TickingClocks/Zoetrope-Carousel-V4/Electrical/01b_V4 Electrical Plots/photos/deadbug wiring.jpg

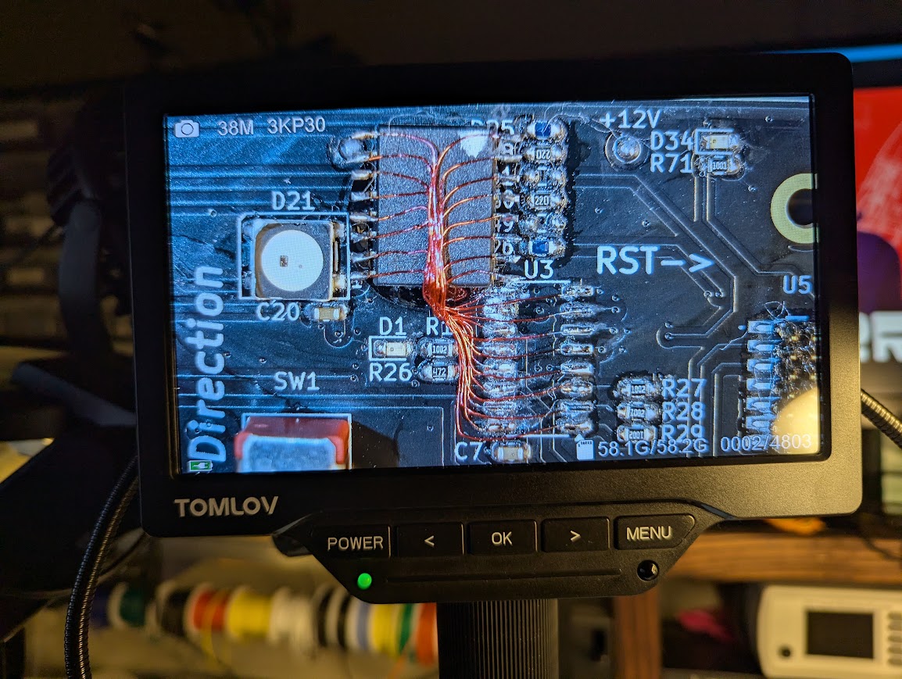
Electrical/01b_V4 Electrical Plots/photos/deadbug wiring.jpg
