TickingClocks/Zoetrope-Carousel-V4/README.md

# Zoetrope-Carousel-V4
repository for the Zoetrope Carousel V4
