TickingClocks/Zoetrope-Carousel-V4/Mechanical/Platters/Phenakistoscopes/Rats/Rats_Hueforge_describe.txt

Print at 100% infill with a layer height of 0.08mm with a base layer of 0.16mm

 The Model is 200x194.16mm in size
 You may print at higher layer heights below the Min Depth of 0.48mm
 The Max Depth is 3mm and the Actual Depth is 3.1mm

Filaments Used:
	PETG JAYO Black Transmission Distance: 0.3
	PETG JAYO Gray Transmission Distance: 2.5
	PLA BambuLab Matte Ivory White Transmission Distance: 3.5
This print uses 3 unique filaments

!!!!  It appears you have mixed filament types.  Be certain this is what you want.  !!!!!

Swap Instructions:
	Start with Black
	At layer #13 (1.12mm) swap to Gray
	At layer #22 (1.84mm) swap to Ivory White for the rest.
