TickingClocks/Zoetrope-Carousel-V4/Electrical/01a_V4 - Saber - Spot Light/slip ring gooseneck assembly/DXF for PCB/slip ring gooseneck assembly PCB outline_V1.DXF

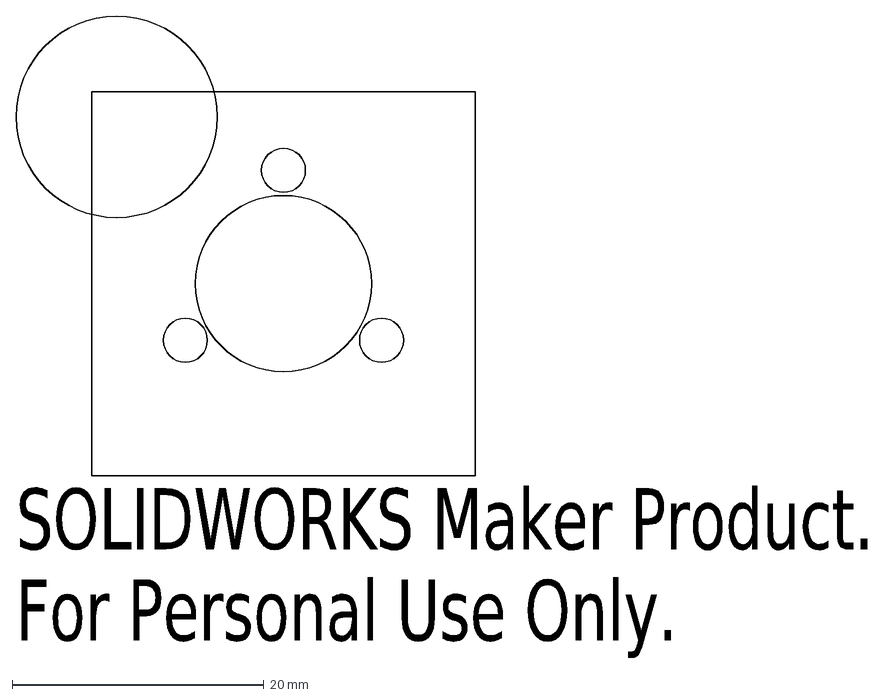
[picture p51: CAD file, 2026-05-01]
Electrical/01a_V4 - Saber - Spot Light/slip ring gooseneck assembly/DXF for PCB/slip ring gooseneck assembly PCB outline_V1.DXF
SOLIDWORKS Maker Product.
For Personal Use Only.
