TickingClocks/Zoetrope-Carousel-V4/Electrical/01a_V4 - Saber - Spot Light/slip ring gooseneck assembly/slip ring gooseneck assembly.SLDPRT

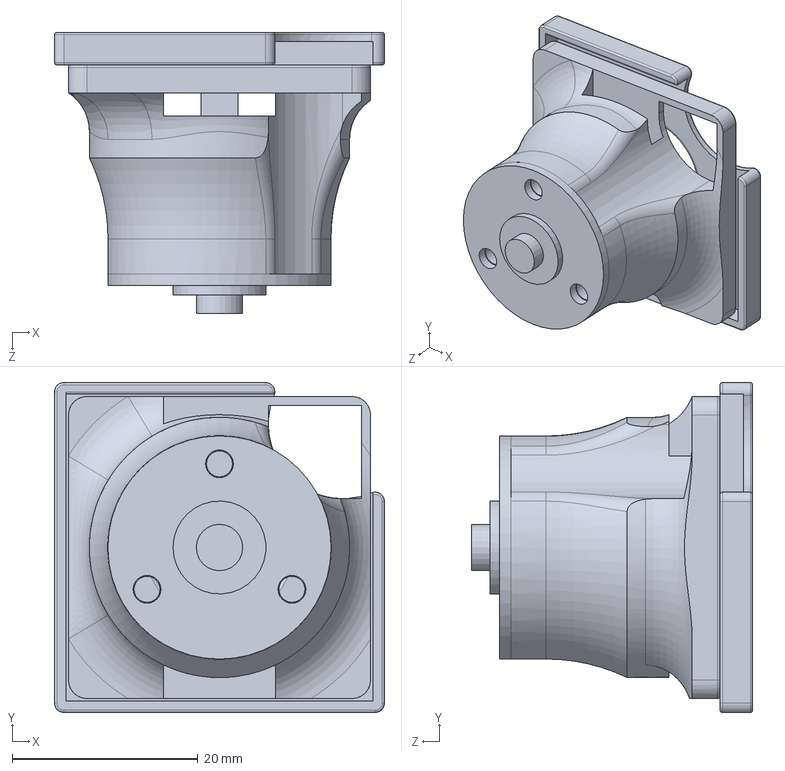
[picture p52: CAD file, 2026-05-01]
Electrical/01a_V4 - Saber - Spot Light/slip ring gooseneck assembly/slip ring gooseneck assembly.SLDPRT
35.5 x 35.5 x 30.2 mm
