TickingClocks/Zoetrope-Carousel-V4/Electrical/01a_V4 - Saber - Spot Light/slip ring gooseneck assembly/step files/slip ring gooseneck assembly_3D Print_V2.STEP

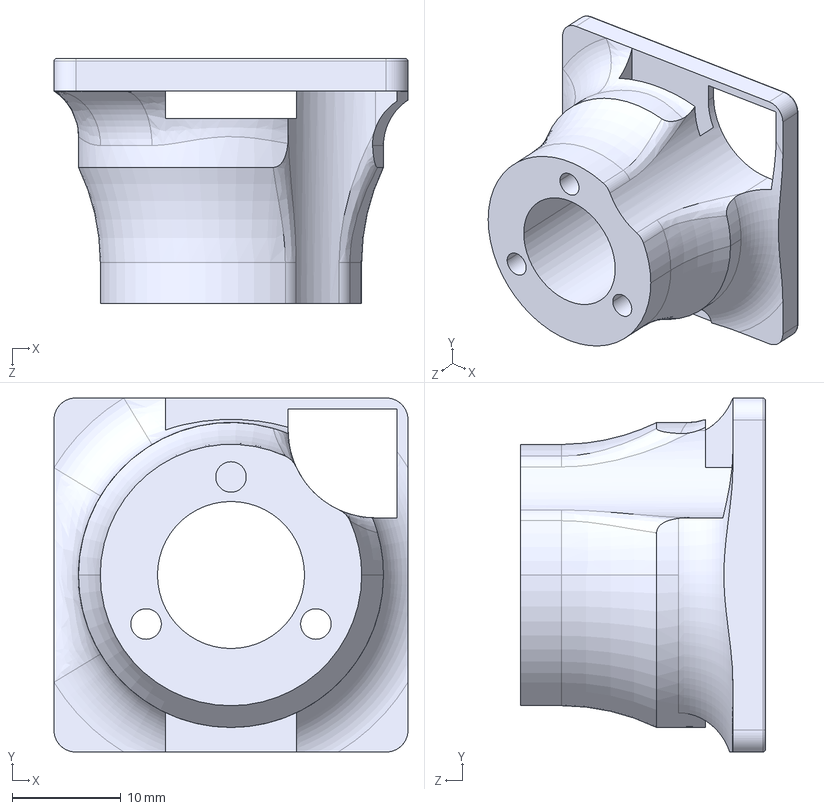
[picture p53: CAD file, 2026-05-01]
Electrical/01a_V4 - Saber - Spot Light/slip ring gooseneck assembly/step files/slip ring gooseneck assembly_3D Print_V2.STEP
32.5 x 32.5 x 22.5 mm
