TickingClocks/Zoetrope-Carousel-V4/Electrical/01b_V4 Electrical Plots/3D prints/paste and assembly jig/Animation Platter V4 - Paste and assembly jig_V1.SLDPRT

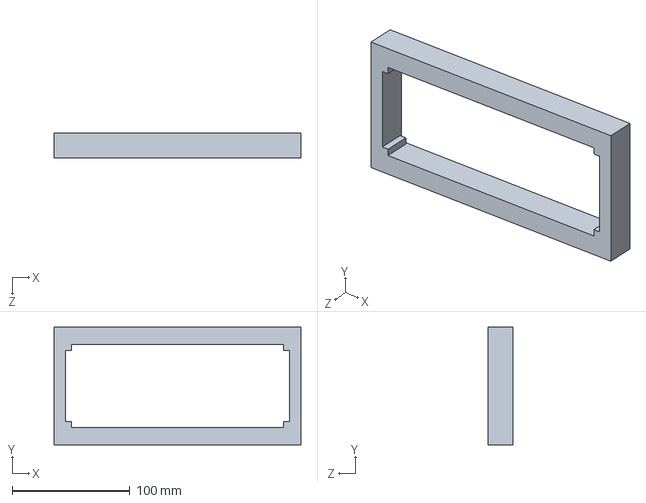
[picture p54: CAD file, 2026-05-01]
Electrical/01b_V4 Electrical Plots/3D prints/paste and assembly jig/Animation Platter V4 - Paste and assembly jig_V1.SLDPRT
210.0 x 100.0 x 21.5 mm
