TickingClocks/Zoetrope-Carousel-V4/Mechanical/Machine Design/V4/3D Prints/V4 Build/Platter Coupler/V6/Animation Platter Coupler_V6_Main Piece.SLDPRT

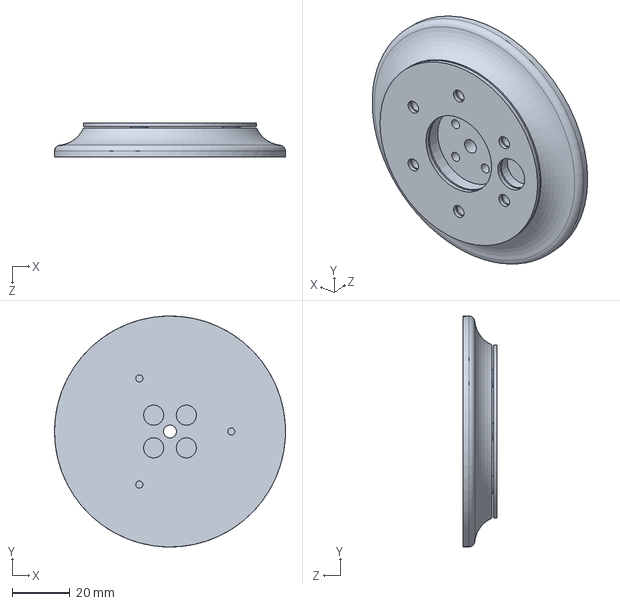
[picture p55: CAD file, 2026-05-01]
Mechanical/Machine Design/V4/3D Prints/V4 Build/Platter Coupler/V6/Animation Platter Coupler_V6_Main Piece.SLDPRT
80.0 x 80.0 x 11.7 mm
