TickingClocks/Zoetrope-Carousel-V4/Electrical/01a_V4 - Saber - Spot Light/slip ring gooseneck assembly/step files/slip ring gooseneck assembly_cap_V1.STEP

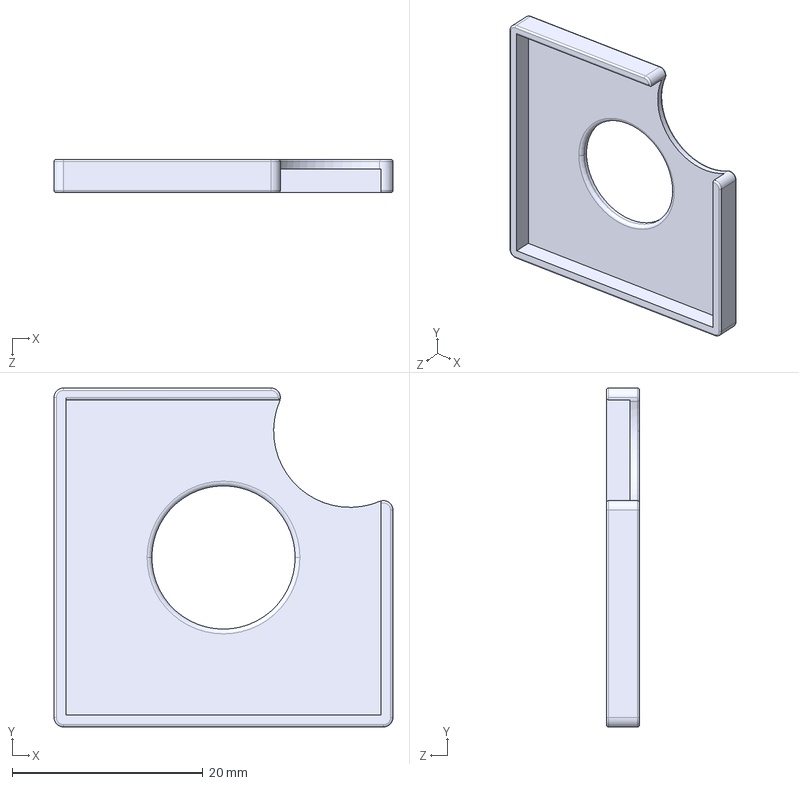
[picture p56: CAD file, 2026-05-01]
Electrical/01a_V4 - Saber - Spot Light/slip ring gooseneck assembly/step files/slip ring gooseneck assembly_cap_V1.STEP
35.5 x 35.5 x 3.50 mm
