TickingClocks/Zoetrope-Carousel-V4/Mechanical/Machine Design/V4/Components/main platform_V3.SLDPRT

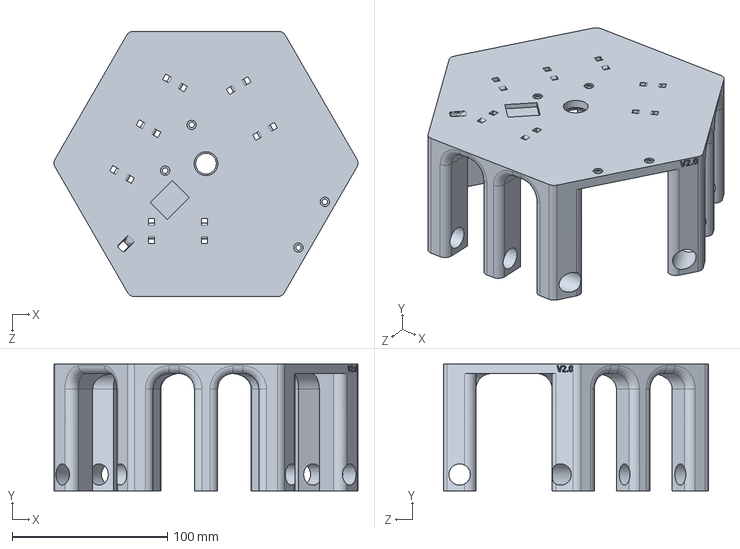
[picture p57: CAD file, 2026-05-01]
Mechanical/Machine Design/V4/Components/main platform_V3.SLDPRT
195.6 x 81.5 x 170.7 mm
