TickingClocks/Zoetrope-Carousel-V4/Electrical/3D Models/TM1637.stp

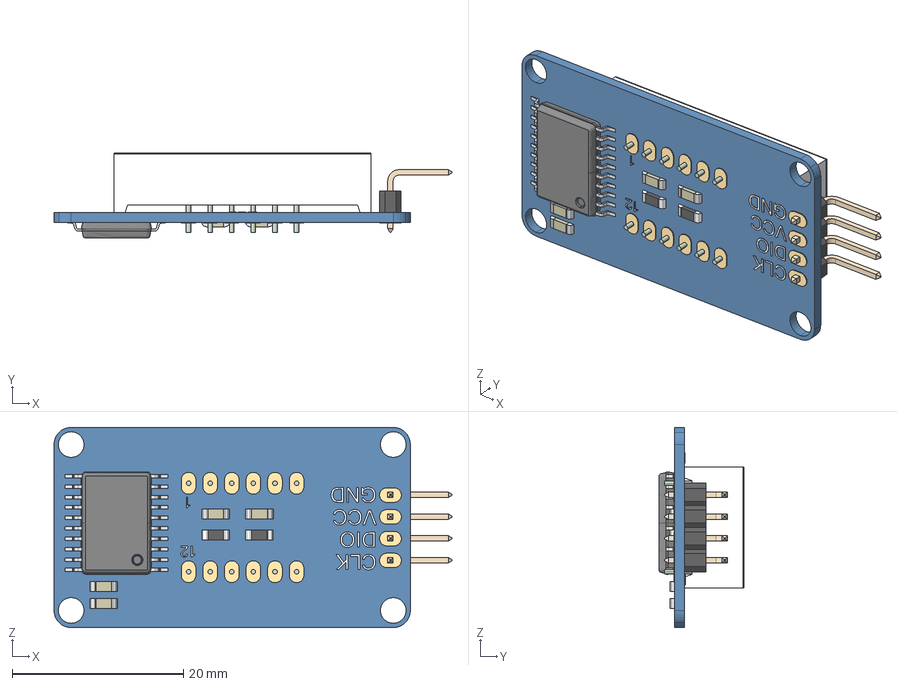
[picture p58: CAD file, 2026-05-01]
Electrical/3D Models/TM1637.stp
46.4 x 9.94 x 23.4 mm
7-Seg Geometry
cap
Pin
4PinsOut Geometry
pin2
C x 4
R Geometry x 2
pin3 x 2
pcb Geometry
CU
text
TSSOP-20 Geometry
