TickingClocks/Zoetrope-Carousel-V4/Mechanical/Machine Design/V4/3D Prints/Platter coupler components/Stepper mount_V2.1.SLDPRT

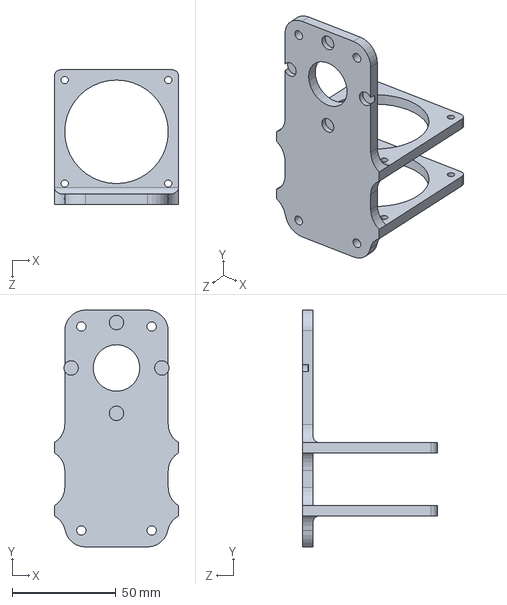
[picture p59: CAD file, 2026-05-01]
Mechanical/Machine Design/V4/3D Prints/Platter coupler components/Stepper mount_V2.1.SLDPRT
60.0 x 114.5 x 65.0 mm
