TickingClocks/Zoetrope-Carousel-V4/Mechanical/Machine Design/V4/3D Prints/V4 Build/corner joint_V5_SwitchMount_V2.STEP

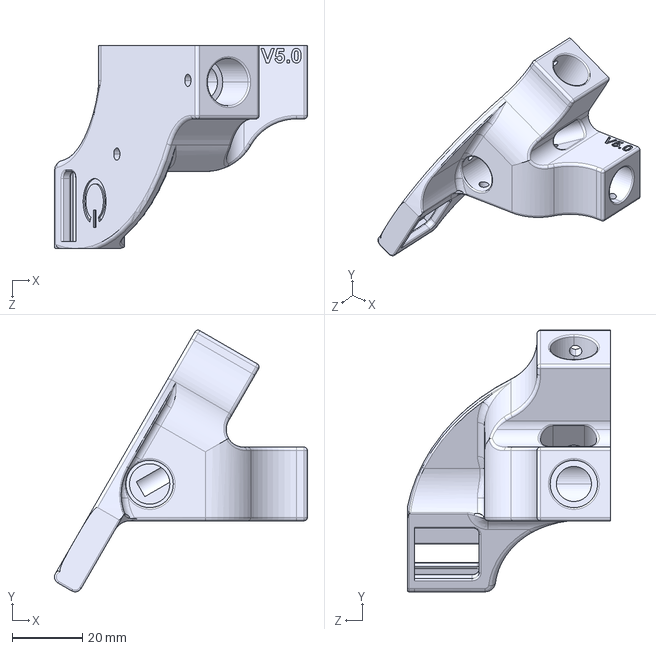
[picture p60: CAD file, 2026-05-01]
Mechanical/Machine Design/V4/3D Prints/V4 Build/corner joint_V5_SwitchMount_V2.STEP
72.1 x 74.6 x 58.0 mm
