TickingClocks/Zoetrope-Carousel-V4/Mechanical/Machine Design/V4/Components/Control Panel Mount_V4.SLDPRT

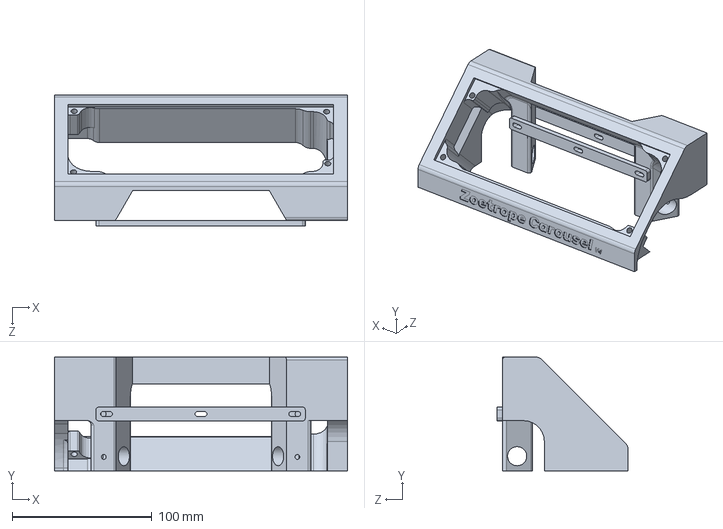
[picture p61: CAD file, 2026-05-01]
Mechanical/Machine Design/V4/Components/Control Panel Mount_V4.SLDPRT
210.0 x 81.5 x 94.0 mm
