TickingClocks/Zoetrope-Carousel-V4/Mechanical/Machine Design/V4/Components/not 3d printed/flange shaft coupling_V1.SLDPRT

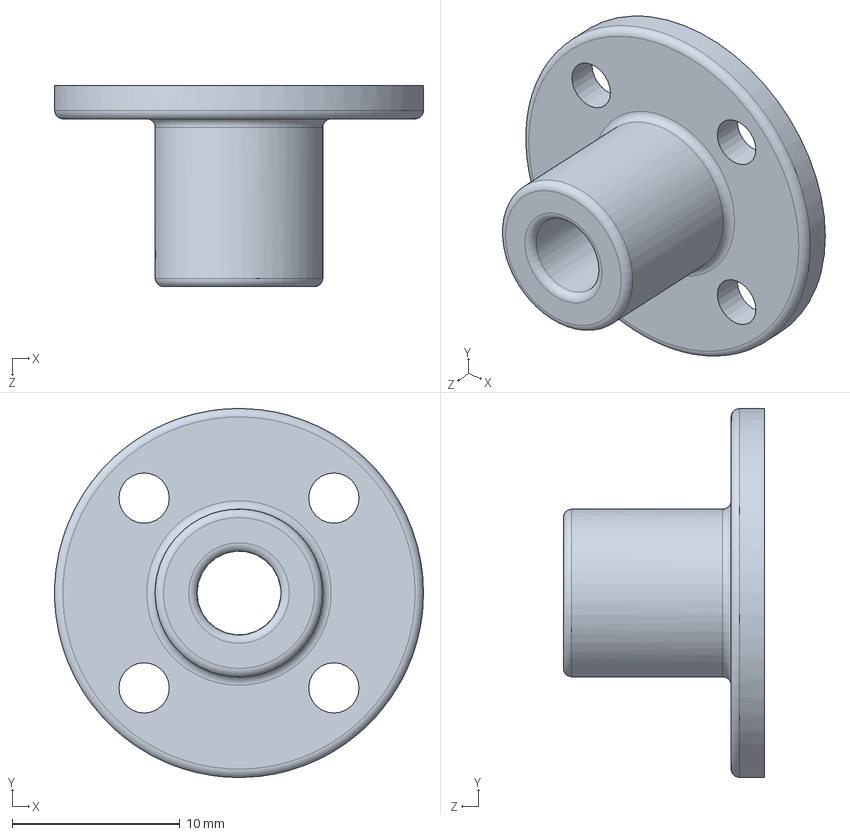
[picture p62: CAD file, 2026-05-01]
Mechanical/Machine Design/V4/Components/not 3d printed/flange shaft coupling_V1.SLDPRT
22.0 x 22.0 x 12.0 mm
