TickingClocks/Zoetrope-Carousel-V4/Mechanical/Machine Design/V4/Components/saber/gooseneck_effector end/effector connector_v2.SLDPRT

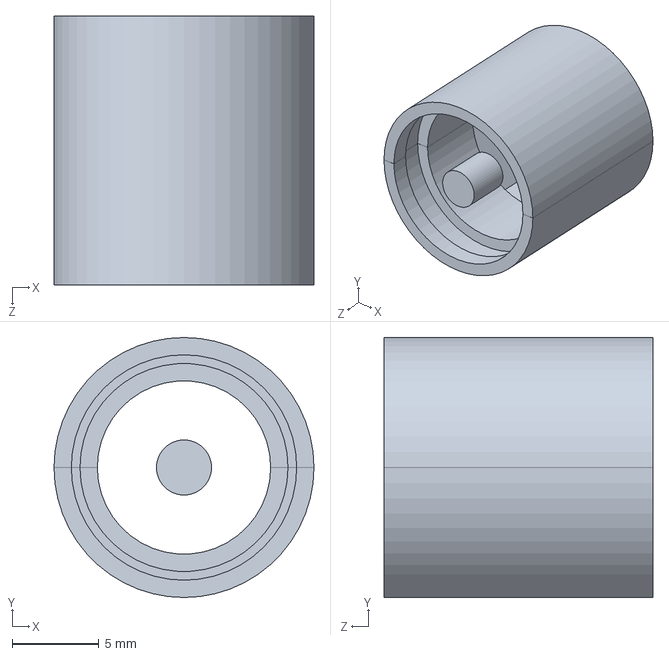
[picture p63: CAD file, 2026-05-01]
Mechanical/Machine Design/V4/Components/saber/gooseneck_effector end/effector connector_v2.SLDPRT
15.0 x 15.0 x 15.5 mm
