TickingClocks/Zoetrope-Carousel-V4/Mechanical/Machine Design/V4/Components/saber/gooseneck_xlr connector end/gooseneck_xlr connector end_v1.SLDPRT

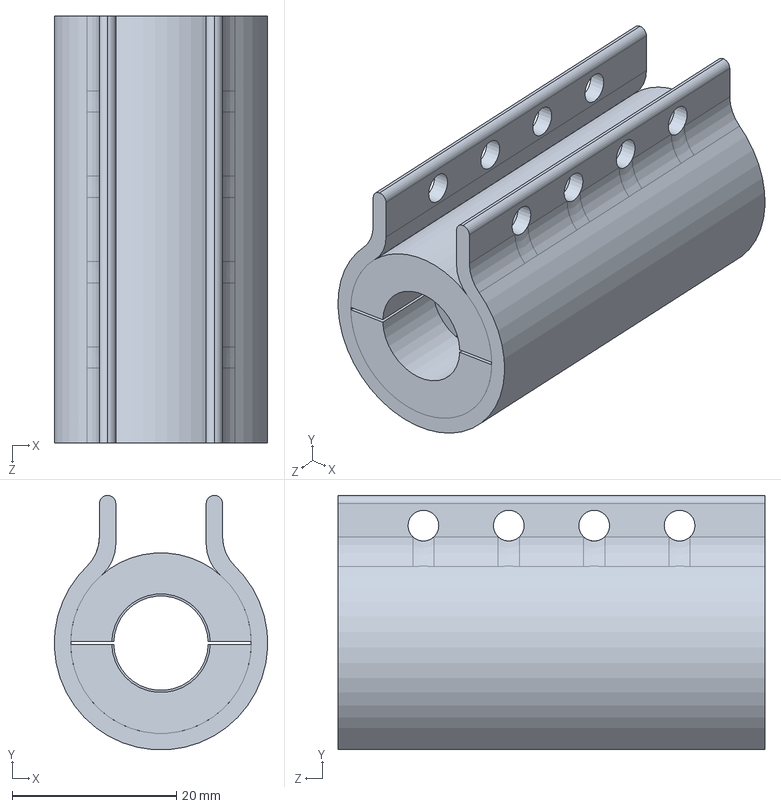
[picture p64: CAD file, 2026-05-01]
Mechanical/Machine Design/V4/Components/saber/gooseneck_xlr connector end/gooseneck_xlr connector end_v1.SLDPRT
26.0 x 31.0 x 52.0 mm
