TickingClocks/Zoetrope-Carousel-V4/Mechanical/Machine Design/V4/Components/saber/gooseneck_xlr connector end/steps for printing/sleeve_v2.STEP

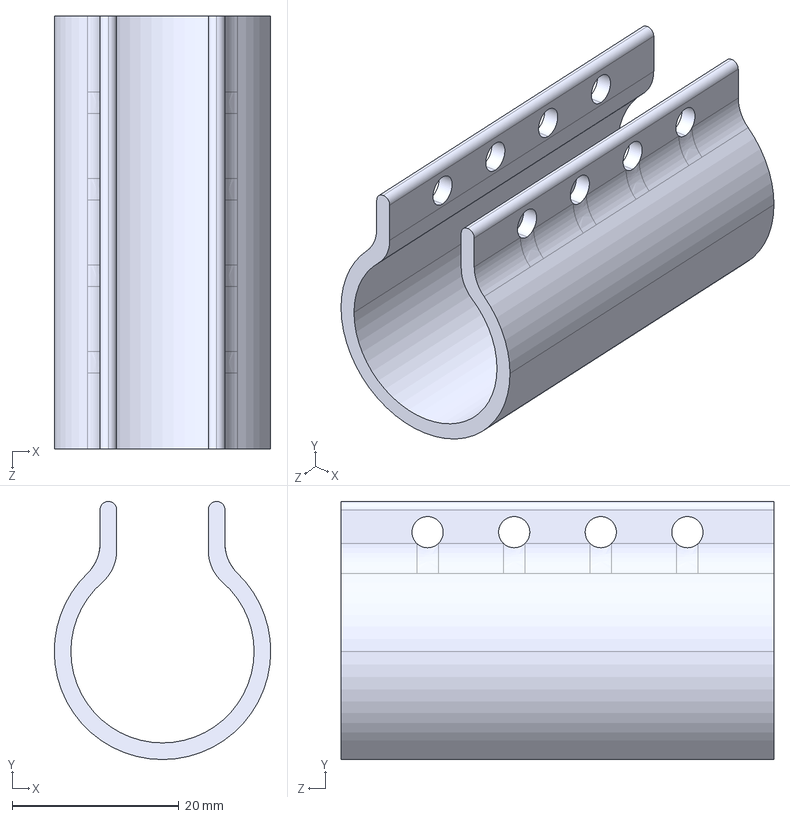
[picture p65: CAD file, 2026-05-01]
Mechanical/Machine Design/V4/Components/saber/gooseneck_xlr connector end/steps for printing/sleeve_v2.STEP
26.0 x 31.0 x 52.0 mm
