TickingClocks/Zoetrope-Carousel-V4/Mechanical/Platters/00_templates/2D/20 slice 200mm pattern.DXF

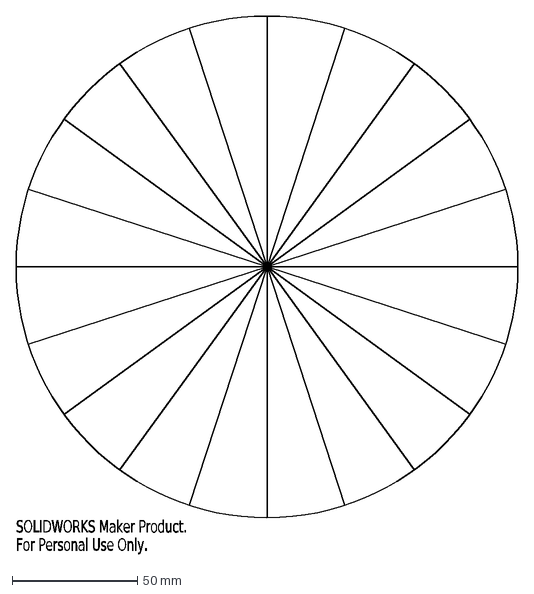
[picture p66: CAD file, 2026-05-01]
Mechanical/Platters/00_templates/2D/20 slice 200mm pattern.DXF
SOLIDWORKS Maker Product.
For Personal Use Only.
