TickingClocks/Zoetrope-Carousel-V4/Mechanical/Platters/00_templates/NFC Platter/Blank NFC Enabled Platter_230mm.SLDPRT

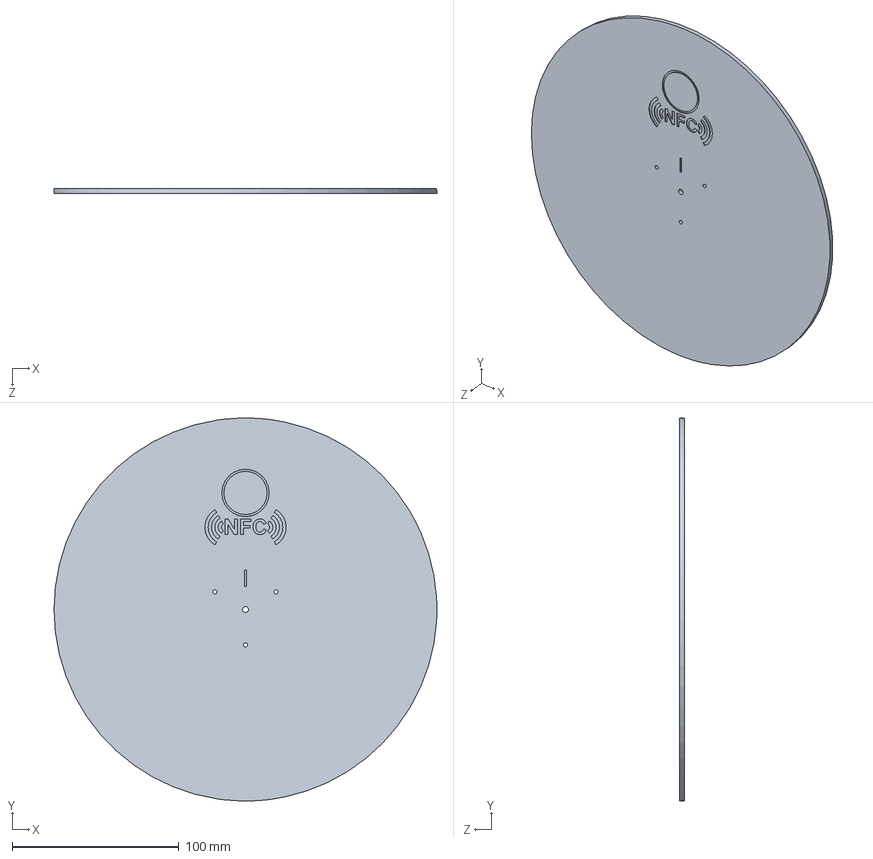
[picture p67: CAD file, 2026-05-01]
Mechanical/Platters/00_templates/NFC Platter/Blank NFC Enabled Platter_230mm.SLDPRT
230.0 x 230.0 x 2.80 mm
