TickingClocks/Zoetrope-Carousel-V4/Mechanical/Platters/Clock Platter 1/Clock Platter 2.SLDPRT

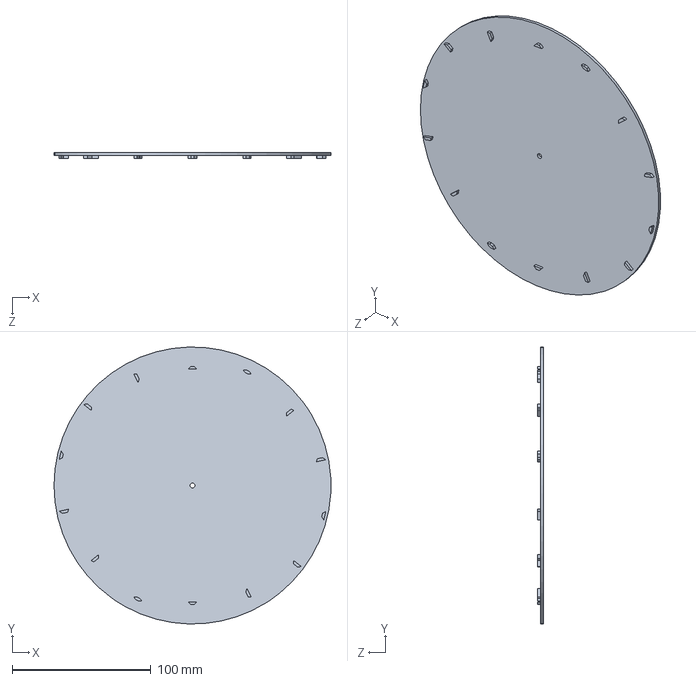
[picture p68: CAD file, 2026-05-01]
Mechanical/Platters/Clock Platter 1/Clock Platter 2.SLDPRT
200.0 x 199.9 x 4.00 mm
