TickingClocks/Zoetrope-Carousel-V4/Mechanical/Platters/Clock Platter 2/Clock Platter 2.SLDPRT

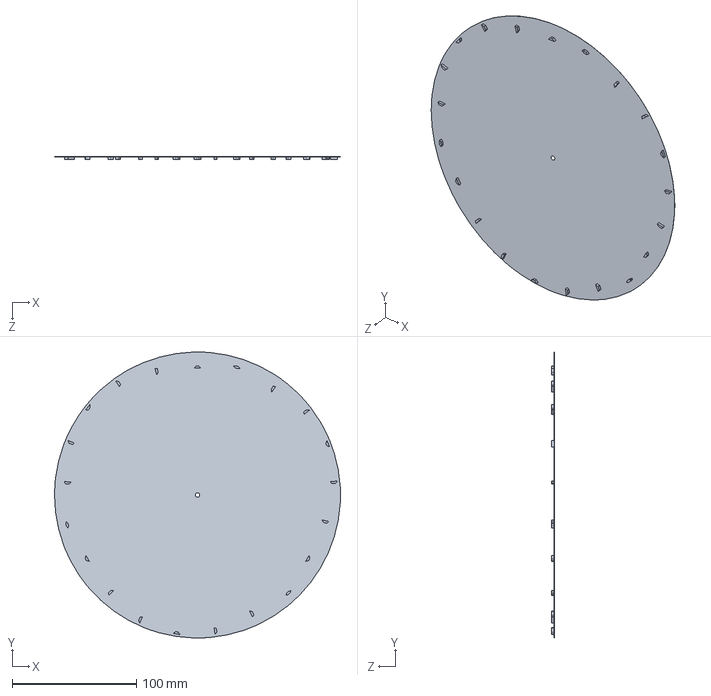
[picture p69: CAD file, 2026-05-01]
Mechanical/Platters/Clock Platter 2/Clock Platter 2.SLDPRT
230.0 x 230.0 x 2.10 mm
