TickingClocks/Zoetrope-Carousel-V4/Mechanical/Platters/Clock Platter 3/Clock Platter 3.STEP

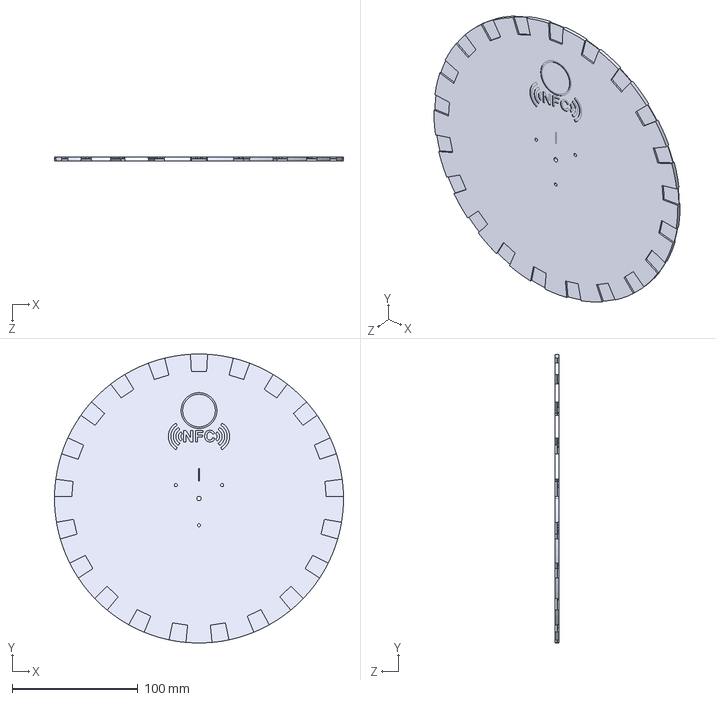
[picture p70: CAD file, 2026-05-01]
Mechanical/Platters/Clock Platter 3/Clock Platter 3.STEP
230.0 x 229.9 x 2.90 mm
