TickingClocks/Zoetrope-Carousel-V4/Mechanical/Platters/Cube/V5/Cube Pattern_V5.SLDPRT

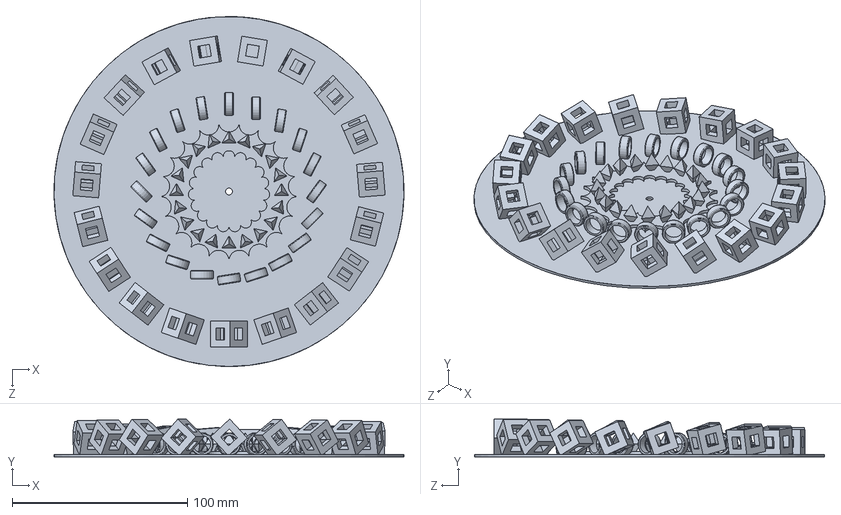
[picture p71: CAD file, 2026-05-01]
Mechanical/Platters/Cube/V5/Cube Pattern_V5.SLDPRT
200.0 x 21.7 x 200.0 mm
