TickingClocks/Zoetrope-Carousel-V4/Mechanical/Platters/Pacman/Pacman Platter_V1.SLDPRT

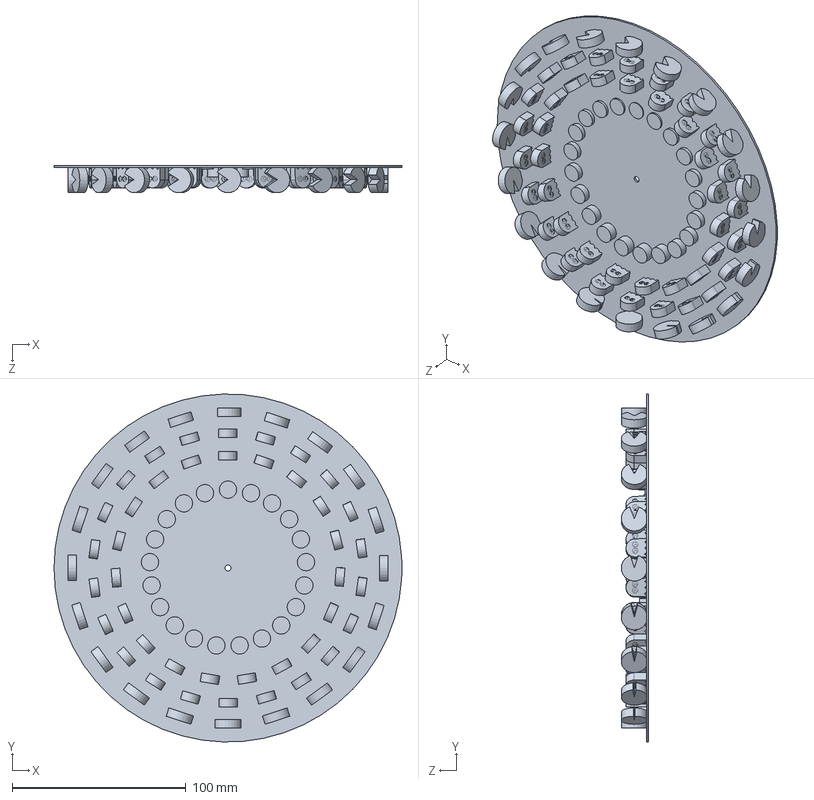
[picture p72: CAD file, 2026-05-01]
Mechanical/Platters/Pacman/Pacman Platter_V1.SLDPRT
200.0 x 199.9 x 15.8 mm
