TickingClocks/Zoetrope-Carousel-V4/Mechanical/Machine Design/V4/3D Prints/V4 Build/corner joint_V5_SwitchMount_V1.STEP

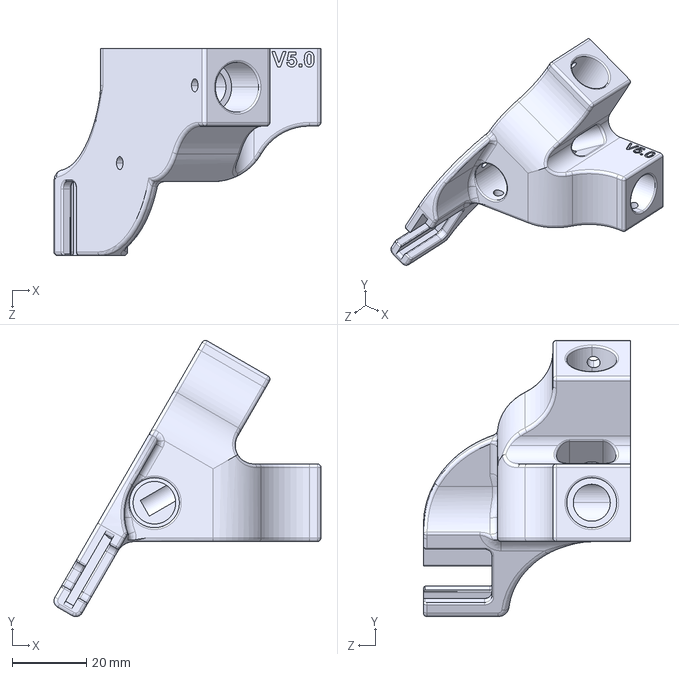
[picture p73: CAD file, 2026-05-01]
Mechanical/Machine Design/V4/3D Prints/V4 Build/corner joint_V5_SwitchMount_V1.STEP
72.1 x 74.6 x 56.0 mm
