TickingClocks/Zoetrope-Carousel-V4/Mechanical/Machine Design/V4/Components/corner joint_V3.SLDPRT

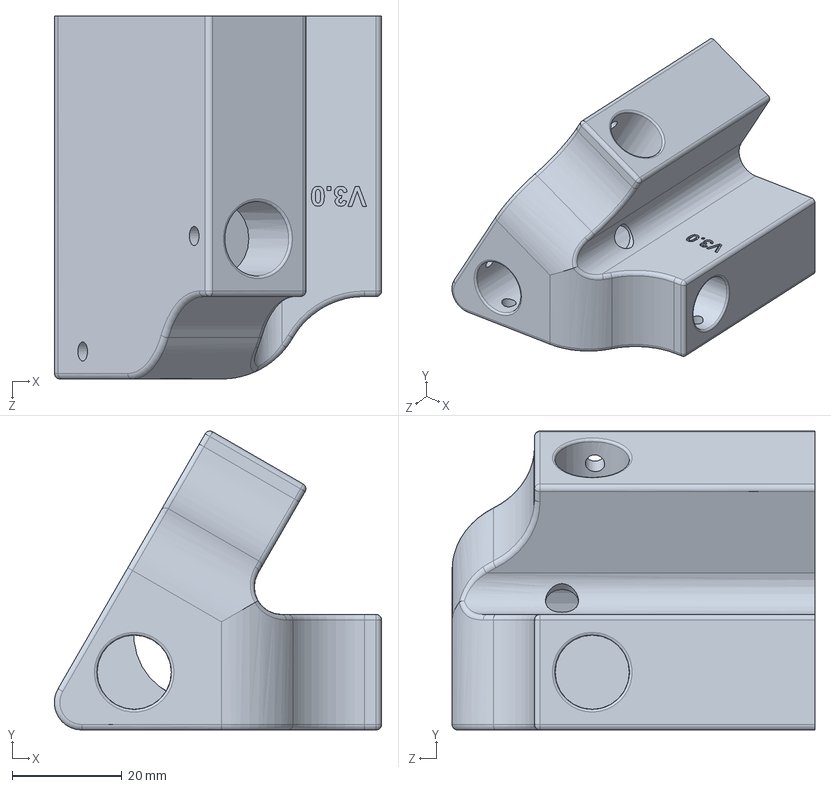
[picture p74: CAD file, 2026-05-01]
Mechanical/Machine Design/V4/Components/corner joint_V3.SLDPRT
59.5 x 54.4 x 66.0 mm
