TickingClocks/Zoetrope-Carousel-V4/Mechanical/Machine Design/V4/Components/not 3d printed/Noctua Fan_V1.SLDPRT

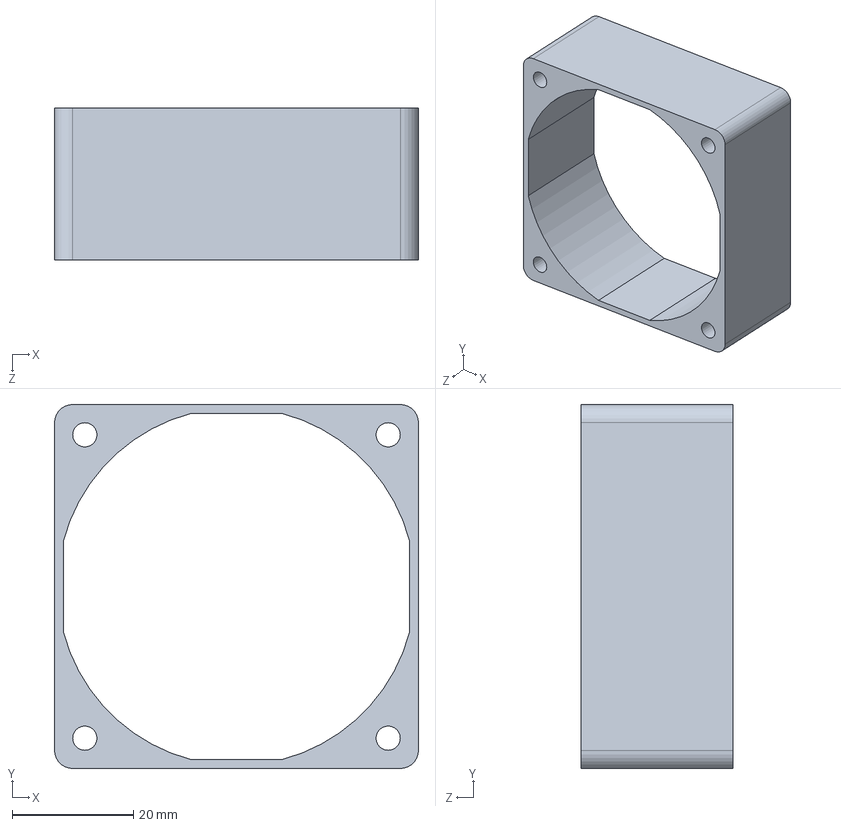
[picture p75: CAD file, 2026-05-01]
Mechanical/Machine Design/V4/Components/not 3d printed/Noctua Fan_V1.SLDPRT
60.0 x 60.0 x 25.0 mm
