TickingClocks/Zoetrope-Carousel-V4/Mechanical/Machine Design/V4/Components/saber/3D Print step/effector connector_sleeve_V1.STEP

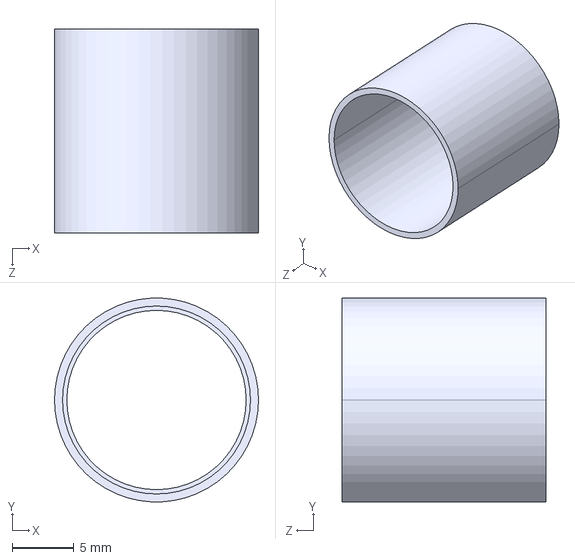
[picture p76: CAD file, 2026-05-01]
Mechanical/Machine Design/V4/Components/saber/3D Print step/effector connector_sleeve_V1.STEP
16.5 x 16.5 x 16.5 mm
