TickingClocks/Zoetrope-Carousel-V4/Mechanical/Platters/00_templates/NFC Platter/Blank NFC Enabled Platter.SLDPRT

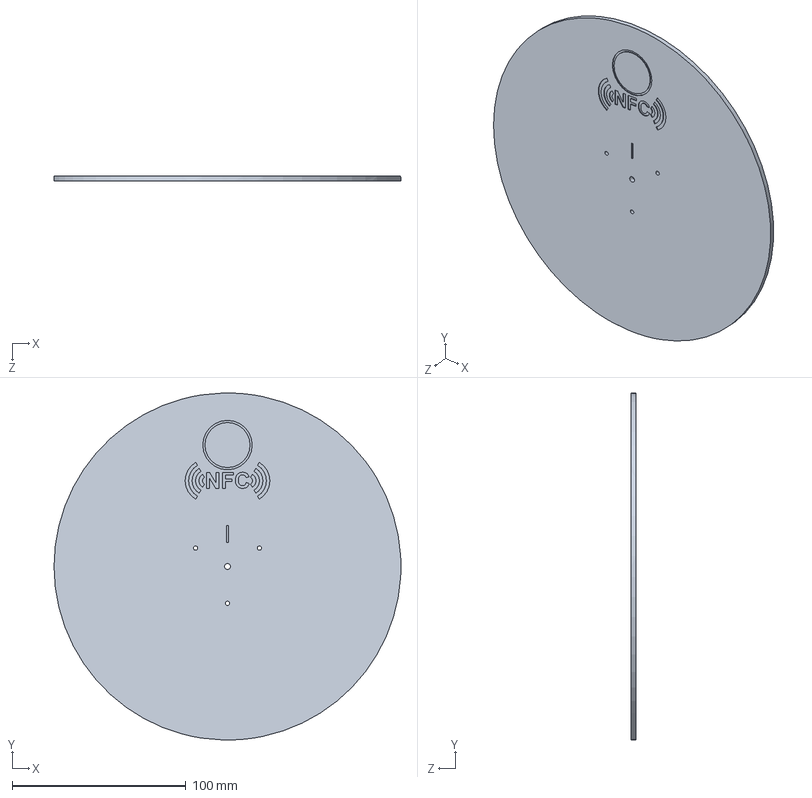
[picture p77: CAD file, 2026-05-01]
Mechanical/Platters/00_templates/NFC Platter/Blank NFC Enabled Platter.SLDPRT
200.0 x 200.0 x 2.80 mm
