TickingClocks/Zoetrope-Carousel-V4/Mechanical/Platters/Clock Platter 1/Clock Platter 1.SLDPRT

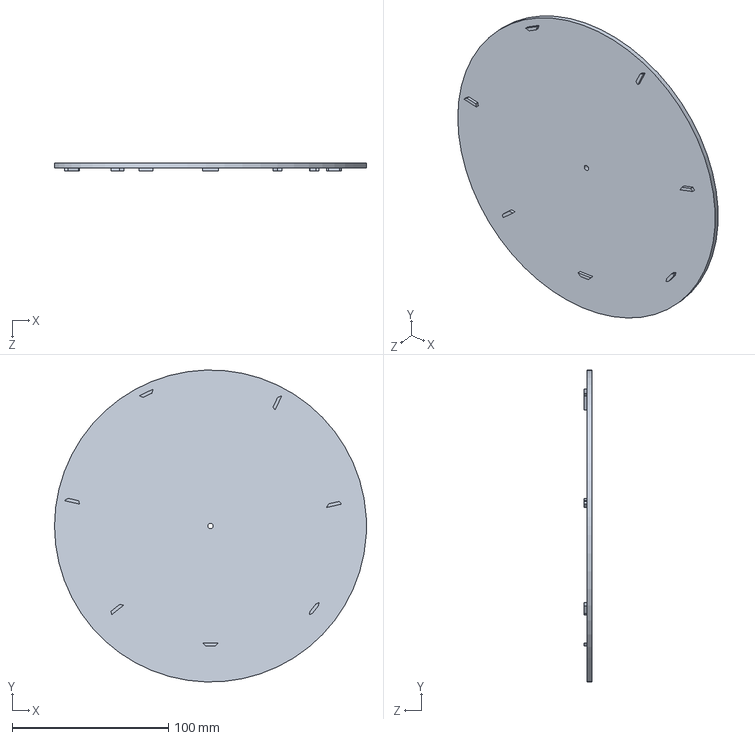
[picture p78: CAD file, 2026-05-01]
Mechanical/Platters/Clock Platter 1/Clock Platter 1.SLDPRT
200.0 x 199.9 x 5.00 mm
