TickingClocks/Zoetrope-Carousel-V4/Mechanical/Platters/Color Morph Test/Color Morph Test_V2.SLDPRT

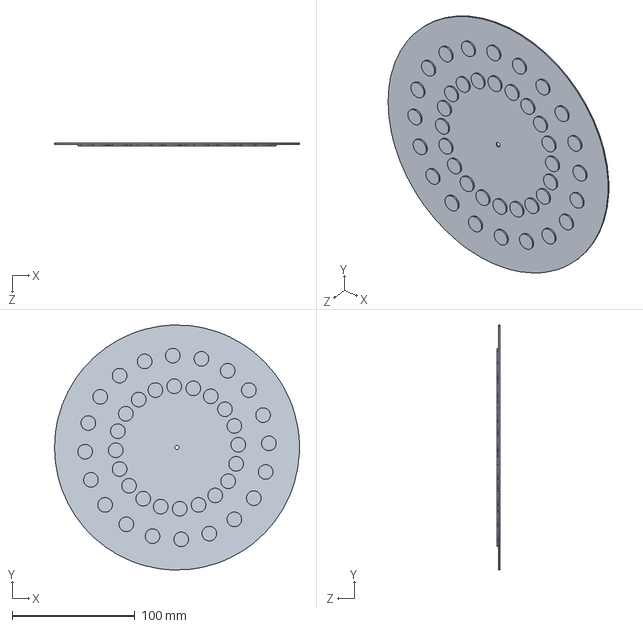
[picture p79: CAD file, 2026-05-01]
Mechanical/Platters/Color Morph Test/Color Morph Test_V2.SLDPRT
200.0 x 199.9 x 2.20 mm
