TickingClocks/Zoetrope-Carousel-V4/Mechanical/Platters/Pixel Platter/Pixel Platter 3D Print_V2/Pixel Platter 3D Print_V3.STEP

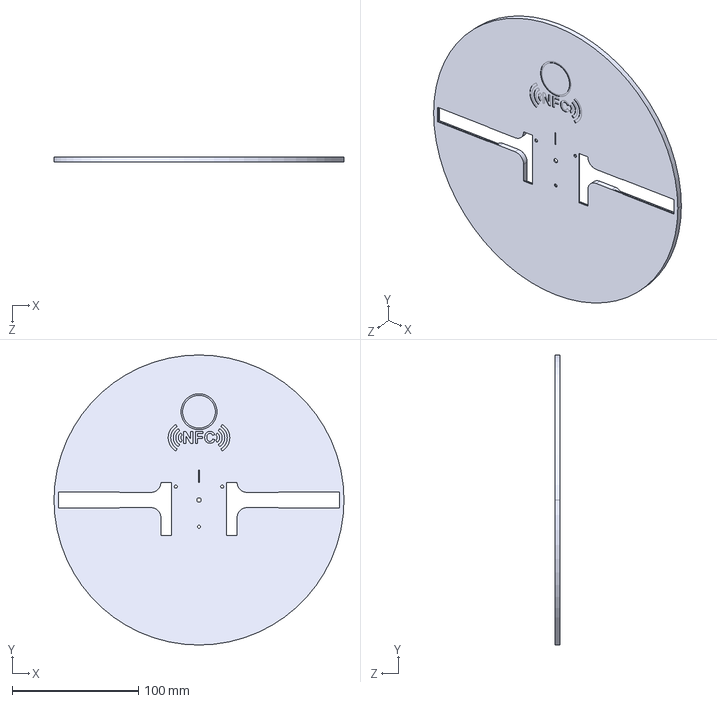
[picture p80: CAD file, 2026-05-07]
Mechanical/Platters/Pixel Platter/Pixel Platter 3D Print_V2/Pixel Platter 3D Print_V3.STEP
230.0 x 230.0 x 4.30 mm
