TickingClocks/Zoetrope-Carousel-V4/Electrical/3D Models/TO263-3-2.stp

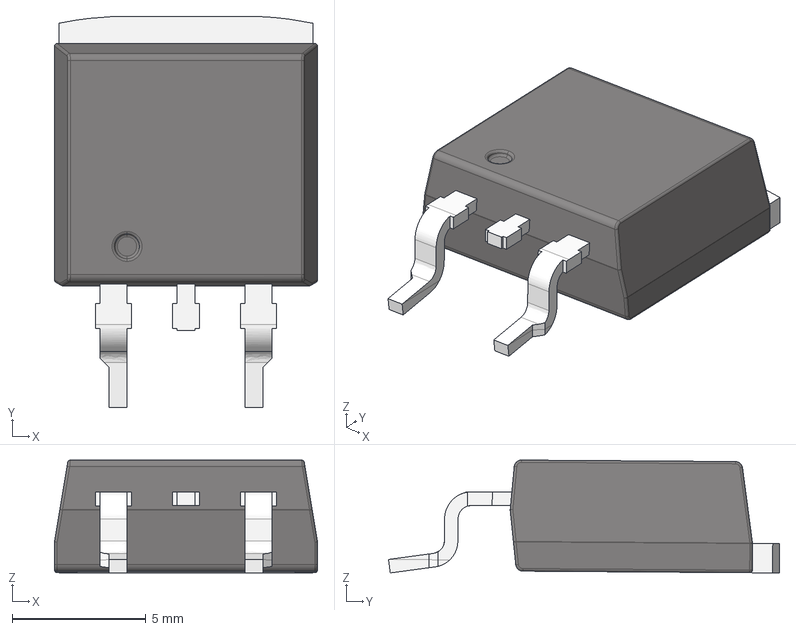
[picture p81: CAD file, 2026-05-01]
Electrical/3D Models/TO263-3-2.stp
9.82 x 14.6 x 4.22 mm
