TickingClocks/Zoetrope-Carousel-V4/Mechanical/Machine Design/V4/Components/not 3d printed/stepper motor_V1.SLDPRT

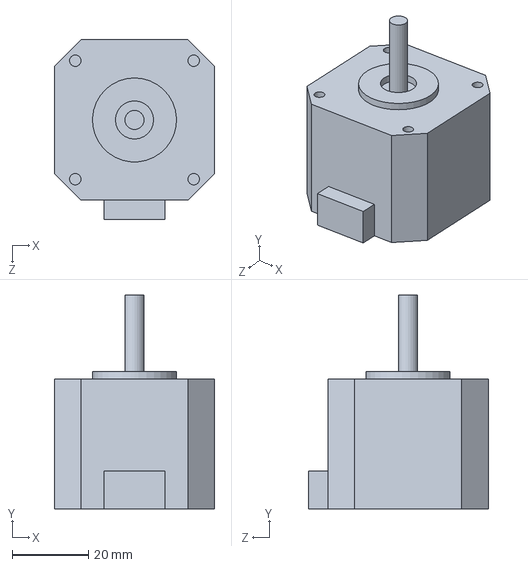
[picture p82: CAD file, 2026-05-01]
Mechanical/Machine Design/V4/Components/not 3d printed/stepper motor_V1.SLDPRT
42.0 x 56.0 x 47.0 mm
