TickingClocks/Zoetrope-Carousel-V4/Mechanical/Machine Design/V4/Components/saber/gooseneck_xlr connector end/steps for printing/side2_V2.STEP

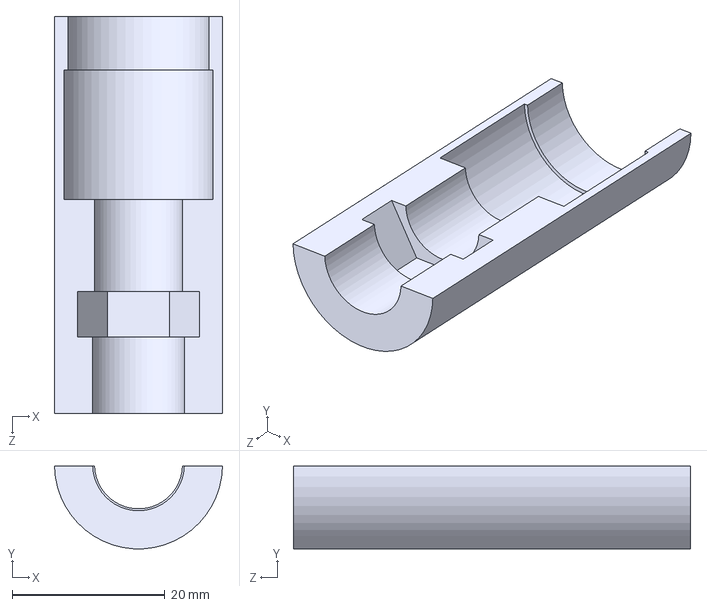
[picture p83: CAD file, 2026-05-01]
Mechanical/Machine Design/V4/Components/saber/gooseneck_xlr connector end/steps for printing/side2_V2.STEP
22.0 x 10.8 x 52.0 mm
