TickingClocks/Zoetrope-Carousel-V4/Mechanical/Platters/Clock Platter 1/Clock Platter 3.SLDPRT

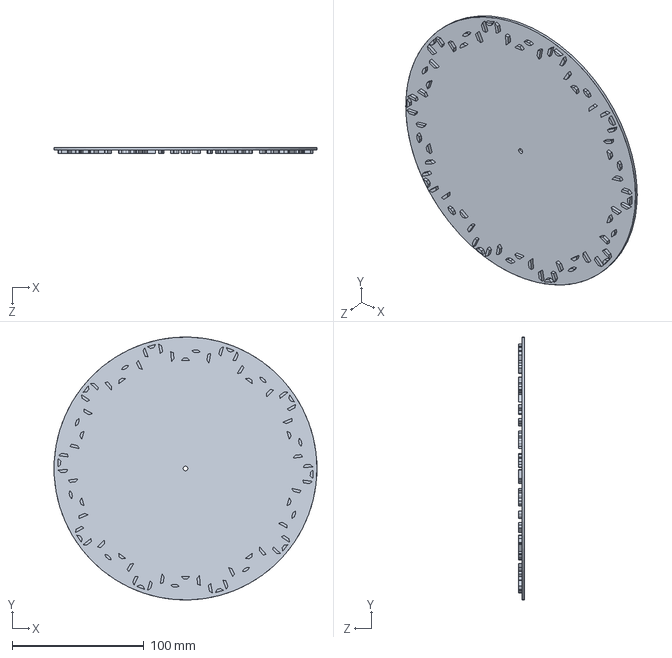
[picture p84: CAD file, 2026-05-01]
Mechanical/Platters/Clock Platter 1/Clock Platter 3.SLDPRT
200.0 x 199.9 x 4.50 mm
