TickingClocks/Zoetrope-Carousel-V4/Mechanical/Machine Design/V4/Components/not 3d printed/Aluminum Rod_V1.SLDPRT

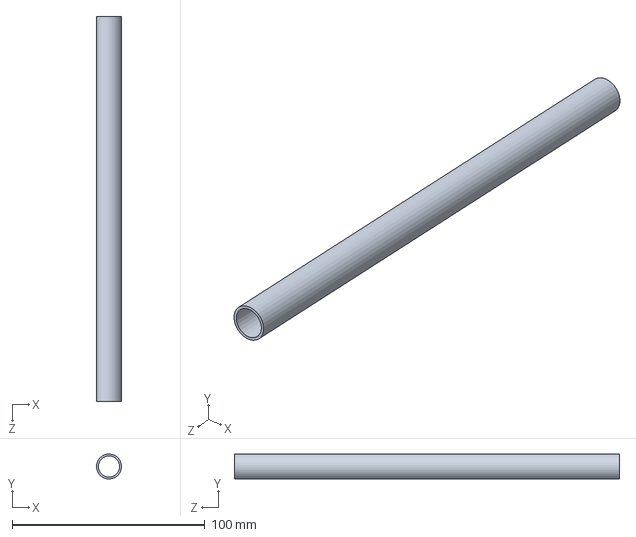
[picture p85: CAD file, 2026-05-01]
Mechanical/Machine Design/V4/Components/not 3d printed/Aluminum Rod_V1.SLDPRT
13.0 x 13.0 x 200.0 mm
