TickingClocks/Zoetrope-Carousel-V4/Mechanical/Machine Design/V4/Components/LED Strip Holder_V3.SLDPRT

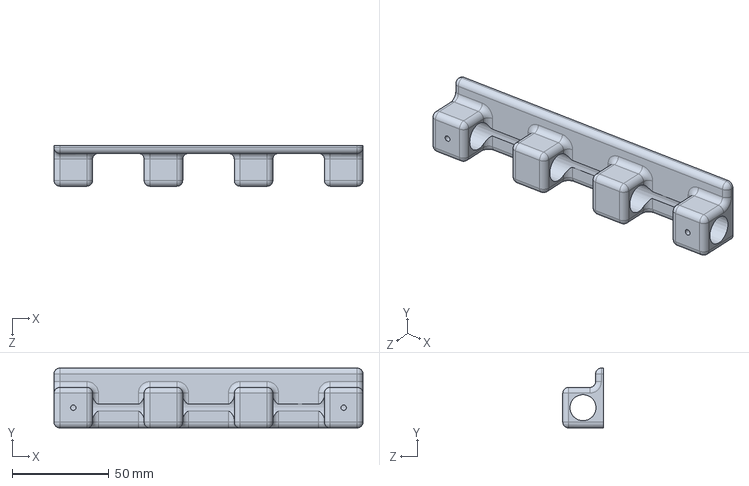
[picture p86: CAD file, 2026-05-01]
Mechanical/Machine Design/V4/Components/LED Strip Holder_V3.SLDPRT
160.0 x 31.0 x 21.0 mm
