TickingClocks/Zoetrope-Carousel-V4/Mechanical/Machine Design/V4/Components/corner joint_V4_With XLR Connector.SLDPRT

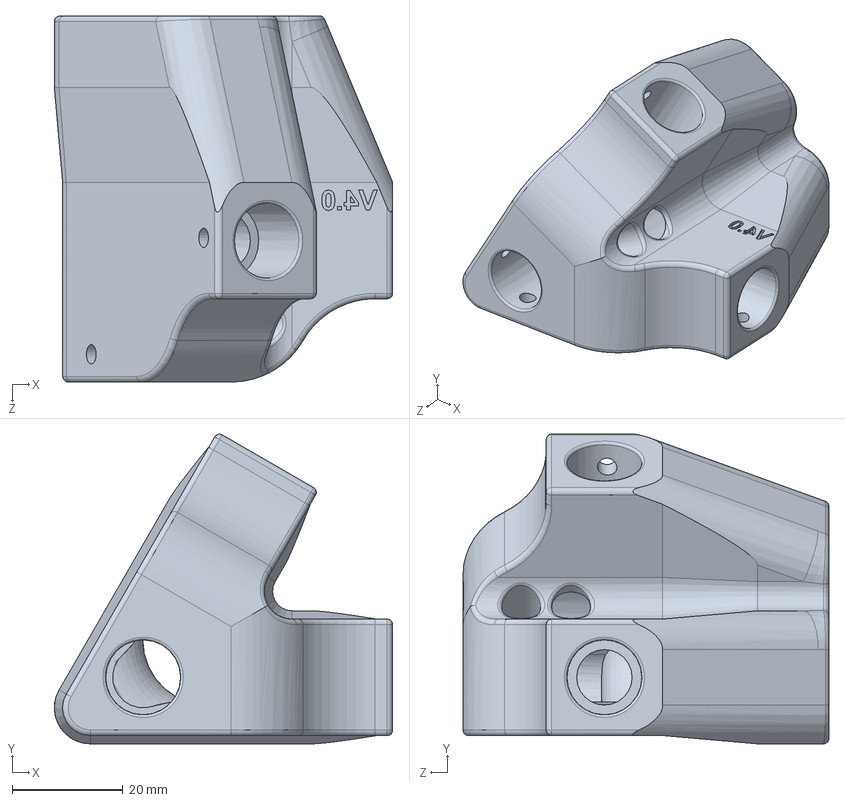
[picture p87: CAD file, 2026-05-01]
Mechanical/Machine Design/V4/Components/corner joint_V4_With XLR Connector.SLDPRT
61.0 x 55.9 x 66.0 mm
