TickingClocks/Zoetrope-Carousel-V4/Mechanical/Machine Design/V4/Components/saber/3D Print step/effector connector_side1_V2.STEP

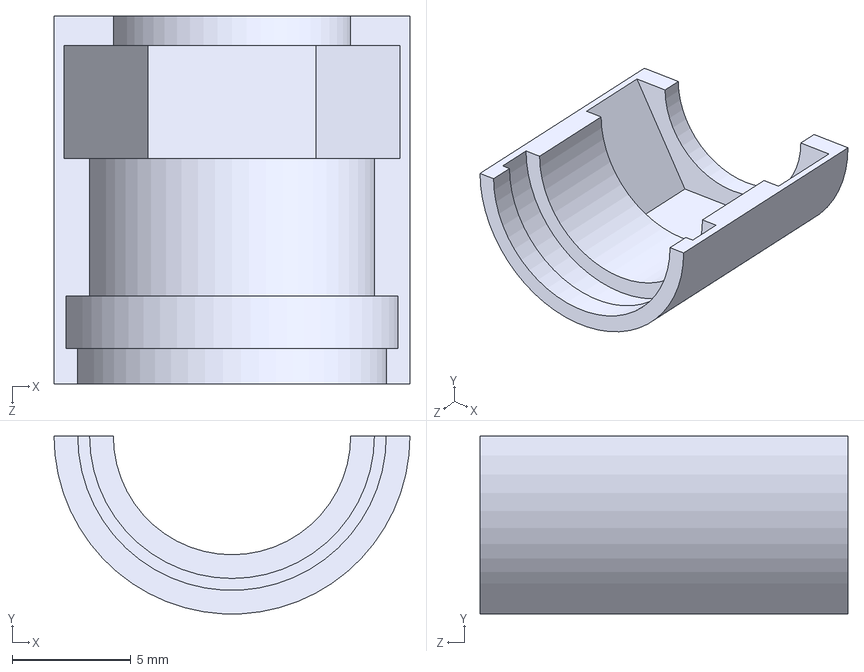
[picture p88: CAD file, 2026-05-01]
Mechanical/Machine Design/V4/Components/saber/3D Print step/effector connector_side1_V2.STEP
15.0 x 7.48 x 15.5 mm
