TickingClocks/Zoetrope-Carousel-V4/Mechanical/Machine Design/V4/Components/saber/3D Print step/PCB mount_V3.STEP

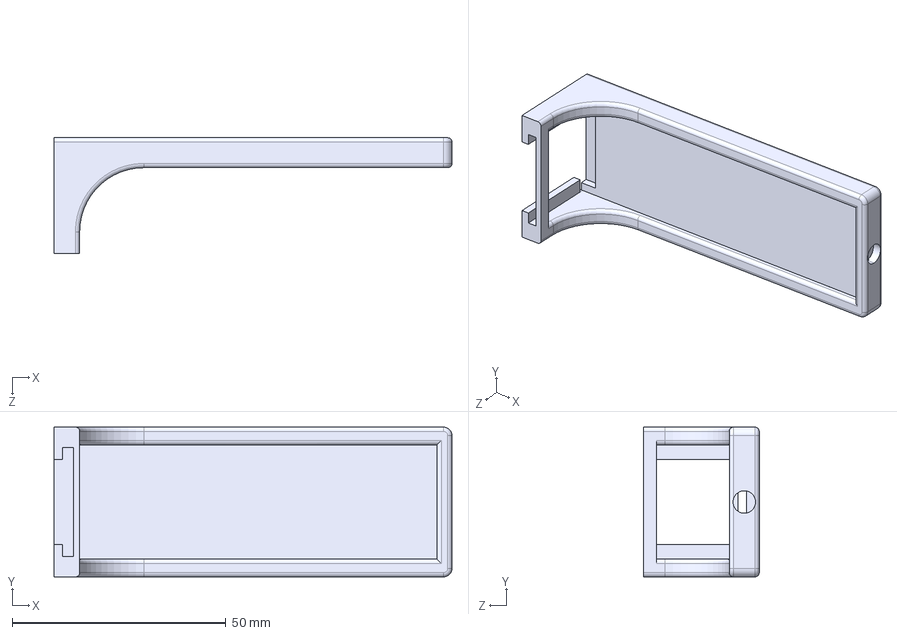
[picture p89: CAD file, 2026-05-01]
Mechanical/Machine Design/V4/Components/saber/3D Print step/PCB mount_V3.STEP
93.0 x 35.0 x 27.0 mm
