TickingClocks/Zoetrope-Carousel-V4/Mechanical/Machine Design/V4/Components/saber/3D Print step/light shade cover_v3.STEP

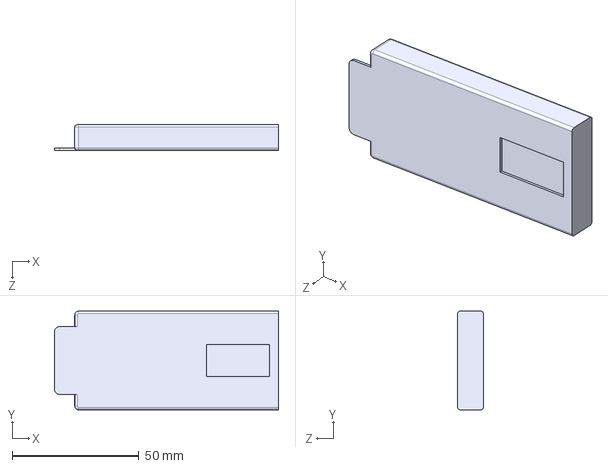
[picture p90: CAD file, 2026-05-01]
Mechanical/Machine Design/V4/Components/saber/3D Print step/light shade cover_v3.STEP
88.5 x 39.0 x 10.1 mm
