TickingClocks/Zoetrope-Carousel-V4/Mechanical/Machine Design/V4/Components/corner joint With Cable Passthrough_V2.SLDPRT

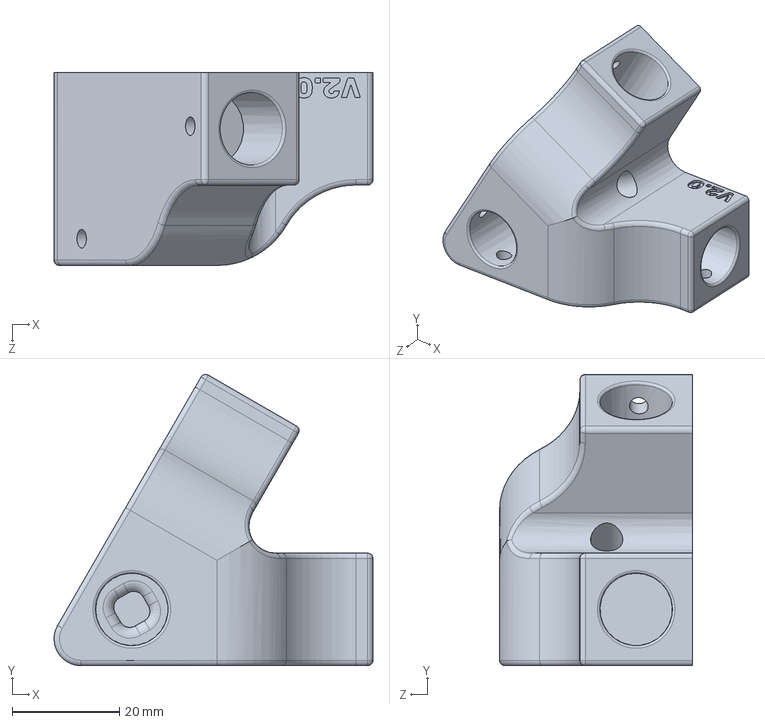
[picture p91: CAD file, 2026-05-01]
Mechanical/Machine Design/V4/Components/corner joint With Cable Passthrough_V2.SLDPRT
59.5 x 54.4 x 36.0 mm
