TickingClocks/Zoetrope-Carousel-V4/Mechanical/Machine Design/V4/Components/Animation Platter Coupler_V8.SLDPRT

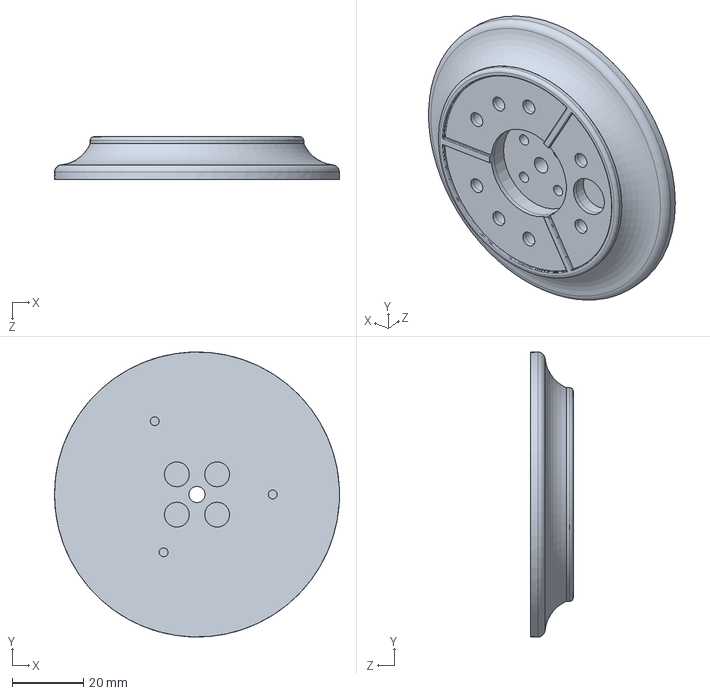
[picture p92: CAD file, 2026-05-01]
Mechanical/Machine Design/V4/Components/Animation Platter Coupler_V8.SLDPRT
80.0 x 80.0 x 11.9 mm
