TickingClocks/Zoetrope-Carousel-V4/Mechanical/Machine Design/V4/Components/corner joint_V5_standard.SLDPRT

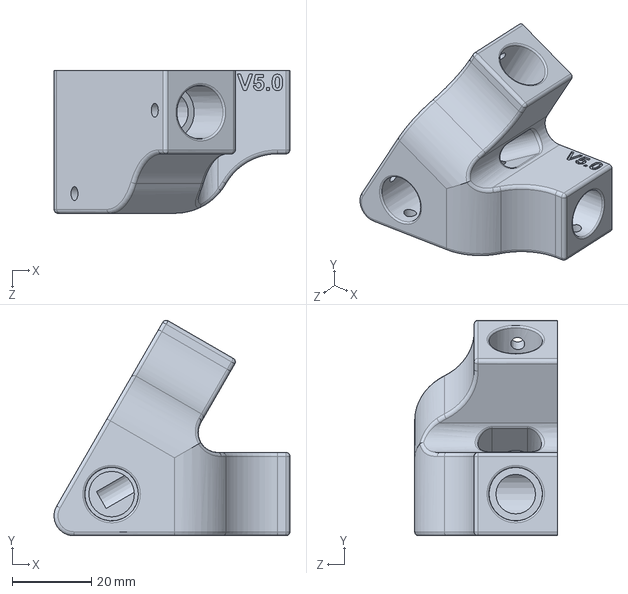
[picture p93: CAD file, 2026-05-01]
Mechanical/Machine Design/V4/Components/corner joint_V5_standard.SLDPRT
59.5 x 54.4 x 36.0 mm
