TickingClocks/Zoetrope-Carousel-V4/Mechanical/Machine Design/V4/Components/animation platter coupler threads_V2.SLDPRT

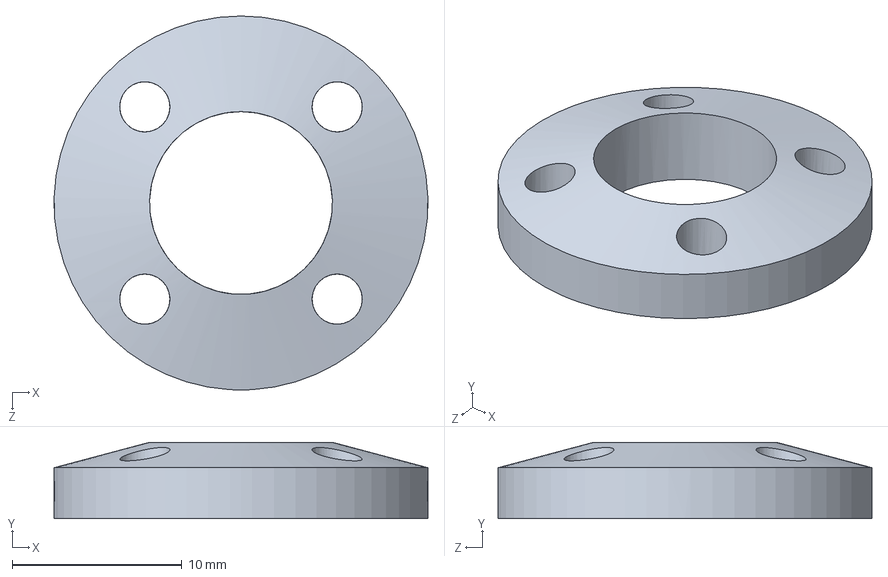
[picture p94: CAD file, 2026-05-01]
Mechanical/Machine Design/V4/Components/animation platter coupler threads_V2.SLDPRT
22.0 x 4.50 x 22.0 mm
