TickingClocks/Zoetrope-Carousel-V4/Mechanical/Machine Design/V4/Components/Animation Platter_V1.SLDPRT

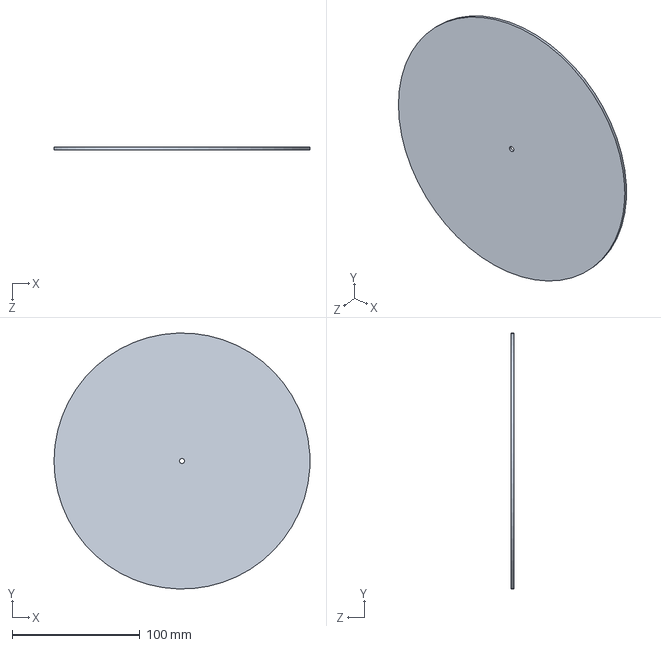
[picture p95: CAD file, 2026-05-01]
Mechanical/Machine Design/V4/Components/Animation Platter_V1.SLDPRT
200.0 x 199.9 x 2.00 mm
