TickingClocks/Zoetrope-Carousel-V4/Mechanical/Platters/Clock Platter 2/Clock Platter 2_assembly.SLDASM

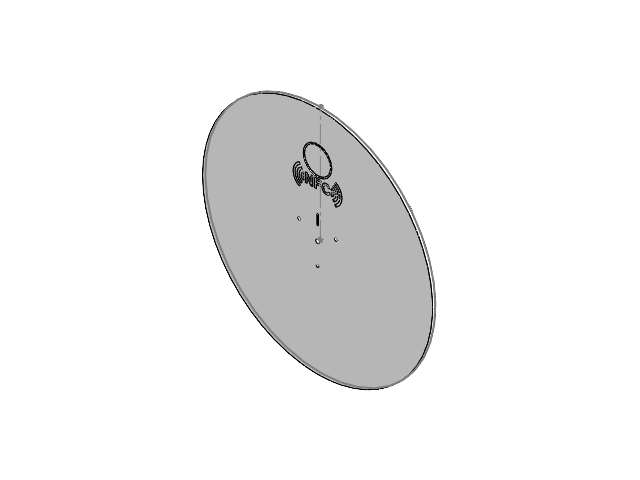
[picture p96: CAD file, 2026-05-01]
Mechanical/Platters/Clock Platter 2/Clock Platter 2_assembly.SLDASM
Part3^Clock Platter 2_assembly
Blank NFC Enabled Platter_230mm
Part4^Clock Platter 2_assembly
Clock Platter 2
