TickingClocks/Zoetrope-Carousel-V4/(list of files, cad)

Other CAD files:
Electrical/03_PCB Reference Stuff/Main Screen Outline.SLDPRT
Electrical/3D Models/circular display/circular display footprint layout.SLDPRT
Mechanical/Platters/00_templates/2D/solidworks/20slices200mm.SLDPRT
Electrical/03_PCB Reference Stuff/circular screen outline.SLDPRT
Mechanical/Machine Design/V4/Components/saber/gooseneck_xlr connector end/steps for printing/side1_V2.STEP
Mechanical/Machine Design/V4/Components/saber/3D Print step/effector connector_side2_V2.STEP
Mechanical/Machine Design/V4/Components/Stepper mount_V2.SLDPRT
Mechanical/Machine Design/V4/Components/corner joint_V5_SwitchMount_V1.SLDPRT
Electrical/01a_V4 - Saber - Spot Light/slip ring gooseneck assembly/step files/slip ring gooseneck assembly_3D Print_V1.STEP
Electrical/03_PCB Reference Stuff/Main Screen Outline.DXF
Electrical/03_PCB Reference Stuff/circular screen outline.DXF
Electrical/03_PCB Reference Stuff/step files/1985195.stp
Electrical/3D Models/1985195.stp
Electrical/3D Models/circular display/circular display footprint layout.DXF
Mechanical/Machine Design/V1/Assembly/Animation Stage_Assembly_V1.SLDASM
Mechanical/Machine Design/V1/Assembly/LED Strip Assembly_V1.SLDASM
Mechanical/Machine Design/V1/Assembly/motor and platter plate_V1.SLDASM
Mechanical/Machine Design/V1/Components/10x15x4 bearing_V1.SLDPRT
Mechanical/Machine Design/V1/Components/20T 2GT 5mm Pully_V1.SLDPRT
Mechanical/Machine Design/V1/Components/2GT 200mm Belt_V1.SLDPRT
Mechanical/Machine Design/V1/Components/3 digit 7 segment display mount_V1.SLDPRT
Mechanical/Machine Design/V1/Components/60T 2GT 5mm Pully_V1.SLDPRT
Mechanical/Machine Design/V1/Components/9mm shaft bearing.SLDPRT
Mechanical/Machine Design/V1/Components/Animation Platter Coupler_V1.SLDPRT
Mechanical/Machine Design/V1/Components/Animation Platter_V1.SLDPRT
Mechanical/Machine Design/V1/Components/Control Panel Mount_V1.SLDPRT
Mechanical/Machine Design/V1/Components/LED Light Strip_V1.SLDPRT
Mechanical/Machine Design/V1/Components/LED Strip Holder_V1.SLDPRT
Mechanical/Machine Design/V1/Components/Shaft bearing adapter_V1.SLDPRT
Mechanical/Machine Design/V1/Components/Stepper and bearing mount_V1.SLDPRT
Mechanical/Machine Design/V1/Components/corner joint_V1.SLDPRT
Mechanical/Machine Design/V1/Components/main platform_V1.SLDPRT
Mechanical/Machine Design/V1/Components/scrappy control panel_V1.SLDPRT
Mechanical/Machine Design/V2/Components/Animation Platter Coupler_V2.SLDPRT
Mechanical/Machine Design/V2/Components/Animation Platter Coupler_V3.SLDPRT
Mechanical/Machine Design/V2/Components/Control Panel Mount_V2.SLDPRT
Mechanical/Machine Design/V2/Components/LED Strip Holder_V2.SLDPRT
Mechanical/Machine Design/V2/Components/Stepper mount_V2.SLDPRT
Mechanical/Machine Design/V2/Components/corner joint_V2.SLDPRT
Mechanical/Machine Design/V2/Components/main platform_V2.SLDPRT
Mechanical/Machine Design/V3/Components/Animation Platter Coupler_V2.SLDPRT
Mechanical/Machine Design/V3/Components/Animation Platter Coupler_V3.SLDPRT
Mechanical/Machine Design/V3/Components/Animation Platter Coupler_V4.SLDPRT
Mechanical/Machine Design/V3/Components/Control Panel Mount_V2.SLDPRT
Mechanical/Machine Design/V3/Components/Control Panel Mount_V3.SLDPRT
Mechanical/Machine Design/V3/Components/LED Strip Holder_V2.SLDPRT
Mechanical/Machine Design/V3/Components/Stepper mount_V2.SLDPRT
Mechanical/Machine Design/V3/Components/corner joint_V2.SLDPRT
Mechanical/Machine Design/V3/Components/main platform_V2.SLDPRT
Mechanical/Machine Design/V4/Accessory Parts/slip ring gooseneck assembly/step files/slip ring gooseneck assembly_3D Print_V1.STEP
Mechanical/Machine Design/V4/Components/Animation Platter Coupler_V2.SLDPRT
Mechanical/Machine Design/V4/Components/Animation Platter Coupler_V3.SLDPRT
Mechanical/Machine Design/V4/Components/Animation Platter Coupler_V4.SLDPRT
Mechanical/Machine Design/V4/Components/Animation Platter Coupler_V5.SLDPRT
Mechanical/Machine Design/V4/Components/Animation Platter Coupler_V6.SLDPRT
Mechanical/Machine Design/V4/Components/Animation Platter Coupler_V7.SLDPRT
Mechanical/Machine Design/V4/Components/Control Panel Mount_V2.SLDPRT
Mechanical/Machine Design/V4/Components/Control Panel Mount_V3.SLDPRT
Mechanical/Machine Design/V4/Components/LED Strip Holder_V2.SLDPRT
Mechanical/Machine Design/V4/Components/corner joint_V2.SLDPRT
Mechanical/Machine Design/V4/Components/corner joint_V4_standard.SLDPRT
Mechanical/Machine Design/V4/Components/main platform_V2.SLDPRT
Mechanical/Machine Design/V4/Components/saber/3D Print step/PCB Mount_V1.STEP
Mechanical/Machine Design/V4/Components/saber/3D Print step/PCB Mount_V2.STEP
Mechanical/Machine Design/V4/Components/saber/3D Print step/effector connector_side1_V1.STEP
Mechanical/Machine Design/V4/Components/saber/3D Print step/effector connector_side2_V1.STEP
Mechanical/Machine Design/V4/Components/saber/3D Print step/light shade cover_v1.STEP
Mechanical/Machine Design/V4/Components/saber/3D Print step/light shade cover_v2.STEP
Mechanical/Machine Design/V4/Components/saber/PCB mount_V1.SLDPRT
Mechanical/Machine Design/V4/Components/saber/PCB mount_V2.SLDPRT
Mechanical/Machine Design/V4/Components/saber/PCB mount_V3.SLDPRT
Mechanical/Machine Design/V4/Components/saber/gooseneck_effector end/effector connector_v1.SLDPRT
Mechanical/Machine Design/V4/Components/saber/gooseneck_xlr connector end/steps for printing/sleeve_v1.STEP
Mechanical/Platters/Clock Platter 3/Clock Platter 3.SLDASM
Mechanical/Platters/Clock Platter 3/Clock Platter 3.SLDPRT
Mechanical/Platters/Color Morph Test/Color Morph Test_V1.SLDPRT
Mechanical/Platters/Cube/V1/Cube_V1.0.SLDPRT
Mechanical/Platters/Cube/V2/Cube Pattern_V2.SLDPRT
Mechanical/Platters/Cube/V3/Cube Pattern_V3.SLDPRT
Mechanical/Platters/Cube/V4/Cube Pattern_V4.SLDPRT
Mechanical/Platters/Pixel Platter/Pixel Platter 3D Print_V1/Pixel Platter 3D Print.SLDPRT
Mechanical/Platters/Pixel Platter/Pixel Platter 3D Print_V1/Pixel Platter 3D Print_V1.STEP
Mechanical/Platters/Pixel Platter/Pixel Platter 3D Print_V2/Pixel Platter 3D Print_V2.SLDPRT
Mechanical/Platters/Pixel Platter/Pixel Platter 3D Print_V2/Pixel Platter 3D Print_V2.STEP
