TickingClocks/Zoetrope-Carousel-V4/Electrical/01a_V4 - Saber - Spot Light/V1/01_Electrical Plots/Schematic/Saber_V1.pdf

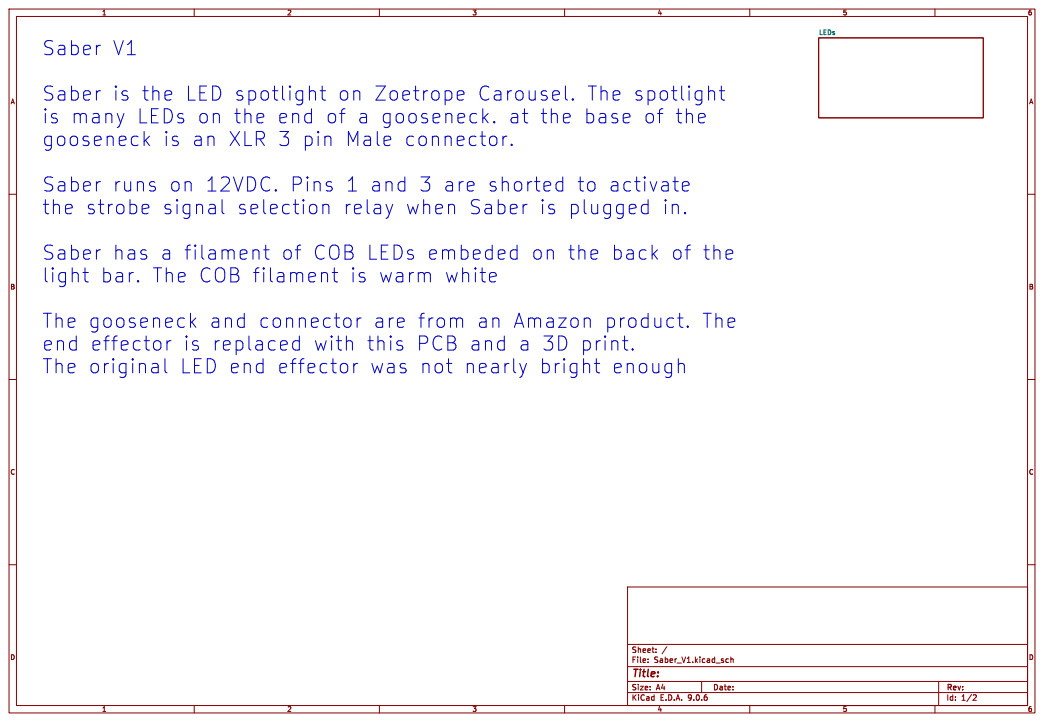
[picture p98: page 1]

Id: 1/2 Title: File: Saber_V1.kicad_sch Sheet: /

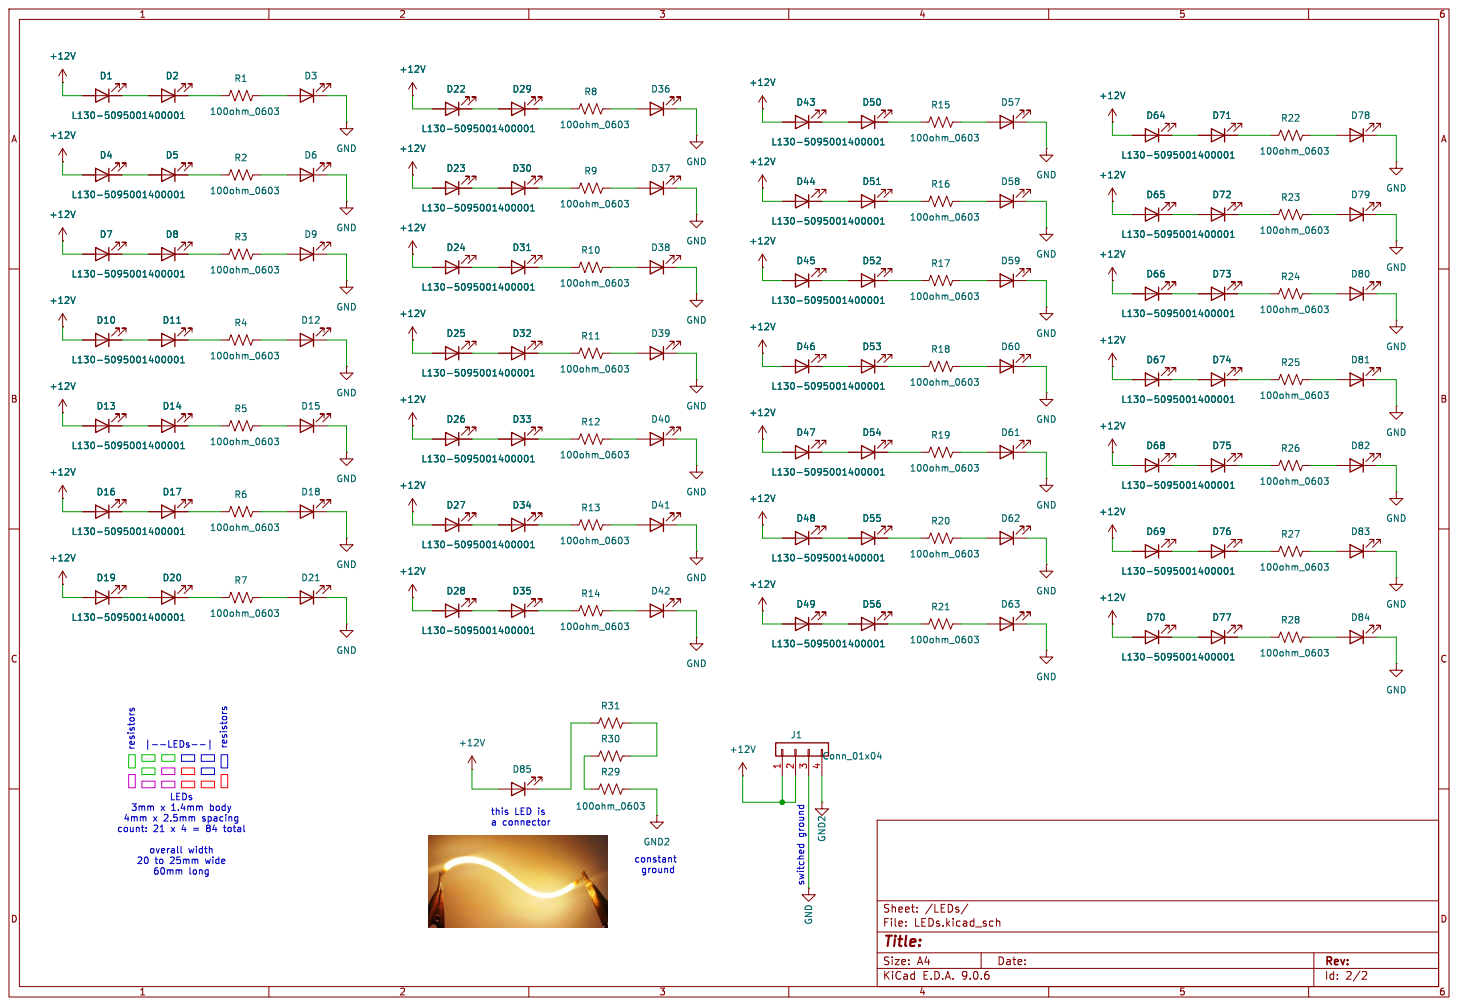
[picture p99: page 2]

Id: 2/2 Title: File: LEDs.kicad_sch Sheet: /LEDs/ R29

count: 21 x 4 = 84 total overall width
