TickingClocks/Zoetrope-Carousel-V4/Electrical/01c_V4 - Powered Platters/02_Basic 2D Platter_V2/01_PCB Plots/MCU Board_V1/Schematic/PoweredPlatter2_MainBoard_V1.pdf

1 | 2 | 3 | 4 | 5 | 6

AB

C

D

AB

C

D Date:

Size: A4 | Rev:
KiCad E.D.A. 10.0.1 | Id: 1/5

Title:

File: PoweredPlatter2_MainBoard_V1.kicad_sch

Sheet: /

## Power MCU

level shifting Connectors Second version of the Powered Platter design

V1 was functional and came to gether well. It had a few key flaws that had to be addressed
-The microcontroller used did not have adequate memory to control the neopixels as I wanted
I quickly ran into memory issues and limitations that are not worth the tiny form factor

-The small traces did resolve when milling with the CNC, however, traces that were thin and long were very easily damaged when soldering. This caused extra bodge wires and was an unpleasant assembly experience. Increase size of traces whenever possible

-This version is not going to include Neopizels, even though the upgraded microcontroller included in this version has the memory to support them. I'm replacing the Neoplades with LED blades that use 3mm through-hole LEDs. This increases the connections and limits the color output of the generated display. The benefit is simplified timing.
-Consider breaking out a connection for the LEDs if possible

V2 includes an upgraded microcontroller - STM32C071KBT6 - with much more memory and I/O.

Hardware notes
-V1 was too thick for the standard thumb screw
-cuttout for wires below was not deep enough

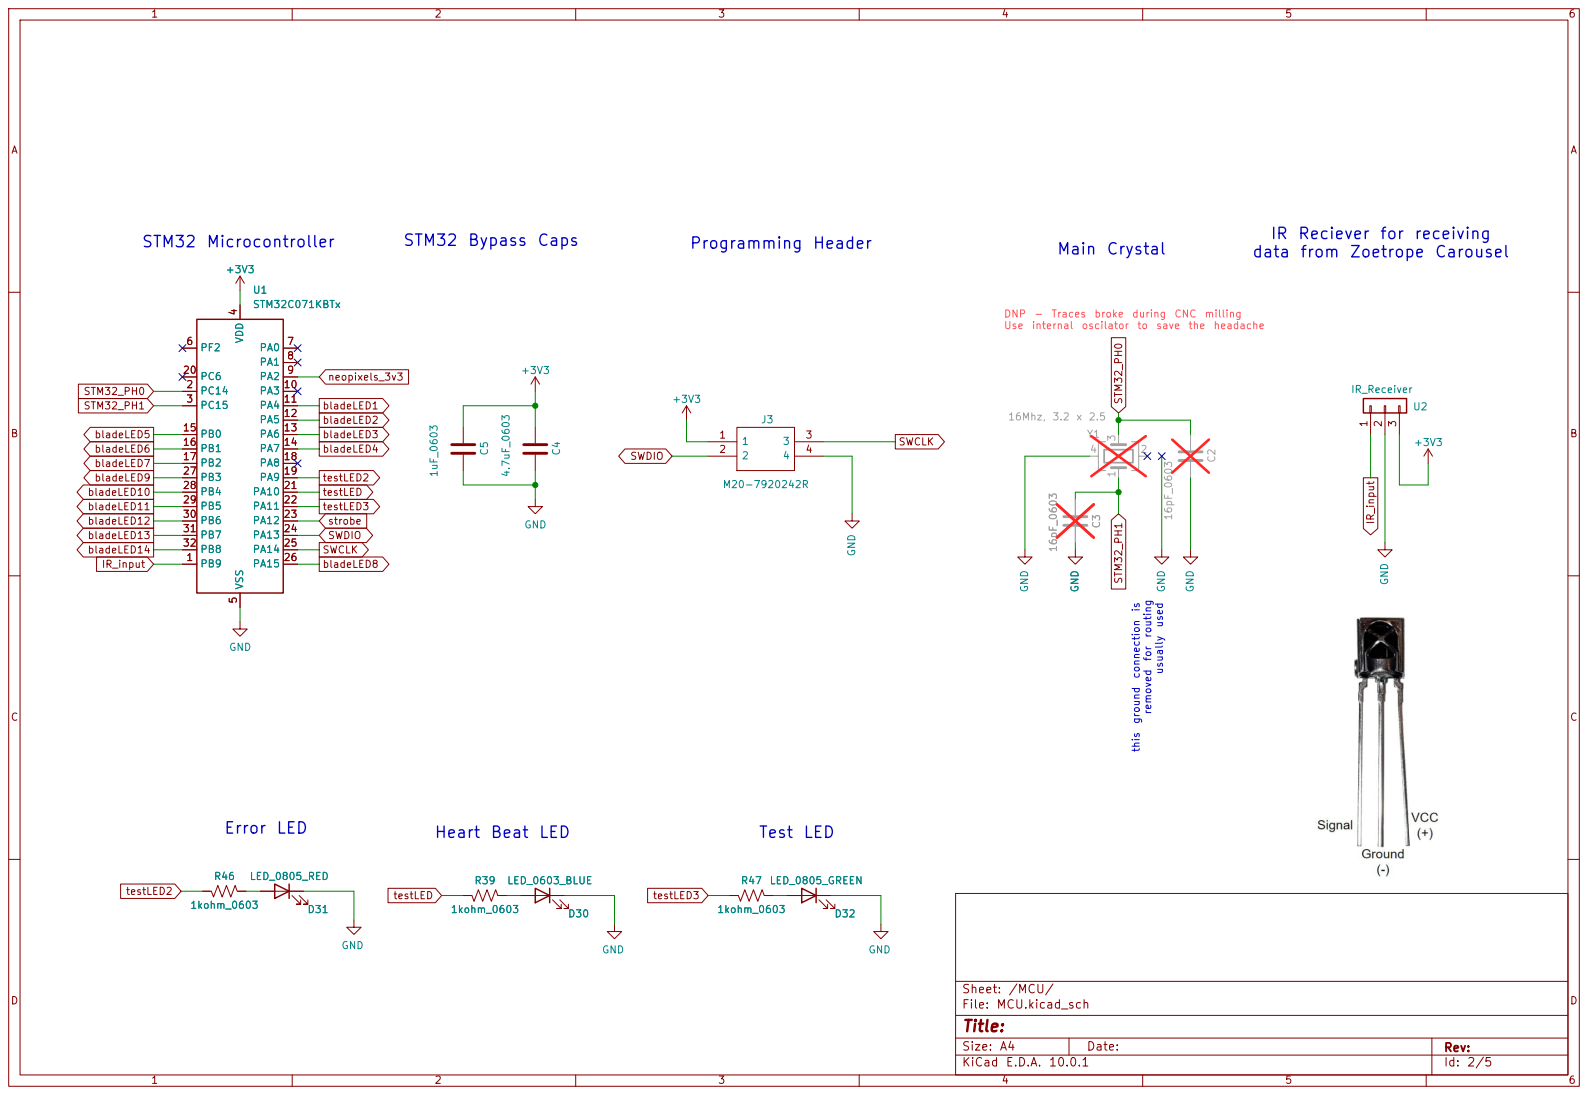
[picture p100: page 2]

IR Reciever for receiving

Main Crystal STM32 Bypass Caps

DNP - Traces broke during CNC milling Use internal oscilator to save the headache

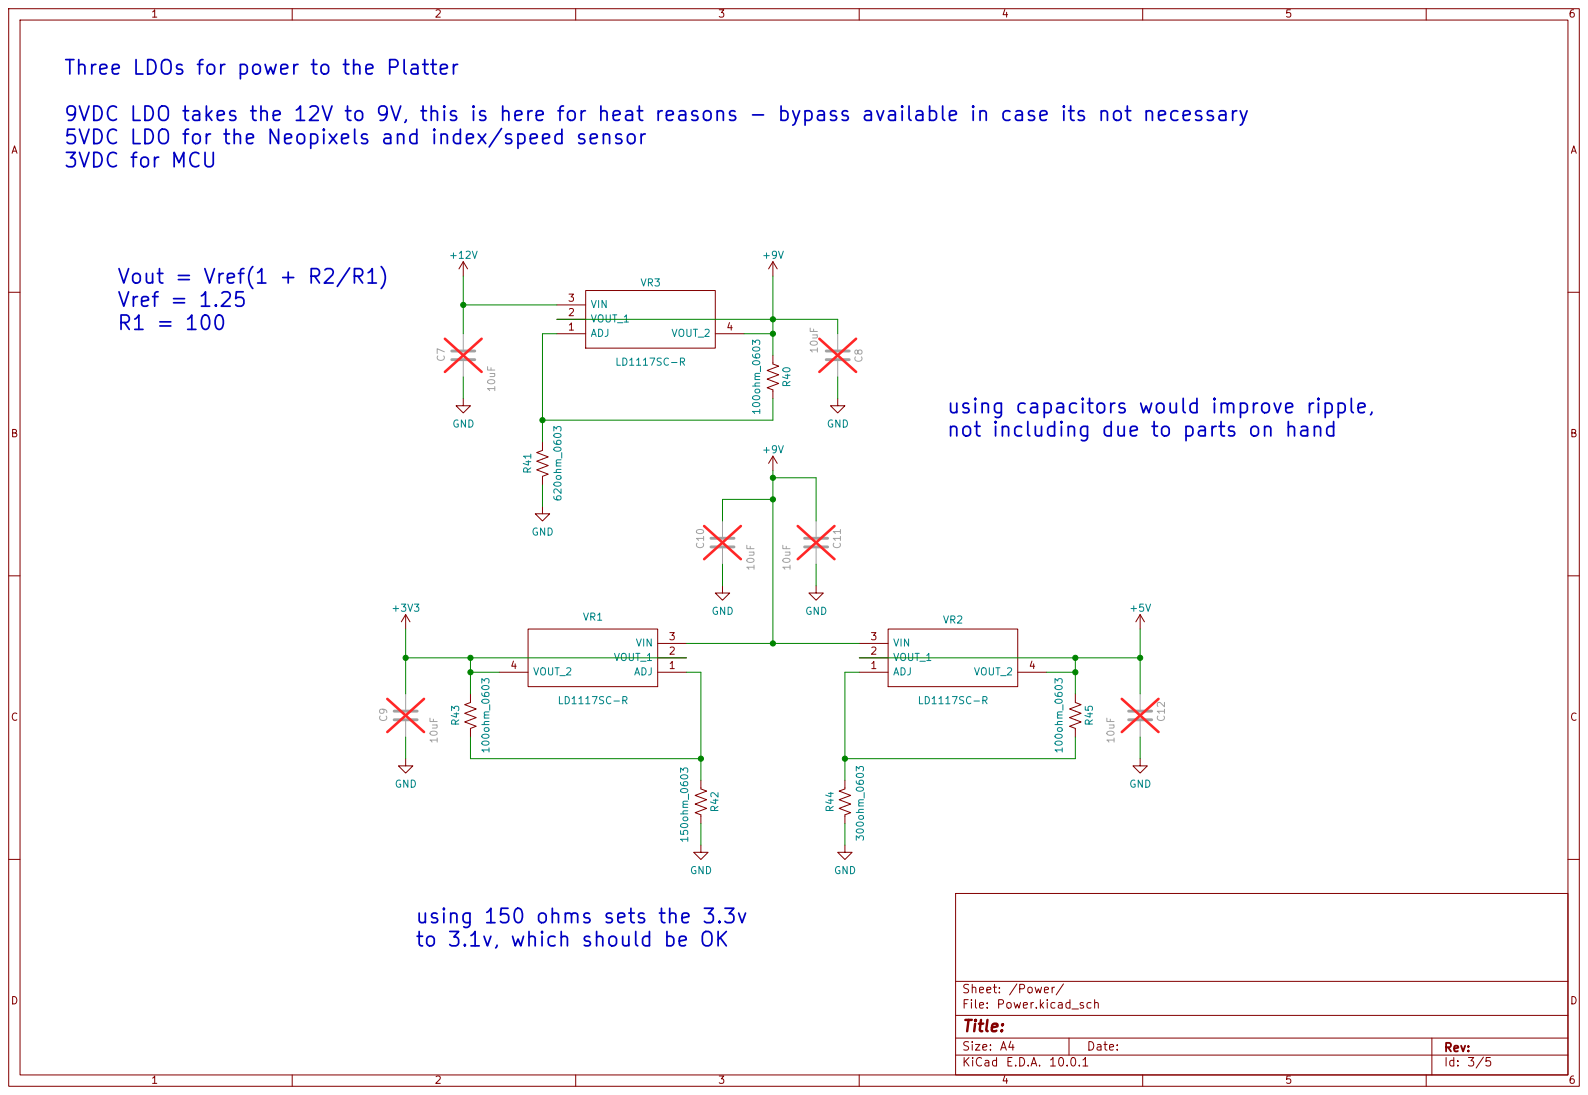
[picture p101: page 3]

Three LDOs for power to the Platter

9VDC LDO takes the 12V to 9V, this is here for heat reasons - bypass available in case its not necessary
5VDC LDO for the Neopixels and index/speed sensor
3VDC for MCU

using capacitors would improve ripple,
not including due to parts on hand

using 150 ohms sets the 3.3v
to 3.1v, which should be OK

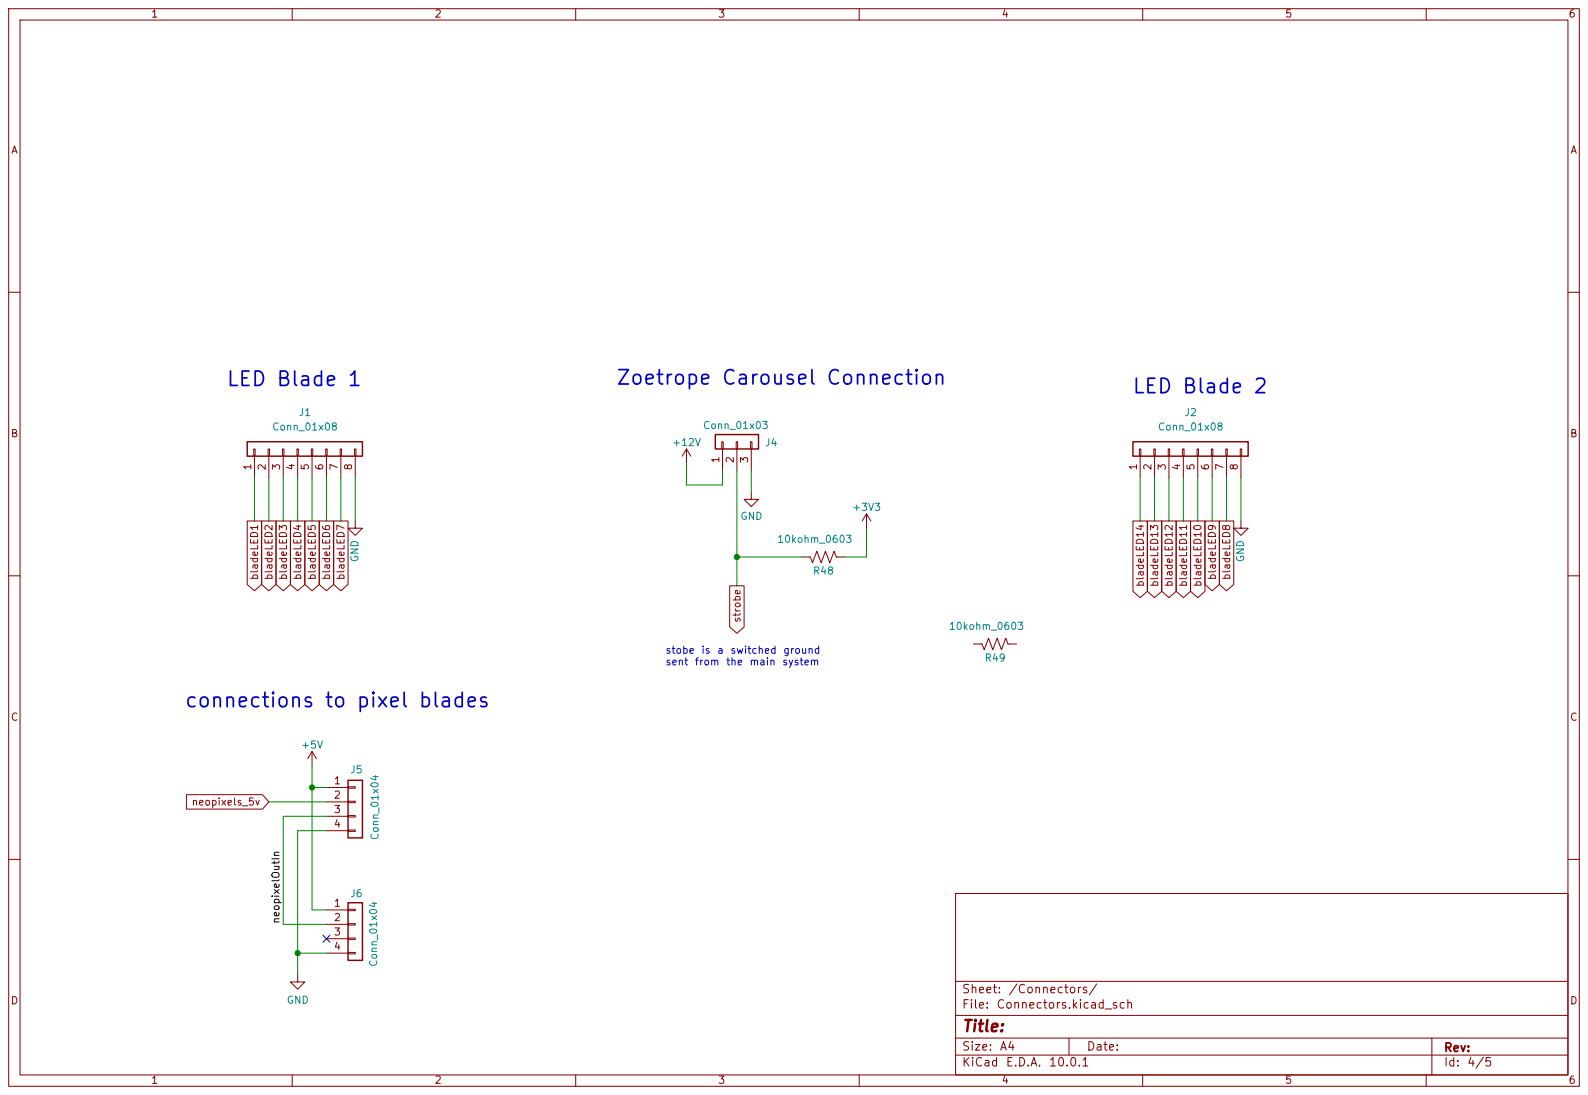
[picture p102: page 4]

stobe is a switched ground
sent from the main system

connections to pixel blades

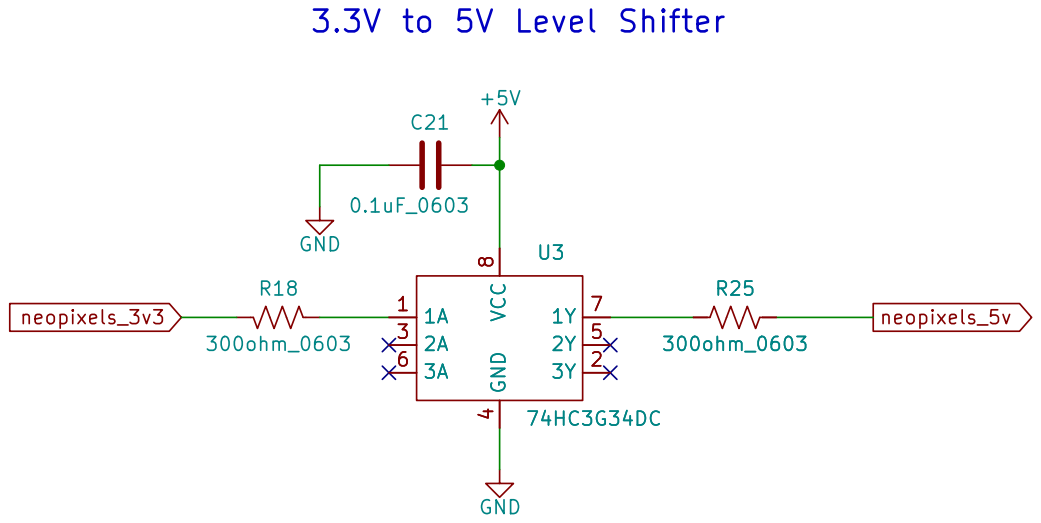
[picture p103: page 5]
