TickingClocks/Zoetrope-Carousel-V4/Electrical/01c_V4 - Powered Platters/02_Basic 2D Platter_V2/01_PCB Plots/LED Blade_V1/schematic/PoweredPlatter2_LED Blade_V1.pdf

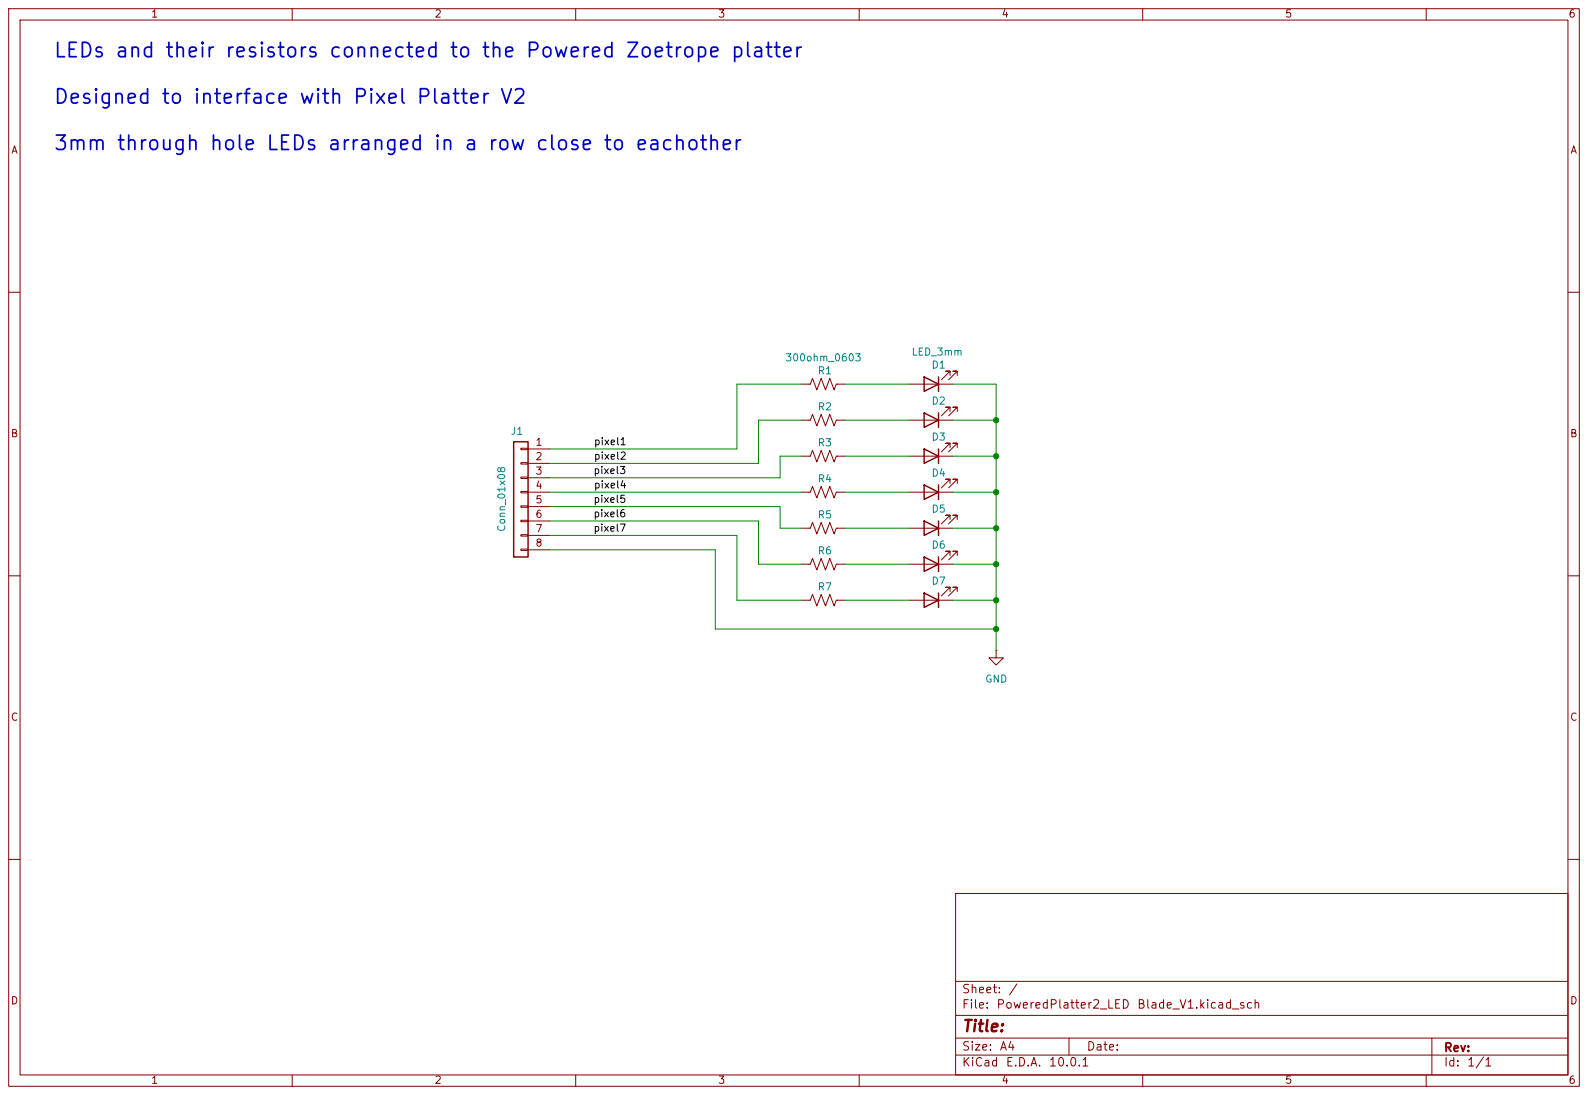
[picture p104: page 1]

LEDs and their resistors connected to the Powered Zoetrope platter

Designed to interface with Pixel Platter V2

3mm through hole LEDs arranged in a row close to eachother

Size: A4 | Rev:
KiCad E.D.A. 10.0.1 | Id: 1/1
