TickingClocks/Zoetrope-Carousel-V4/Electrical/01c_V4 - Powered Platters/01_Basic 2D Neopixel Platter/02_PCB Plots/Basic Pixels_MCU PCB_V1.0/Schematic/Basic Pixels_MCU PCB_V1.0.pdf

1 | 2 | 3 | 4 | 5 | 6

AB

C

D

AB

C

D Date:

Size: A4 | Rev:
KiCad E.D.A. 10.0.0 | Id: 1/5

Title:

File: Basic Pixels_MCU PCB_V1.0.kicad_sch

Sheet: /

MCU

Connectors

Level Shifting Power MCU Board for the Basic Pixels Powered Zoetrope Platter

This board has a STM32 microcontroller at its heart

Power is passed to the platter via 2.54 male headers. a female connector on the goosenek slipring connects into the header.

A sensor is used to detect the rotation speed and index point of the rotating platter.
The sensor is a on the other PCB and single connection is passed to this board

There are two, five pin connections on two ends of this PCB. These are connections to the two neopixel strip boards that act as the display. On one of these boards an optical sensor
is mounted for rotation speed sensing and indexing of the platter

There is a single SMT LED on this PCB to act as a heartbeat/debug LED. It may be incorperated into animations if desired

This board, to start, is square. Each edge is tangent to the platter coupler

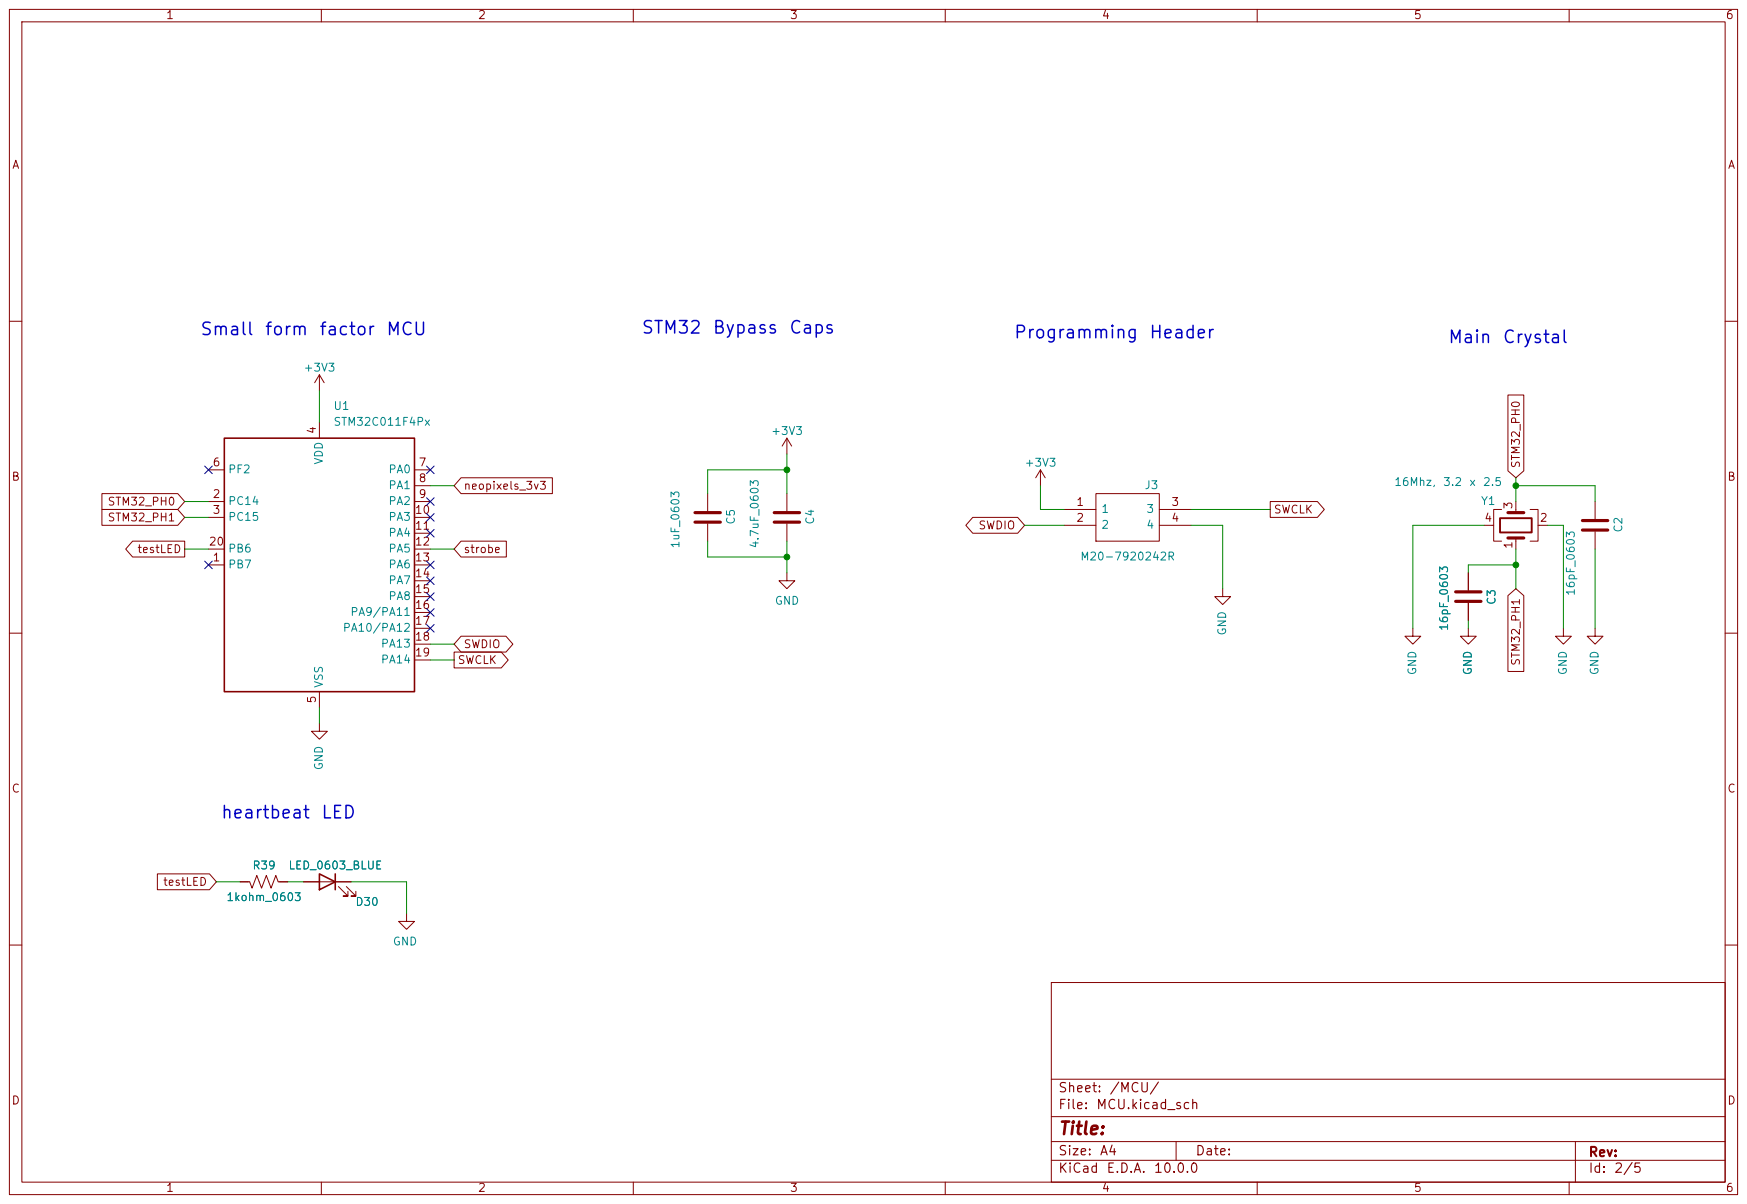
[picture p105: page 2]

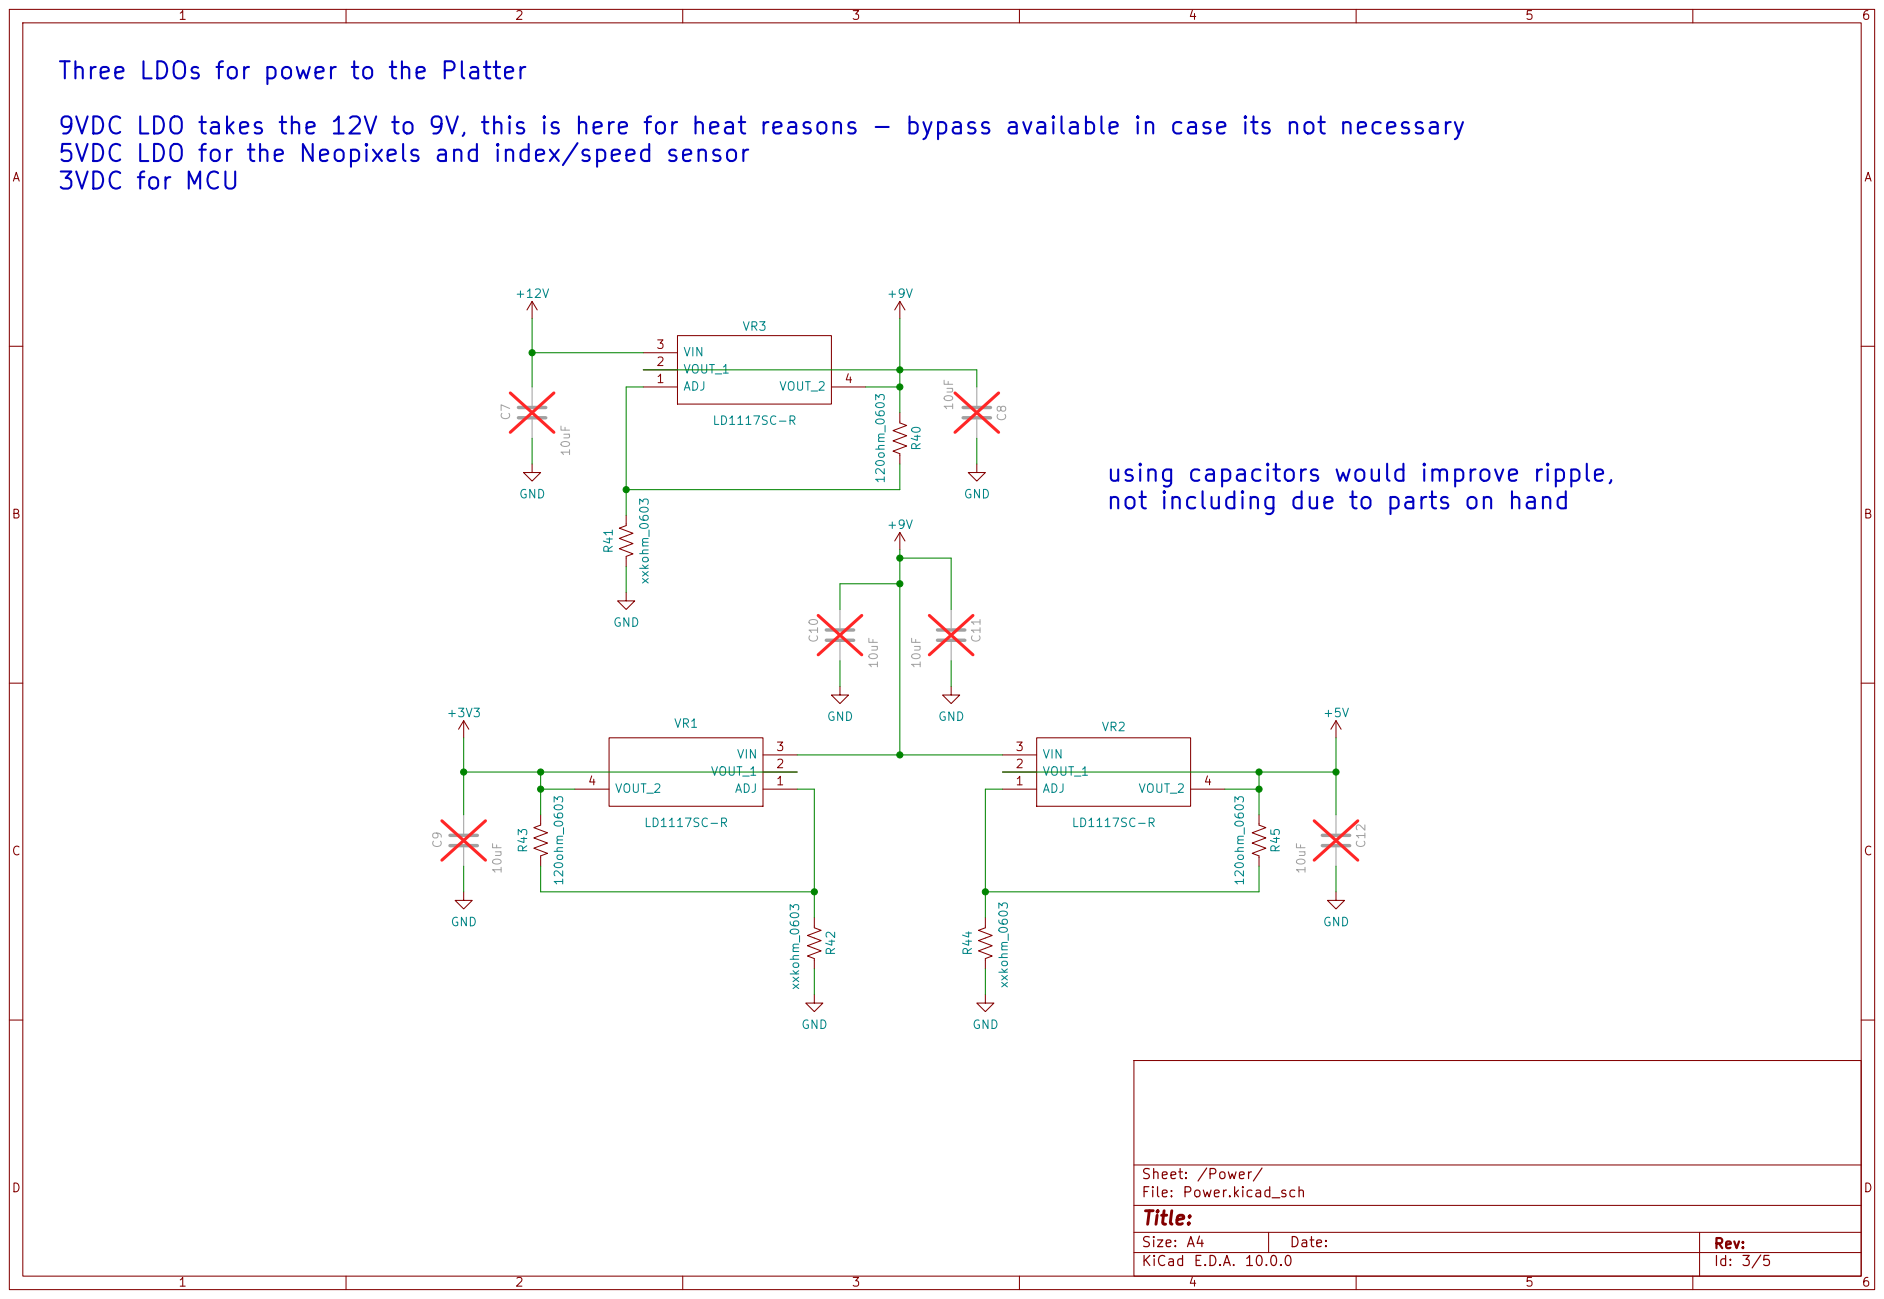
[picture p106: page 3]

Three LDOs for power to the Platter

9VDC LDO takes the 12V to 9V, this is here for heat reasons - bypass available in case its not necessary
5VDC LDO for the Neopixels and index/speed sensor
3VDC for MCU

not including due to parts on hand

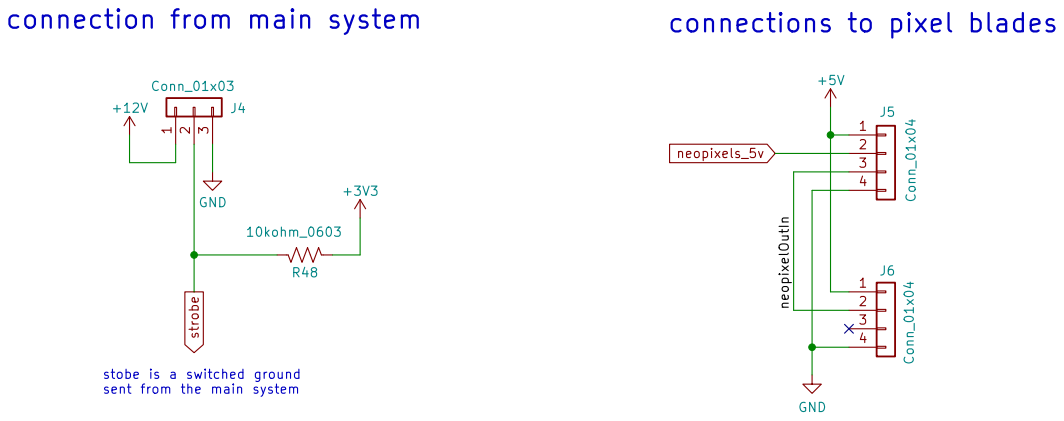
[picture p107: page 4]

connection from main system

connections to pixel blades

stobe is a switched ground
sent from the main system

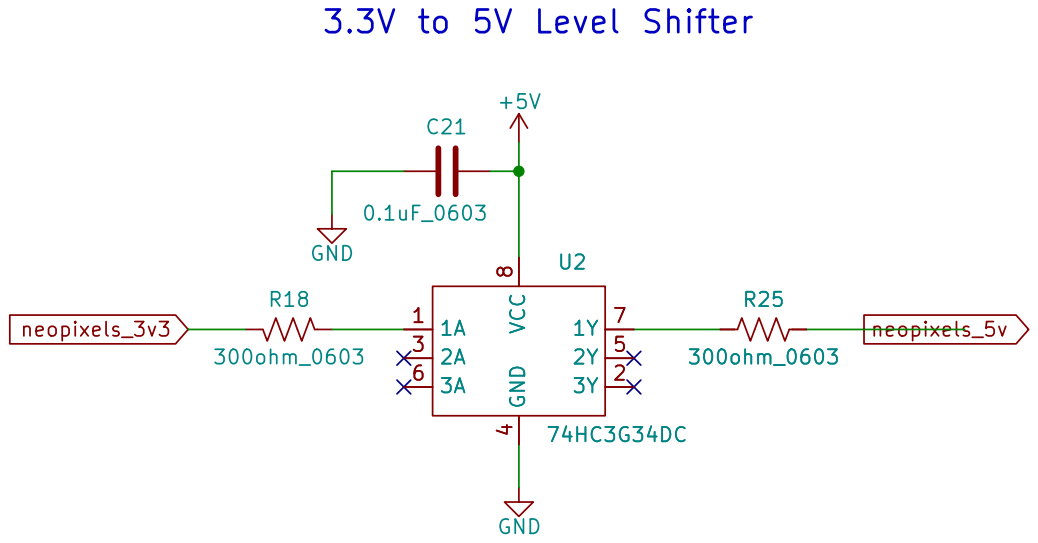
[picture p108: page 5]
