TickingClocks/Zoetrope-Carousel-V4/Electrical/01c_V4 - Powered Platters/01_Basic 2D Neopixel Platter/02_PCB Plots/Basic Pixels_NeoBlade_V1.0/Schematic/Basic Pixels_NeoBlade_V1.0.pdf

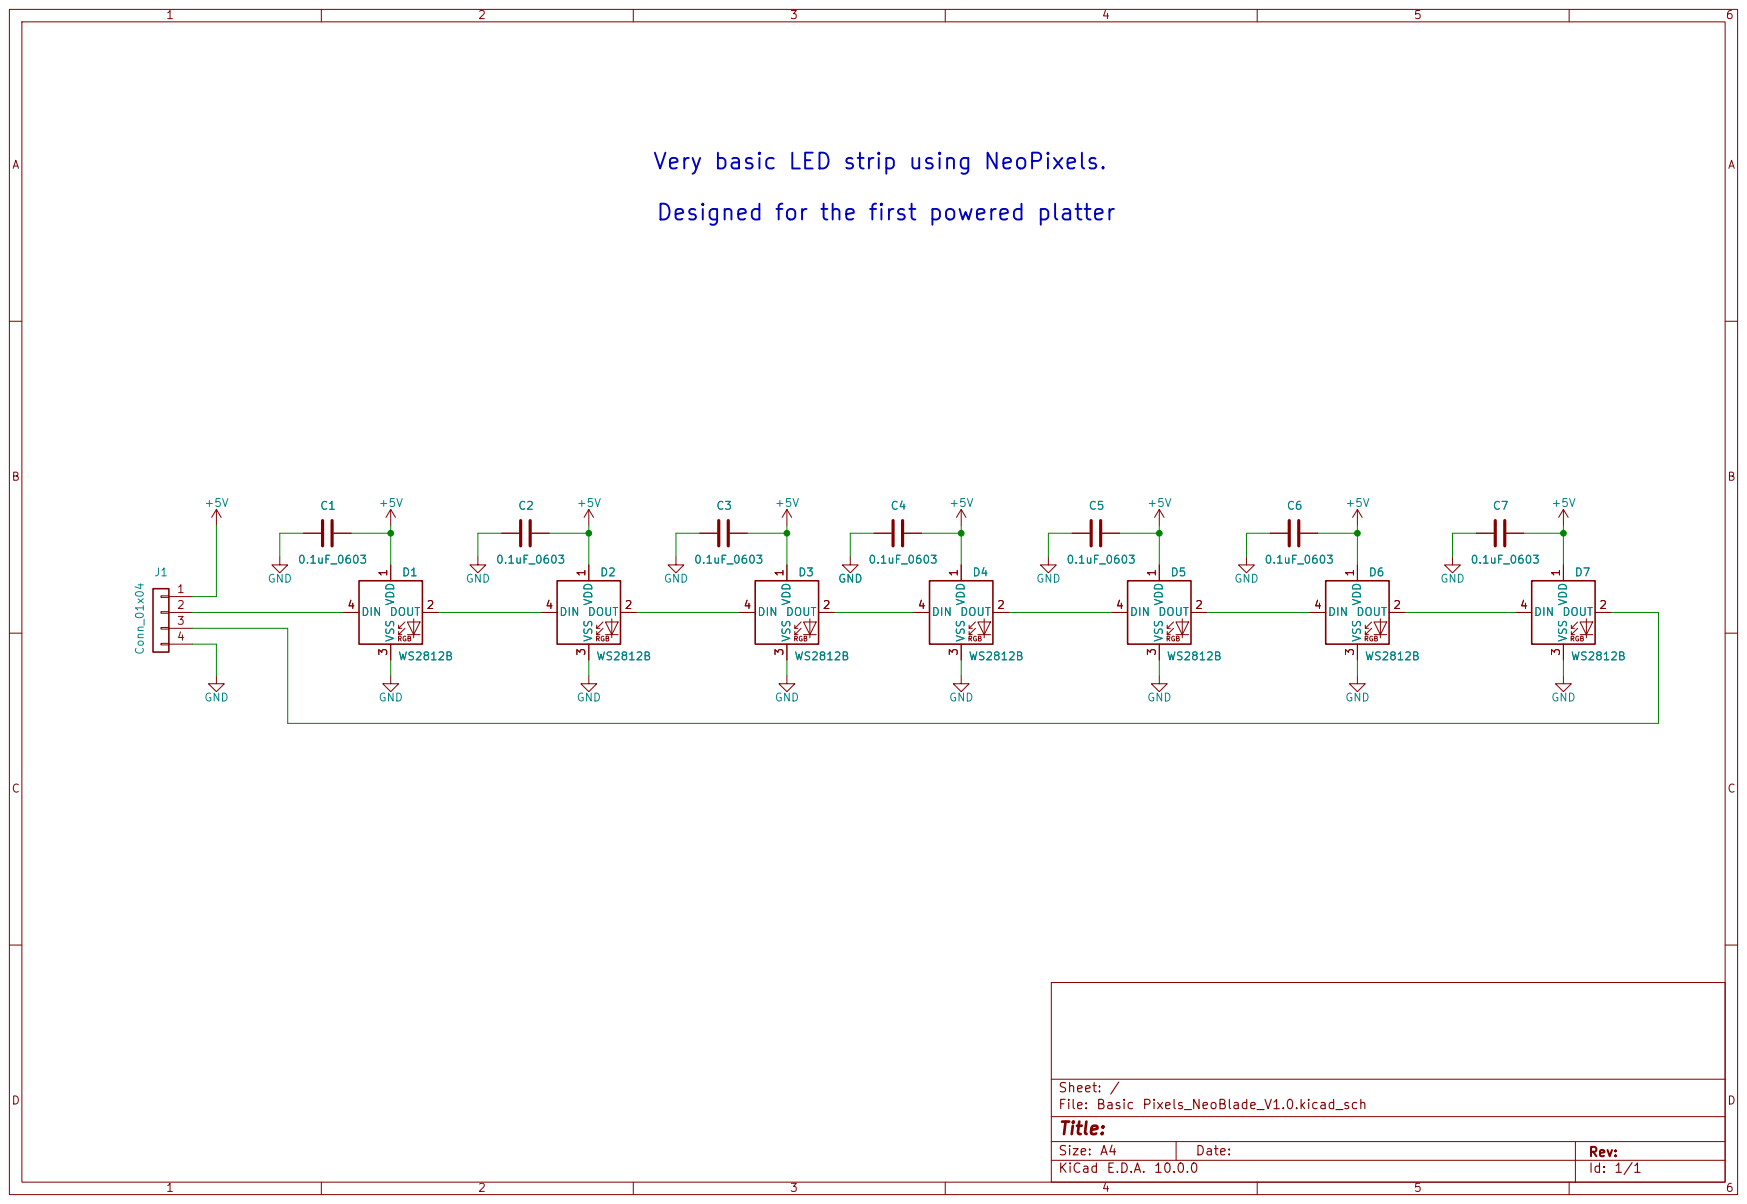
[picture p109: page 1]

0.1uF_0603 +5V Very basic LED strip using NeoPixels.

Designed for the first powered platter

Size: A4 | Rev:
KiCad E.D.A. 10.0.0 | Id: 1/1
