TickingClocks/Zoetrope-Carousel-V4/Electrical/01a_V4 - External Power Switch PCB/V1/01_Electrical Plots/schematic/Zoetrope Carusel V4 - External Power Switch_V1.pdf

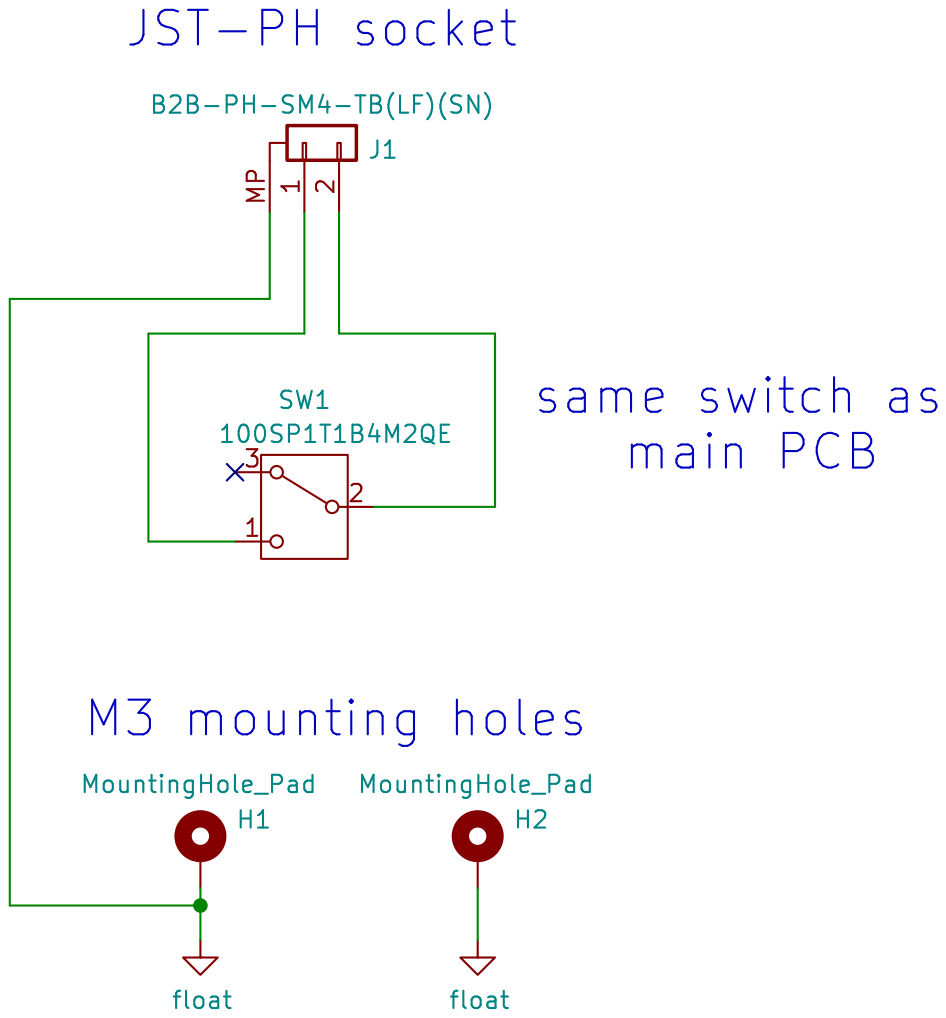
[picture p110: page 1]
