TickingClocks/Zoetrope-Carousel-V4/Electrical/01c_V4 - Powered Platters/02_Basic 2D Platter_V2/00_PCB Designs/PoweredPlatter2_MainBoard_V1/PoweredPlatter2_MainBoard_V1.kicad_pcb

## KiCad design Electrical/01c_V4 - Powered Platters/02_Basic 2D Platter_V2/00_PCB Designs/PoweredPlatter2_MainBoard_V1/PoweredPlatter2_MainBoard_V1.kicad_pcb (2026-05-04)

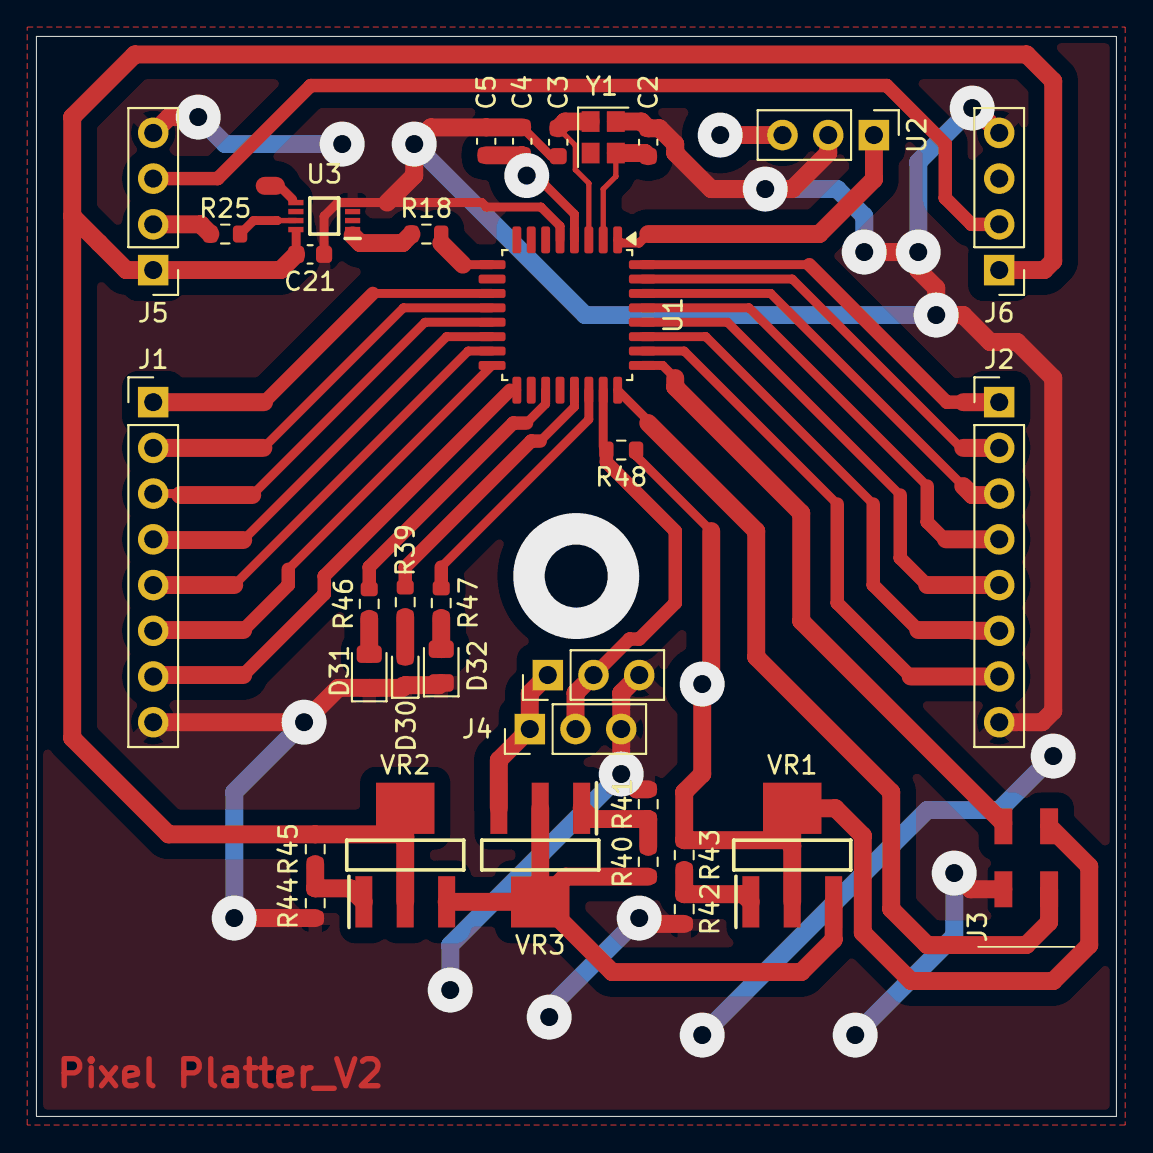
[picture p111: board PoweredPlatter2_MainBoard_V1.kicad_pcb from above]

Board: 4 copper layers, 60.0 x 60.0 mm, 34 parts (0 on the bottom side), 39 nets.

Parts:
C2, C3: 16pF_0603; C_0603_1608Metric
C4: 4.7uF_0603; C_0603_1608Metric
C5: 1uF_0603; C_0603_1608Metric
C21: 0.1uF_0603; C_0603_1608Metric
D30: LED_0603_BLUE; LED_0603_1608Metric
D31: LED_0805_RED; LED_0805_2012Metric
D32: LED_0805_GREEN; LED_0805_2012Metric
J1, J2: Conn_01x08; PinHeader_1x08_P2.54mm_Vertical
J3: M20-7920242R
J4, J5#2: Conn_01x03; PinHeader_1x03_P2.54mm_Vertical
J5, J6: Conn_01x04; PinHeader_1x04_P2.54mm_Vertical
R18, R25, R44: 300ohm_0603; R_0603_1608Metric
R39, R46, R47: 1kohm_0603; R_0603_1608Metric
R40, R43, R45: 100ohm_0603; R_0603_1608Metric
R41: 620ohm_0603; R_0603_1608Metric
R42: 150ohm_0603; R_0603_1608Metric
R48: 10kohm_0603; R_0603_1608Metric
U1: STM32C071KBTx; LQFP-32_7x7mm_P0.8mm
U2: IR_Receiver; PinHeader_1x03_P2.54mm_Vertical
U3: 74HC3G34DC
VR1, VR2, VR3: LD1117SC-R
Y1: 16Mhz, 3.2 x 2.5; crystal_gnd24

Connections:
+3V3: C4.1, C5.1, J3.1, R43.1, R48.2, U1.4 (VDD), U2.3, VR1.2 (VOUT_1), VR1.4 (VOUT_2)
+5V: C21.1, J5.1, J6.1, R45.1, U3.8 (VCC), VR2.2 (VOUT_1), VR2.4 (VOUT_2)
+9V: R40.1, VR1.3 (VIN), VR2.3 (VIN), VR3.2 (VOUT_1), VR3.4 (VOUT_2)
+12V: J4.1, J5#2.1, VR3.3 (VIN)
/Connectors/neopixelOutIn: J5.3, J6.2
GND: C2.2, C3.1, C4.2, C5.2, C21.2, D30.1 (K), D31.1 (K), D32.1 (K), J1.8, J2.8, J3.4, J4.3, J5.4, J5#2.3, J6.4, R41.2, R42.2, R44.2, U1.5 (VSS), U2.2, U3.4 (GND), Y1.4
IR_input: U1.1 (PB9), U2.1
unnamed: D30.2 (A), R39.1
unnamed: D31.2 (A), R46.1
unnamed: D32.2 (A), R47.1
unnamed: R18.1, U3.1 (1A)
unnamed: R25.2, U3.7 (1Y)
unnamed: R42.1, R43.2, VR1.1 (ADJ)
unnamed: R44.1, R45.2, VR2.1 (ADJ)
unnamed: R40.2, R41.1, VR3.1 (ADJ)
STM32_PH0: C2.1, U1.2 (PC14), Y1.3
STM32_PH1: C3.2, U1.3 (PC15), Y1.1
SWCLK: J3.3, U1.25 (PA14)
SWDIO: J3.2, U1.24 (PA13)
bladeLED1: J1.1, U1.11 (PA4)
bladeLED2: J1.2, U1.12 (PA5)
bladeLED3: J1.3, U1.13 (PA6)
bladeLED4: J1.4, U1.14 (PA7)
bladeLED5: J1.5, U1.15 (PB0)
bladeLED6: J1.6, U1.16 (PB1)
bladeLED7: J1.7, U1.17 (PB2)
bladeLED8: J2.7, U1.26 (PA15)
bladeLED9: J2.6, U1.27 (PB3)
bladeLED10: J2.5, U1.28 (PB4)
bladeLED11: J2.4, U1.29 (PB5)
bladeLED12: J2.3, U1.30 (PB6)
bladeLED13: J2.2, U1.31 (PB7)
bladeLED14: J2.1, U1.32 (PB8)
neopixels_3v3: R18.2, U1.9 (PA2)
neopixels_5v: J5.2, R25.1
strobe: J4.2, J5#2.2, R48.1, U1.23 (PA12)
testLED: R39.2, U1.21 (PA10)
testLED2: R46.2, U1.19 (PA9)
testLED3: R47.2, U1.22 (PA11)
