TickingClocks/Zoetrope-Carousel-V4/Electrical/01c_V4 - Powered Platters/02_Basic 2D Platter_V2/00_PCB Designs/PoweredPlatter2_LED Blade_V1/PoweredPlatter2_LED Blade_V1.kicad_pcb

## KiCad design Electrical/01c_V4 - Powered Platters/02_Basic 2D Platter_V2/00_PCB Designs/PoweredPlatter2_LED Blade_V1/PoweredPlatter2_LED Blade_V1.kicad_pcb (2026-05-04)

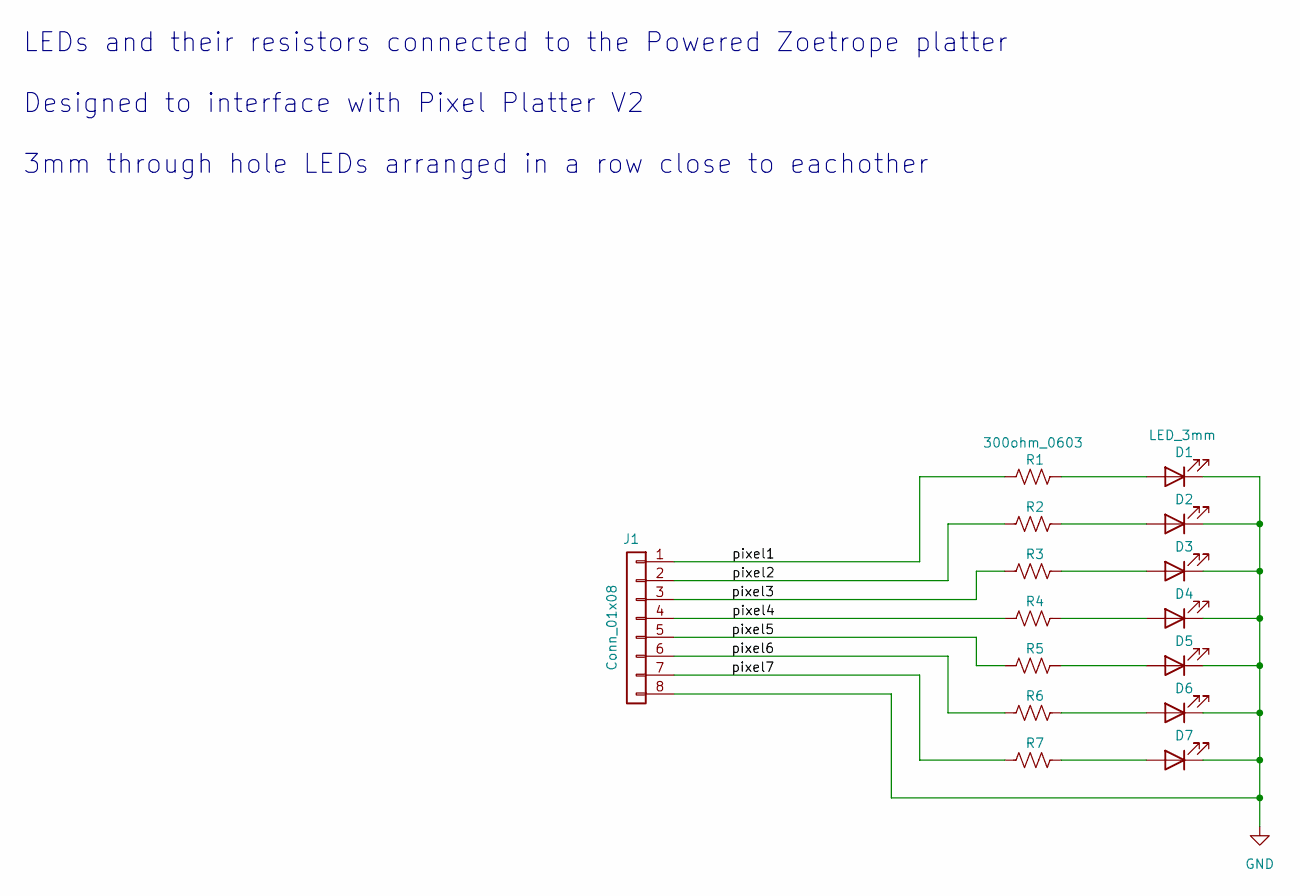
[picture p112: schematic PoweredPlatter2_LED Blade_V1.kicad_sch]

Parts:
D1, D2, D3, D4, D5, D6, D7: LED_3mm; LED_D3.0mm
J1: Conn_01x08; PinHeader_1x08_P2.54mm_Vertical
R1, R2, R3, R4, R5, R6, R7: 300ohm_0603; R_0603_1608Metric_Pad0.98x0.95mm_HandSolder

Connections:
/pixel1: J1.1, R1.1
/pixel2: J1.2, R2.1
/pixel3: J1.3, R3.1
/pixel4: J1.4, R4.1
/pixel5: J1.5, R5.1
/pixel6: J1.6, R6.1
/pixel7: J1.7, R7.1
GND: D1.1 (K), D2.1 (K), D3.1 (K), D4.1 (K), D5.1 (K), D6.1 (K), D7.1 (K), J1.8
unnamed: D1.2 (A), R1.2
unnamed: D2.2 (A), R2.2
unnamed: D3.2 (A), R3.2
unnamed: D4.2 (A), R4.2
unnamed: D5.2 (A), R5.2
unnamed: D6.2 (A), R6.2
unnamed: D7.2 (A), R7.2

Notes on the sheet:
LEDs and their resistors connected to the Powered Zoetrope platter Designed to interface with Pixel Platter V2 3mm through hole LEDs arranged in a row close to eachother

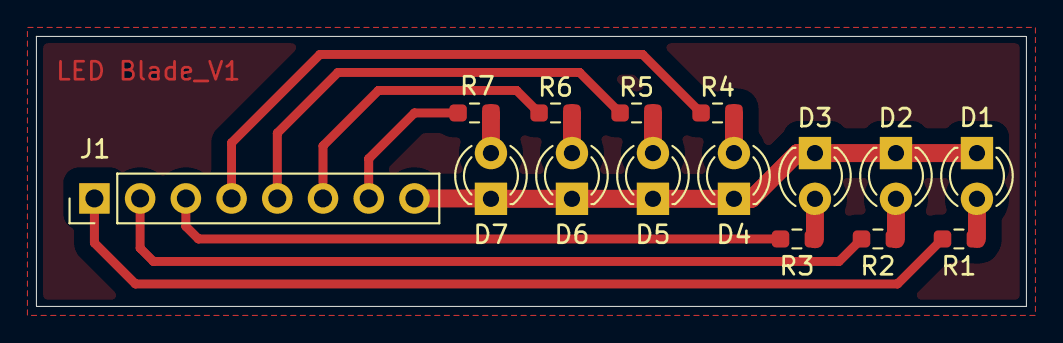
[picture p113: board PoweredPlatter2_LED Blade_V1.kicad_pcb from above]

Board: 2 copper layers, 55.0 x 15.0 mm, 15 parts (0 on the bottom side), 15 nets.
