TickingClocks/Zoetrope-Carousel-V4/Electrical/01c_V4 - Powered Platters/01_Basic 2D Neopixel Platter/01_PCB Designs/Basic Pixels_NeoBlade_V1.0/Basic Pixels_NeoBlade_V1.0.kicad_pcb

## KiCad design Electrical/01c_V4 - Powered Platters/01_Basic 2D Neopixel Platter/01_PCB Designs/Basic Pixels_NeoBlade_V1.0/Basic Pixels_NeoBlade_V1.0.kicad_pcb (2026-05-01)

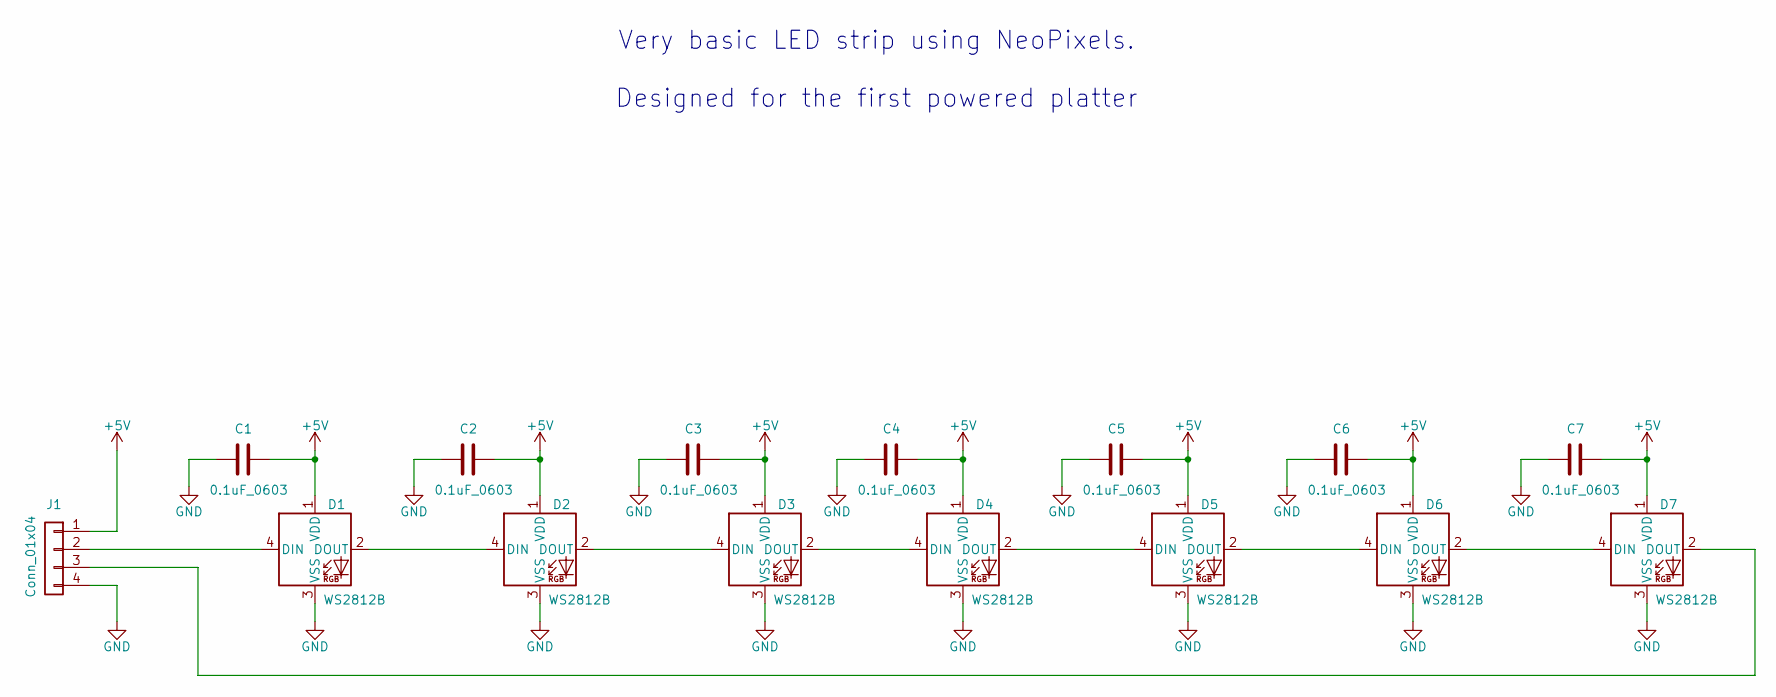
[picture p114: schematic Basic Pixels_NeoBlade_V1.0.kicad_sch]

Parts:
C1, C2, C3, C4, C5, C6, C7: 0.1uF_0603; C_0603_1608Metric
D1, D2, D3, D4, D5, D6, D7: WS2812B; LED_WS2812B_PLCC4_5.0x5.0mm_P3.2mm
J1: Conn_01x04; PinHeader_1x04_P2.54mm_Vertical

Connections:
+5V: C1.1, C2.1, C3.1, C4.1, C5.1, C6.1, C7.1, D1.1 (VDD), D2.1 (VDD), D3.1 (VDD), D4.1 (VDD), D5.1 (VDD), D6.1 (VDD), D7.1 (VDD), J1.1
GND: C1.2, C2.2, C3.2, C4.2, C5.2, C6.2, C7.2, D1.3 (VSS), D2.3 (VSS), D3.3 (VSS), D4.3 (VSS), D5.3 (VSS), D6.3 (VSS), D7.3 (VSS), J1.4
unnamed: D1.4 (DIN), J1.2
unnamed: D1.2 (DOUT), D2.4 (DIN)
unnamed: D2.2 (DOUT), D3.4 (DIN)
unnamed: D3.2 (DOUT), D4.4 (DIN)
unnamed: D4.2 (DOUT), D5.4 (DIN)
unnamed: D5.2 (DOUT), D6.4 (DIN)
unnamed: D6.2 (DOUT), D7.4 (DIN)
unnamed: D7.2 (DOUT), J1.3

Notes on the sheet:
Very basic LED strip using NeoPixels. Designed for the first powered platter

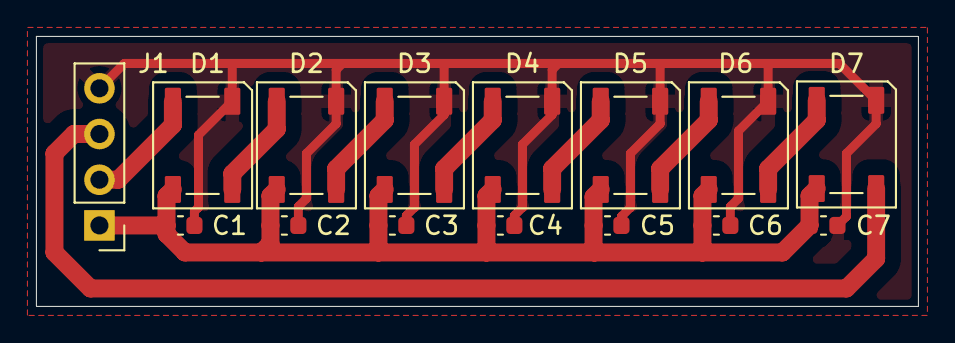
[picture p115: board Basic Pixels_NeoBlade_V1.0.kicad_pcb from above]

Board: 2 copper layers, 49.0 x 15.0 mm, 15 parts (0 on the bottom side), 10 nets.
