TickingClocks/Zoetrope-Carousel-V4/Electrical/01_V3 Electrical Design/Animation Platter_V3.kicad_pcb

## KiCad design Electrical/01_V3 Electrical Design/Animation Platter_V3.kicad_pcb (2026-05-01)

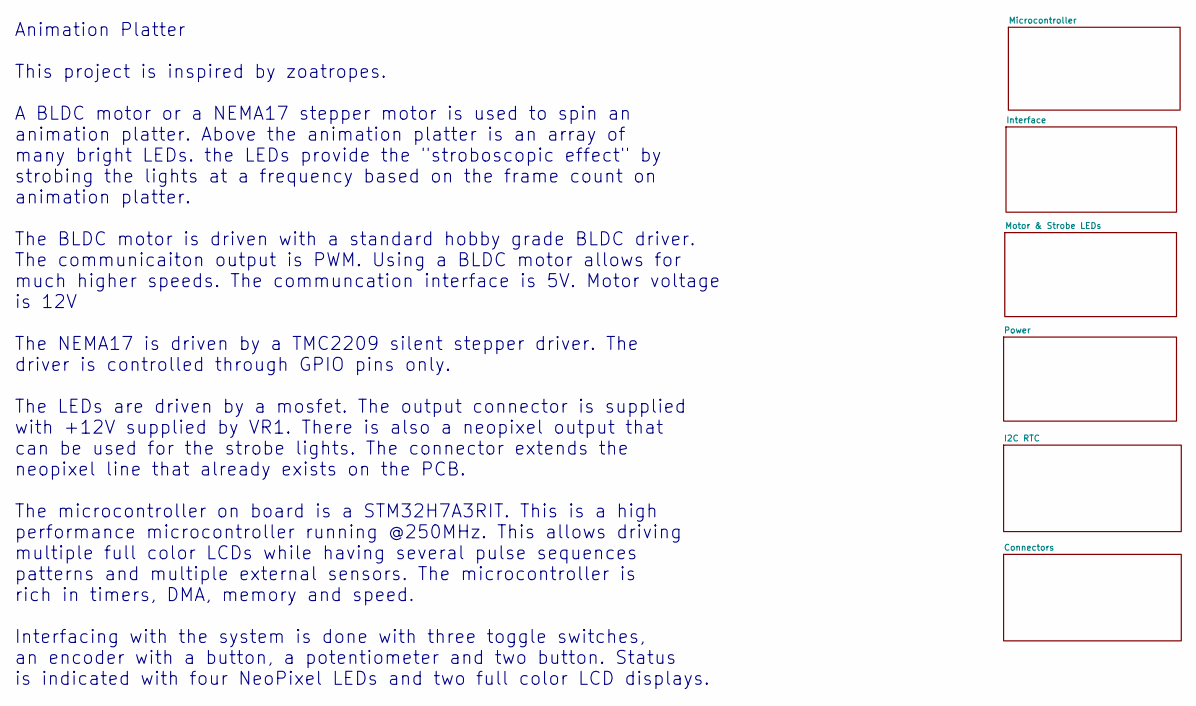
[picture p116: schematic Animation Platter_V3.kicad_sch]

Notes on the sheet:
Animation Platter This project is inspired by zoatropes. A BLDC motor or a NEMA17 stepper motor is used to spin an animation platter. Above the animation platter is an array of many bright LEDs. the LEDs provide the "stroboscopic effect" by strobing the lights at a frequency based on the frame coun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

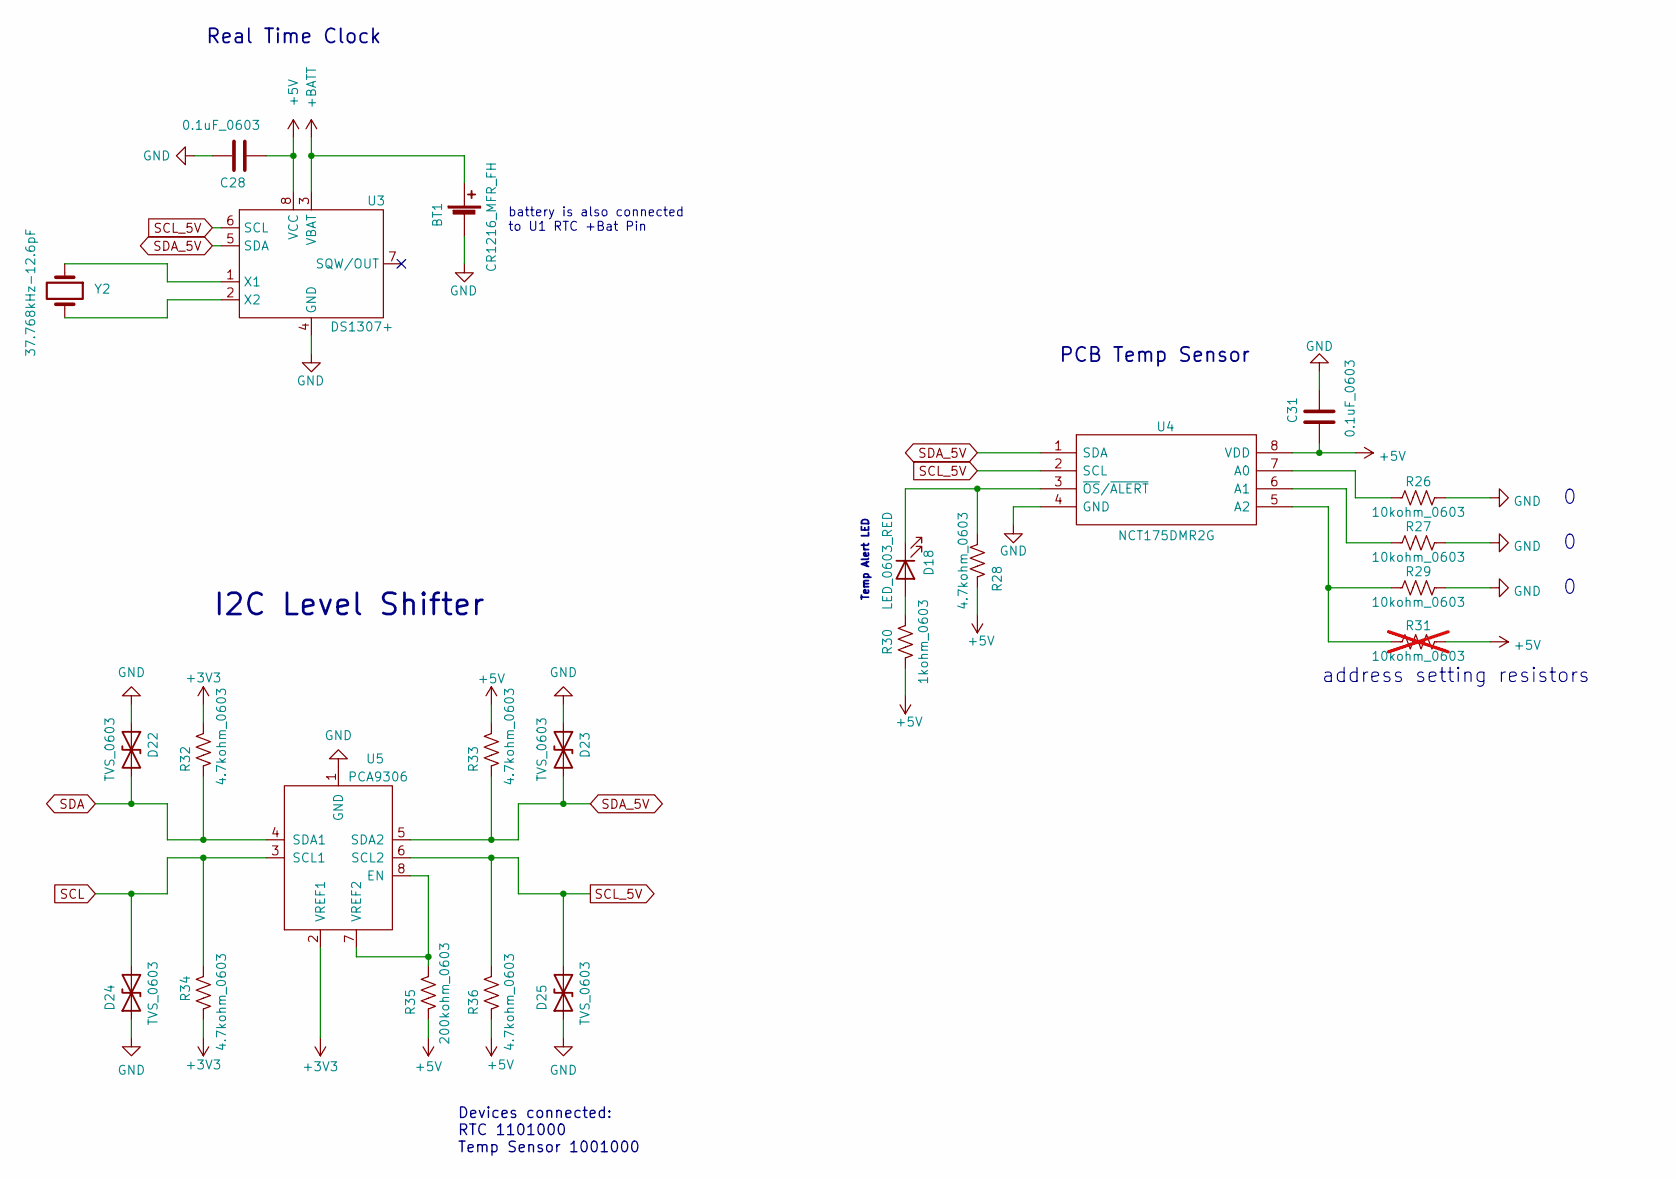
[picture p117: schematic I2C RTC.kicad_sch]

Parts:
BT1: CR1216_MFR_FH; CR2032_SMT
C28, C31: 0.1uF_0603; C_0603_1608Metric
D18: LED_0603_RED; LED_0603_1608Metric
D22, D23, D24, D25: TVS_0603; R_0603_1608Metric
R26, R27, R29: 10kohm_0603; R_0603_1608Metric
R28, R32, R33, R34, R36: 4.7kohm_0603; R_0603_1608Metric
R30: 1kohm_0603; R_0603_1608Metric
R31: 10kohm_0603; R_0603_1608Metric; not fitted
R35: 200kohm_0603; R_0603_1608Metric
U3: DS1307+; DS1307
U4: NCT175DMR2G; Mouser Part Number 863-NCT175DMR2G
U5: PCA9306
Y2: 37.768kHz-12.6pF; 37.768kHz

Connections:
+BATT: BT1.1, BT1.3, U3.3 (VBAT); also elsewhere on the board
unnamed: D18.2 (A), R30.1
unnamed: D18.1 (K), R28.2, U4.3 (~OS/~ALERT)
unnamed: U3.1 (X1), Y2.1
unnamed: U3.2 (X2), Y2.2
unnamed: R26.1, U4.7 (A0)
unnamed: R27.1, U4.6 (A1)
unnamed: R29.1, R31.1, U4.5 (A2)
unnamed: R35.2, U5.7 (VREF2), U5.8 (EN)
SCL: D24.2 (A2), R34.2, U5.3 (SCL1); also elsewhere on the board
SCL_5V: D25.2 (A2), R36.2, U3.6 (SCL), U4.2 (SCL), U5.6 (SCL2)
SDA: D22.2 (A2), R32.1, U5.4 (SDA1); also elsewhere on the board
SDA_5V: D23.2 (A2), R33.1, U3.5 (SDA), U4.1 (SDA), U5.5 (SDA2)

Notes on the sheet:
Real Time Clock
Devices connected: RTC 1101000 Temp Sensor 1001000
address setting resistors
I2C Level Shifter
battery is also connected to U1 RTC +Bat Pin
PCB Temp Sensor
Temp Alert LED

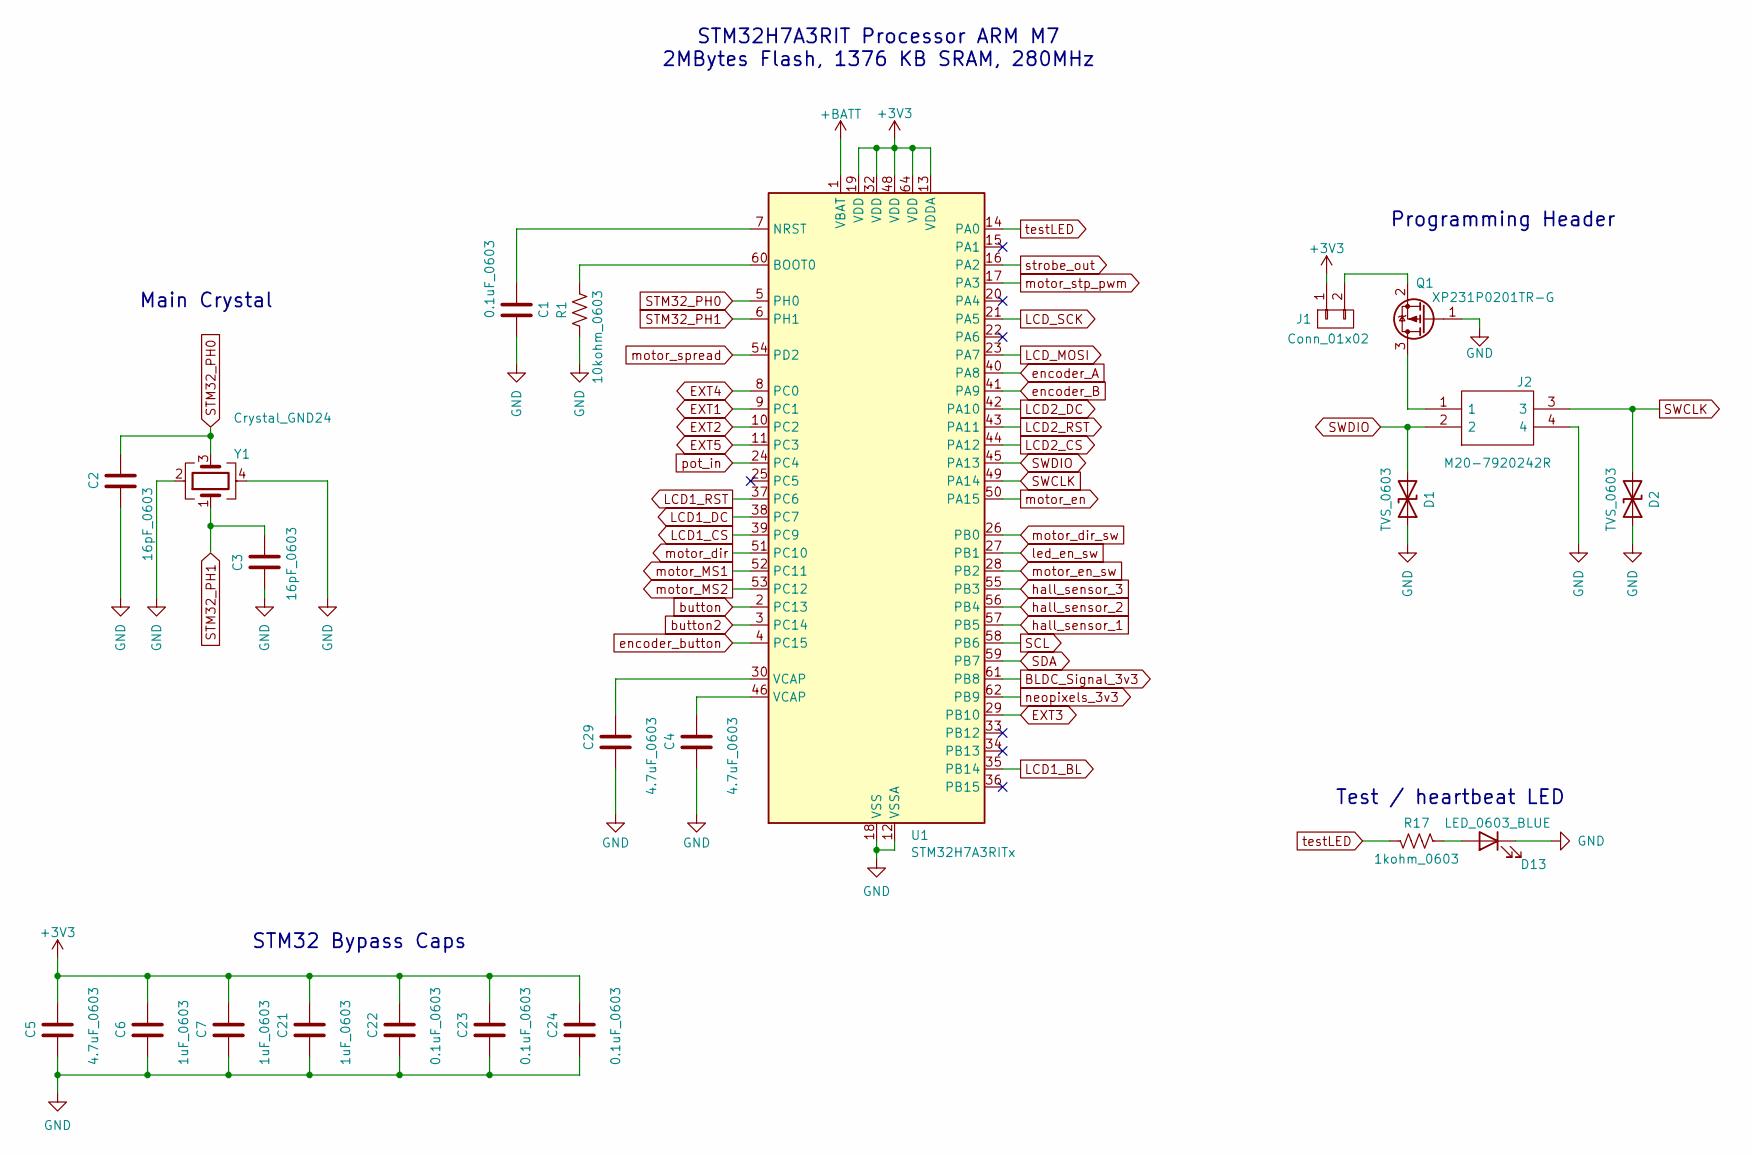
[picture p118: schematic Microcontroller.kicad_sch]

Parts:
C1, C22, C23, C24: 0.1uF_0603; C_0603_1608Metric
C2, C3: 16pF_0603; C_0603_1608Metric
C4, C5, C29: 4.7uF_0603; C_0603_1608Metric
C6, C7, C21: 1uF_0603; C_0603_1608Metric
D1, D2: TVS_0603; R_0603_1608Metric
D13: LED_0603_BLUE; LED_0603_1608Metric
J1: Conn_01x02; PinHeader_1x02_P2.54mm_Vertical
J2: M20-7920242R; M207920242R; Mouser Part Number 855-M20-7920242R
Q1: XP231P0201TR-G; SOT95P240X115-3N
R1: 10kohm_0603; R_0603_1608Metric
R17: 1kohm_0603; R_0603_1608Metric
U1: STM32H7A3RITx; LQFP-64_10x10mm_P0.5mm
Y1: Crystal_GND24; crystal_gnd24

Connections:
+BATT: U1.1 (VBAT); also elsewhere on the board
EXT1: U1.9 (PC1); also elsewhere on the board
EXT2: U1.10 (PC2); also elsewhere on the board
EXT3: U1.29 (PB10); also elsewhere on the board
EXT4: U1.8 (PC0); also elsewhere on the board
EXT5: U1.11 (PC3); also elsewhere on the board
LCD1_BL: U1.35 (PB14); also elsewhere on the board
LCD1_CS: U1.39 (PC9); also elsewhere on the board
LCD1_DC: U1.38 (PC7); also elsewhere on the board
LCD1_RST: U1.37 (PC6); also elsewhere on the board
LCD2_CS: U1.44 (PA12); also elsewhere on the board
LCD2_DC: U1.42 (PA10); also elsewhere on the board
LCD2_RST: U1.43 (PA11); also elsewhere on the board
LCD_MOSI: U1.23 (PA7); also elsewhere on the board
LCD_SCK: U1.21 (PA5); also elsewhere on the board
unnamed: C4.1, U1.46 (VCAP)
unnamed: C29.1, U1.30 (VCAP)
unnamed: J2.1, Q1.3 (D)
unnamed: R1.2, U1.60 (BOOT0)
unnamed: C1.1, U1.7 (NRST)
SCL: U1.58 (PB6); also elsewhere on the board
SDA: U1.59 (PB7); also elsewhere on the board
STM32_PH0: C2.1, U1.5 (PH0), Y1.3
STM32_PH1: C3.2, U1.6 (PH1), Y1.1
SWCLK: D2.2 (A2), J2.3, U1.49 (PA14)
SWDIO: D1.2 (A2), J2.2, U1.45 (PA13)
button: U1.2 (PC13); also elsewhere on the board
button2: U1.3 (PC14); also elsewhere on the board
encoder_A: U1.40 (PA8); also elsewhere on the board
encoder_B: U1.41 (PA9); also elsewhere on the board
encoder_button: U1.4 (PC15); also elsewhere on the board
hall_sensor_1: U1.57 (PB5); also elsewhere on the board
hall_sensor_2: U1.56 (PB4); also elsewhere on the board
hall_sensor_3: U1.55 (PB3); also elsewhere on the board
led_en_sw: U1.27 (PB1); also elsewhere on the board
motor_MS1: U1.52 (PC11); also elsewhere on the board
motor_MS2: U1.53 (PC12); also elsewhere on the board
motor_dir: U1.51 (PC10); also elsewhere on the board
motor_dir_sw: U1.26 (PB0); also elsewhere on the board
motor_en: U1.50 (PA15); also elsewhere on the board
motor_en_sw: U1.28 (PB2); also elsewhere on the board
motor_spread: U1.54 (PD2); also elsewhere on the board
motor_stp_pwm: U1.17 (PA3); also elsewhere on the board
neopixels_3v3: U1.62 (PB9); also elsewhere on the board
pot_in: U1.24 (PC4); also elsewhere on the board
strobe_out: U1.16 (PA2); also elsewhere on the board
testLED: R17.2, U1.14 (PA0)

Notes on the sheet:
STM32 Bypass Caps
Test / heartbeat LED
STM32H7A3RIT Processor ARM M7 2MBytes Flash, 1376 KB SRAM, 280MHz
Main Crystal
Programming Header

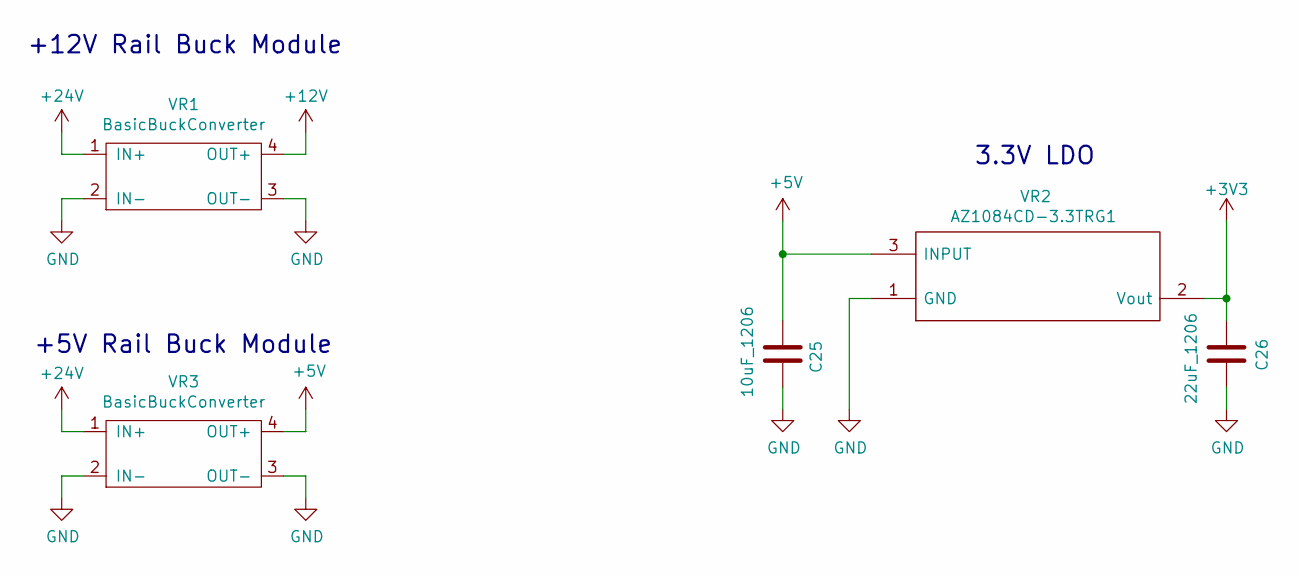
[picture p119: schematic Power.kicad_sch]

Parts:
C25: 10uF_1206; C_1206_3216Metric
C26: 22uF_1206; C_1206_3216Metric
VR1, VR3: BasicBuckConverter; LM2596_Module(43mmx21mm)
VR2: AZ1084CD-3.3TRG1; AZ1084CD33TRG1

Connections:
+12V: VR1.4 (OUT+); also elsewhere on the board
+24V: VR1.1 (IN+), VR3.1 (IN+); also elsewhere on the board

Notes on the sheet:
+12V Rail Buck Module
+5V Rail Buck Module
3.3V LDO

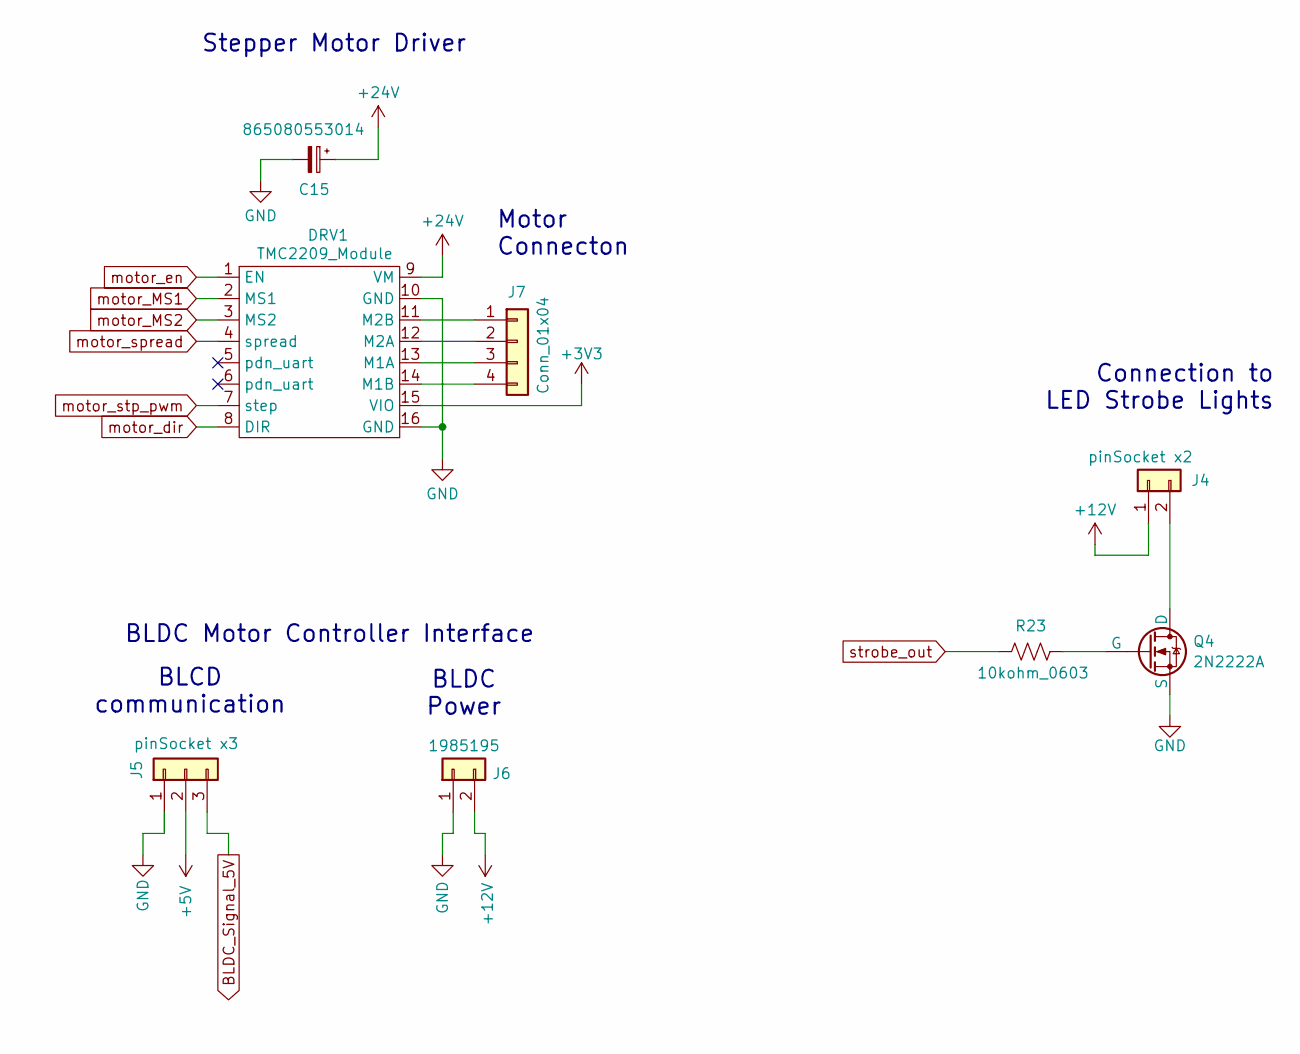
[picture p120: schematic Motor & LEDs_sch.kicad_sch]

Parts:
C15: 865080553014; CAPAE830X1050N
DRV1: TMC2209_Module
J4: pinSocket x2; PinSocket_1x02_P2.54mm_Vertical
J5: pinSocket x3; PinSocket_1x03_P2.54mm_Vertical
J6: 1985195
J7: Conn_01x04; PinHeader_1x04_P2.54mm_Vertical
Q4: 2N2222A; TO-92
R23: 10kohm_0603; R_0603_1608Metric

Connections:
+12V: J4.1, J6.2; also elsewhere on the board
+24V: C15.1, DRV1.9 (VM); also elsewhere on the board
unnamed: DRV1.13 (M1A), J7.3
unnamed: DRV1.14 (M1B), J7.4
unnamed: DRV1.12 (M2A), J7.2
unnamed: DRV1.11 (M2B), J7.1
unnamed: J4.2, Q4.3 (D)
unnamed: Q4.2 (G), R23.2
motor_MS1: DRV1.2 (MS1); also elsewhere on the board
motor_MS2: DRV1.3 (MS2); also elsewhere on the board
motor_dir: DRV1.8 (DIR); also elsewhere on the board
motor_en: DRV1.1 (EN); also elsewhere on the board
motor_spread: DRV1.4 (spread); also elsewhere on the board
motor_stp_pwm: DRV1.7 (step); also elsewhere on the board
strobe_out: R23.1; also elsewhere on the board

Notes on the sheet:
Stepper Motor Driver
Connection to LED Strobe Lights
BLDC Motor Controller Interface
Motor Connecton
BLDC Power
BLCD communication

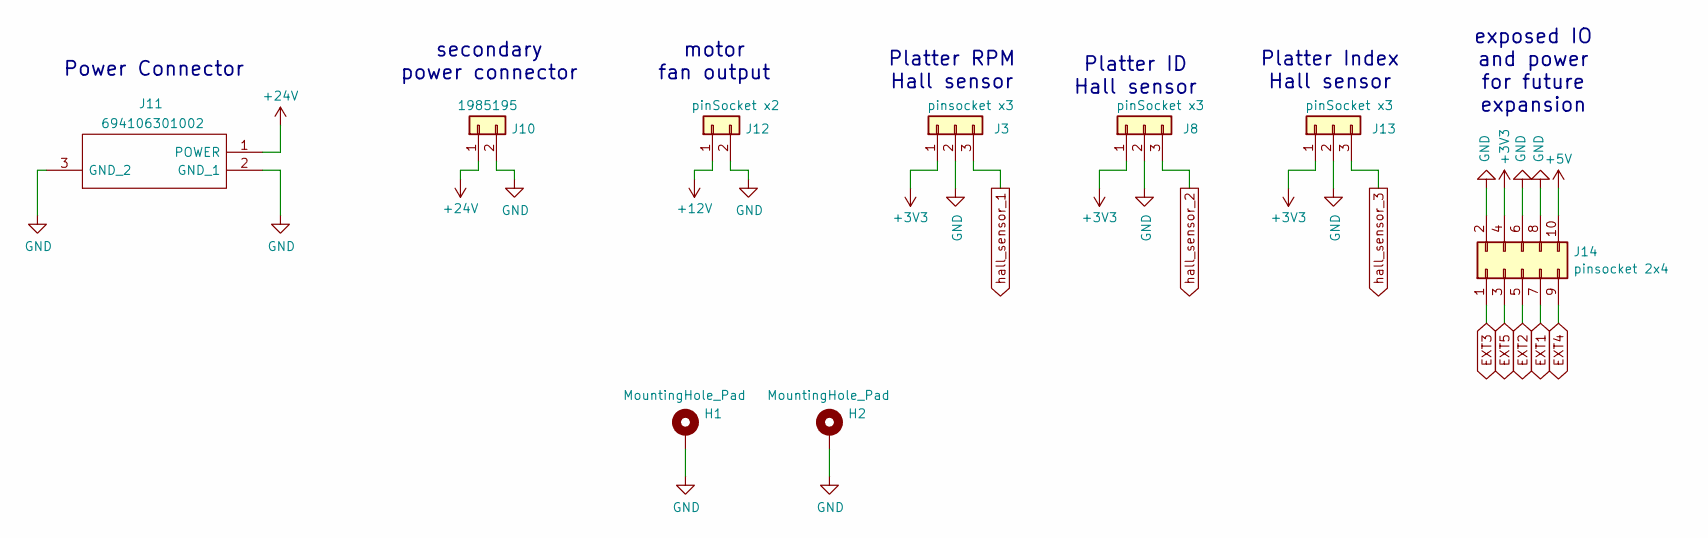
[picture p121: schematic Connectors.kicad_sch]

Parts:
H1, H2: MountingHole_Pad; 3mm_MH
J3: pinsocket x3; PinSocket_1x03_P2.54mm_Vertical
J8, J13: pinSocket x3; PinSocket_1x03_P2.54mm_Vertical
J10: 1985195
J11: 694106301002; 694106301002_1; Mouser Part Number 710-694106301002
J12: pinSocket x2; PinSocket_1x02_P2.54mm_Vertical
J14: pinsocket 2x4; PinSocket_2x05_P2.54mm_Vertical

Connections:
+12V: J12.1; also elsewhere on the board
+24V: J10.1, J11.1 (POWER); also elsewhere on the board
EXT1: J14.7; also elsewhere on the board
EXT2: J14.5; also elsewhere on the board
EXT3: J14.1; also elsewhere on the board
EXT4: J14.9; also elsewhere on the board
EXT5: J14.3; also elsewhere on the board
hall_sensor_1: J3.3; also elsewhere on the board
hall_sensor_2: J8.3; also elsewhere on the board
hall_sensor_3: J13.3; also elsewhere on the board

Notes on the sheet:
Platter ID Hall sensor
secondary power connector
exposed IO and power for future expansion
Platter RPM Hall sensor
Platter Index Hall sensor
Power Connector
motor fan output

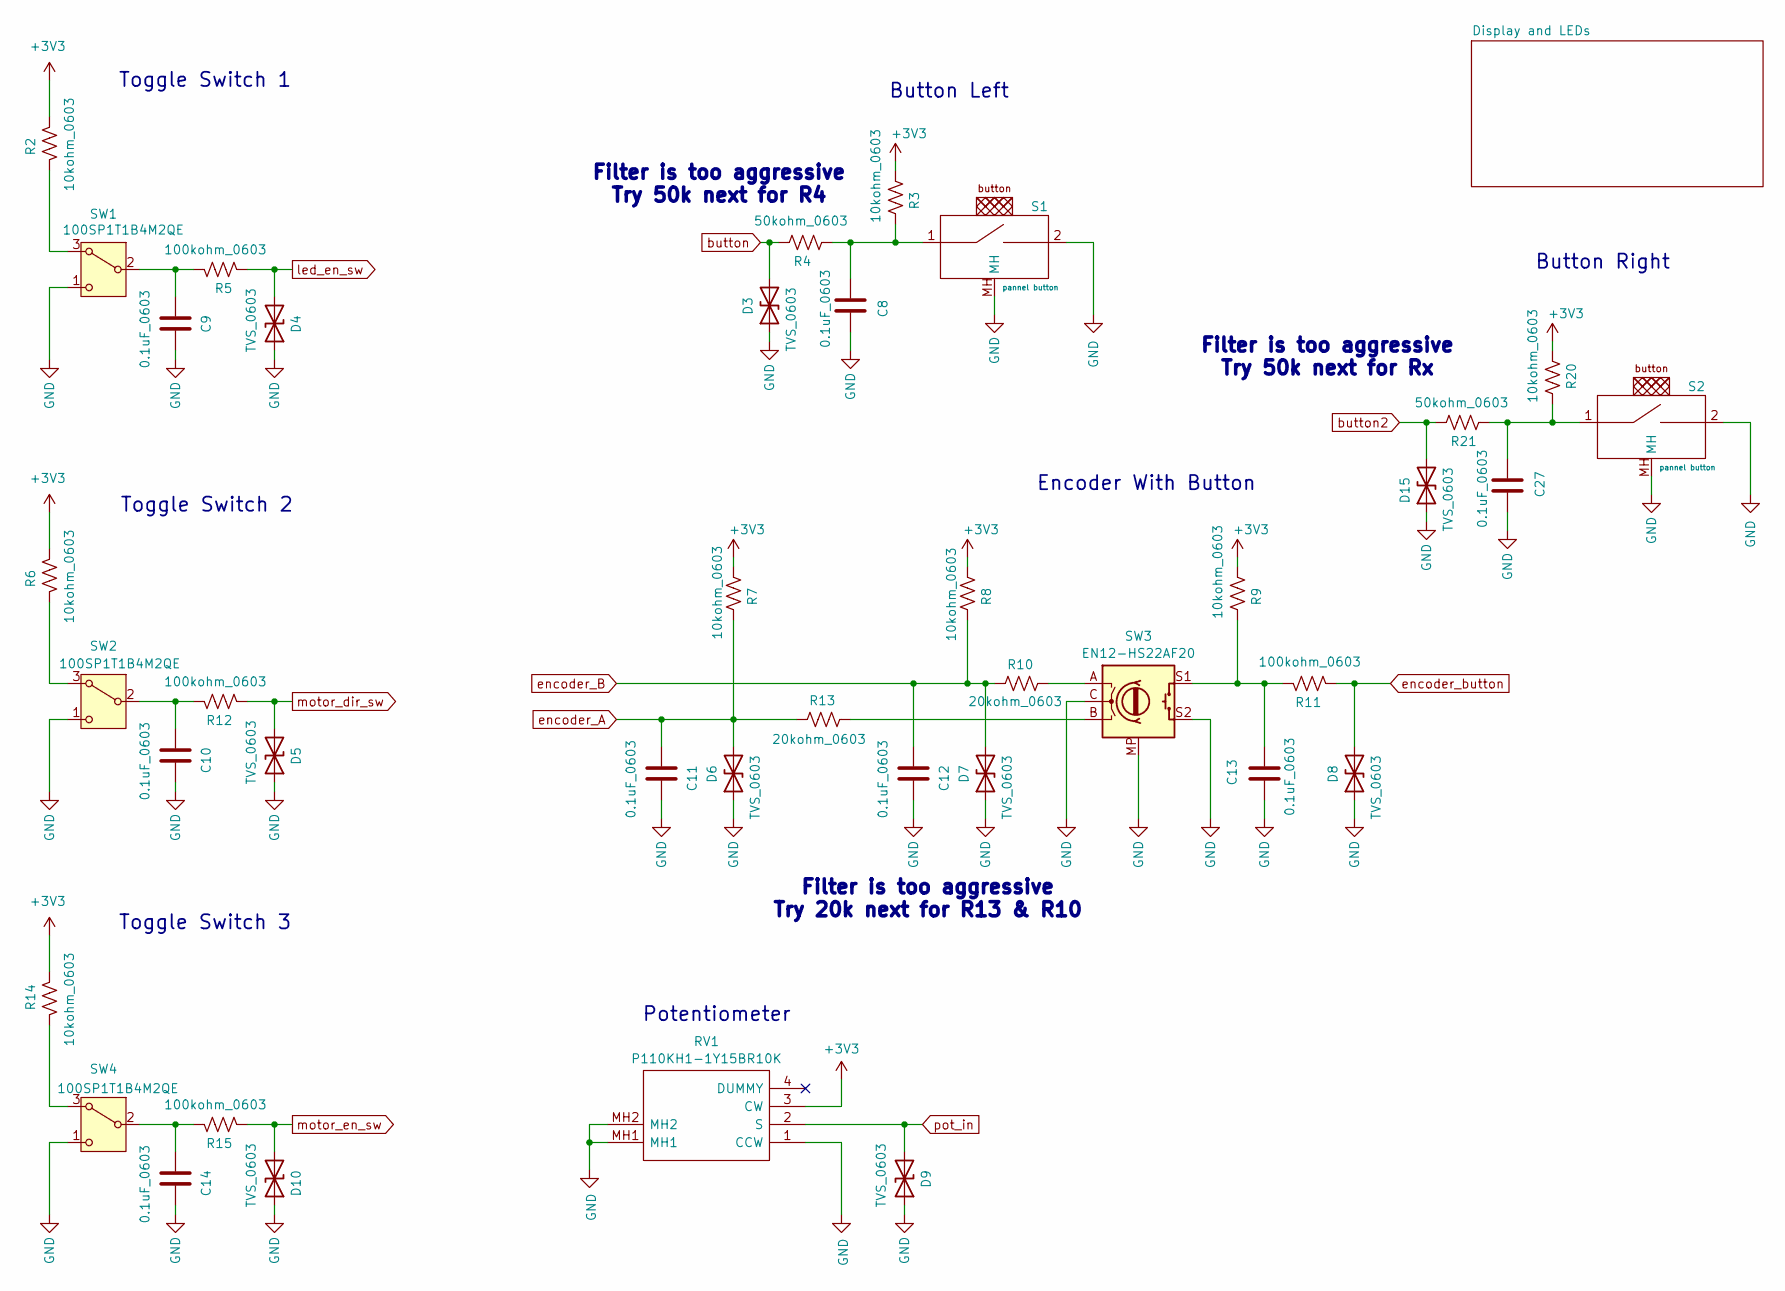
[picture p122: schematic Interface.kicad_sch]

Parts:
C8, C9, C10, C11, C12, C13, C14, C27: 0.1uF_0603; C_0603_1608Metric
D3, D4, D5, D6, D7, D8, D9, D10, D15: TVS_0603; R_0603_1608Metric
R2, R3, R6, R7, R8, R9, R14, R20: 10kohm_0603; R_0603_1608Metric
R4, R21: 50kohm_0603; R_0603_1608Metric
R5, R11, R12, R15: 100kohm_0603; R_0603_1608Metric
R10, R13: 20kohm_0603; R_0603_1608Metric
RV1: P110KH1-1Y15BR10K; P110KH11Y15BR10K; Mouser Part Number 858-P110KH11Y15BR10K
S1, S2: pannel button; 10mm_pannel_button2
SW1, SW2, SW4: 100SP1T1B4M2QE
SW3: EN12-HS22AF20; EN12HS22AF20

Connections:
unnamed: C8.1, R3.2, R4.1, S1.1
unnamed: C13.1, R9.2, R11.1, SW3.S1
unnamed: C27.1, R20.2, R21.1, S2.1
unnamed: R10.2, SW3.A
unnamed: R13.2, SW3.B
unnamed: R2.2, SW1.3 (A)
unnamed: C9.2, R5.1, SW1.2 (B)
unnamed: R6.2, SW2.3 (A)
unnamed: C10.2, R12.1, SW2.2 (B)
unnamed: R14.2, SW4.3 (A)
unnamed: C14.2, R15.1, SW4.2 (B)
button: D3.2 (A2), R4.2; also elsewhere on the board
button2: D15.2 (A2), R21.2; also elsewhere on the board
encoder_A: C11.2, D6.2 (A2), R7.2, R13.1; also elsewhere on the board
encoder_B: C12.2, D7.2 (A2), R8.2, R10.1; also elsewhere on the board
encoder_button: D8.2 (A2), R11.2; also elsewhere on the board
led_en_sw: D4.2 (A2), R5.2; also elsewhere on the board
motor_dir_sw: D5.2 (A2), R12.2; also elsewhere on the board
motor_en_sw: D10.2 (A2), R15.2; also elsewhere on the board
pot_in: D9.2 (A2), RV1.2 (S); also elsewhere on the board

Notes on the sheet:
Encoder With Button
Filter is too aggressive Try 20k next for R13 & R10
Filter is too aggressive Try 50k next for R4
Button Left
Toggle Switch 1
Button Right
Potentiometer
Toggle Switch 2
Toggle Switch 3
Filter is too aggressive Try 50k next for Rx
