TickingClocks/Zoetrope-Carousel-V4/Electrical/01_V3 Electrical Design/Animation Platter_V3.kicad_pcb

## KiCad design Electrical/01_V3 Electrical Design/Animation Platter_V3.kicad_pcb (continued)

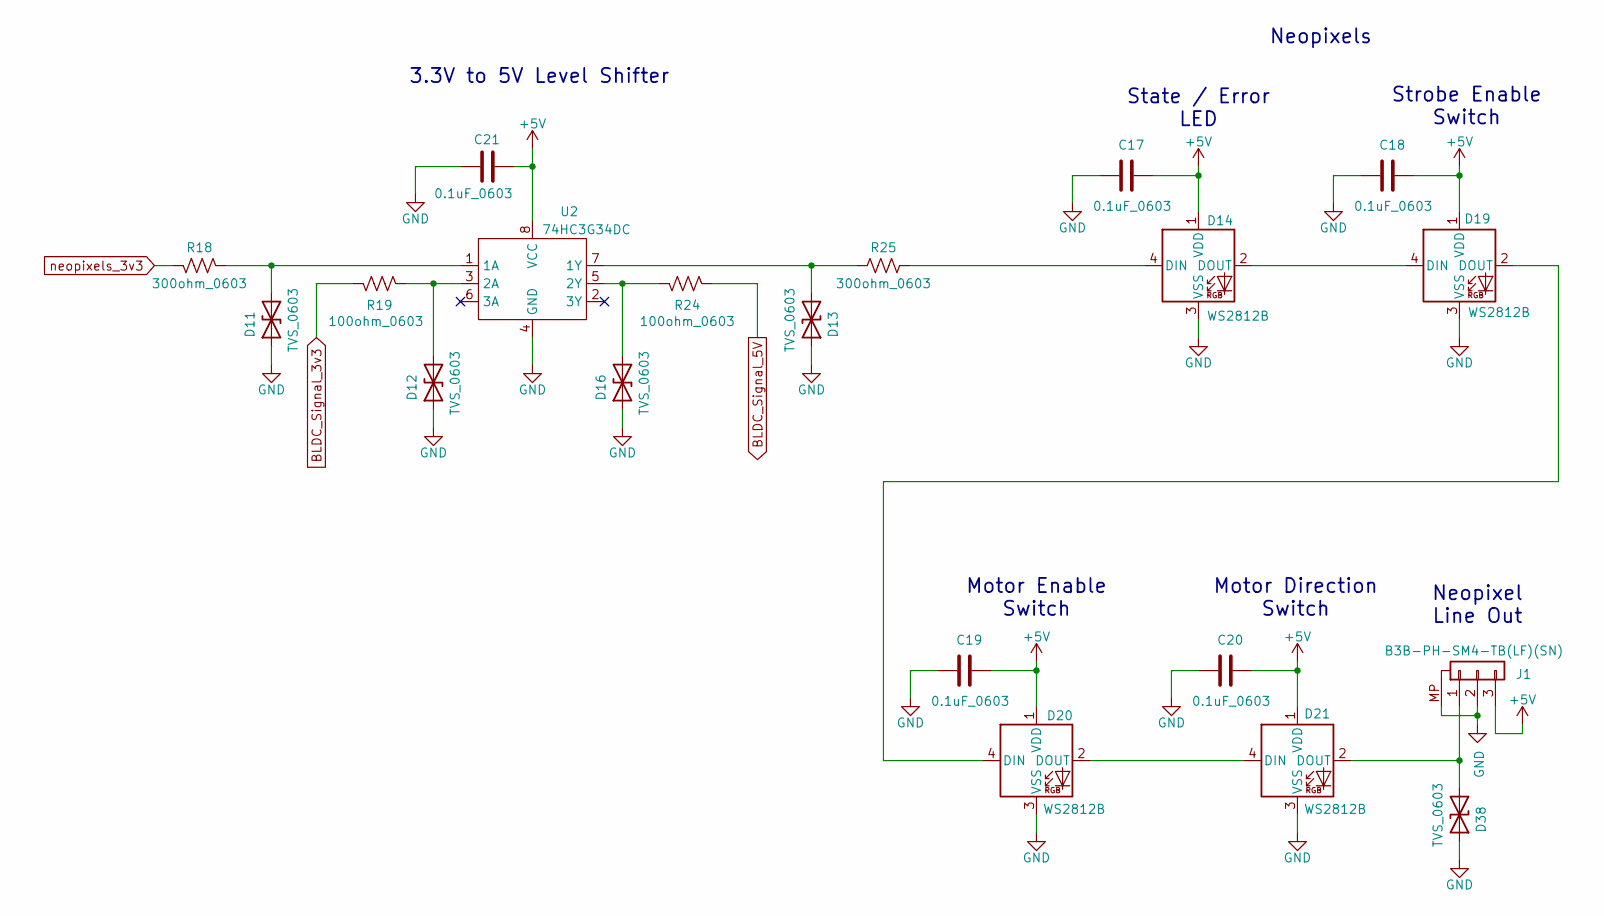
[picture p123: schematic Display and LEDs.kicad_sch, Neopixels]

Parts:
C17, C18, C19, C20, C21: 0.1uF_0603; C_0603_1608Metric
D11, D12, D13, D16, D38: TVS_0603; R_0603_1608Metric
D14, D19, D20, D21: WS2812B; LED_WS2812B_PLCC4_5.0x5.0mm_P3.2mm
J1: B3B-PH-SM4-TB(LF)(SN); JST_PH_B3B-PH-SM4-TB_1x03-1MP_P2.00mm_Vertical
R18, R25: 300ohm_0603; R_0603_1608Metric
R19, R24: 100ohm_0603; R_0603_1608Metric
U2: 74HC3G34DC

Connections:
unnamed: D11.2 (A2), R18.1, U2.1 (1A)
unnamed: D14.2 (DOUT), D19.4 (DIN)
unnamed: D19.2 (DOUT), D20.4 (DIN)
unnamed: D20.2 (DOUT), D21.4 (DIN)
neopixels_3v3: R18.2; also elsewhere on the board

Notes on the sheet:
State / Error LED
Neopixel Line Out
Strobe Enable Switch
Motor Direction Switch
Neopixels
3.3V to 5V Level Shifter
Motor Enable Switch

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
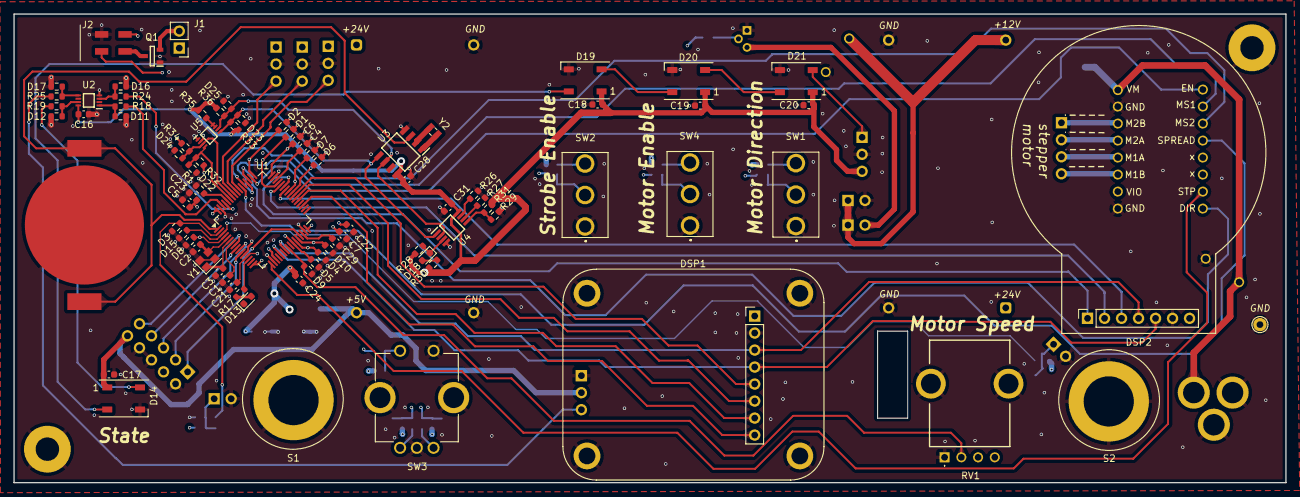
[picture p124: board Animation Platter_V3.kicad_pcb from above]

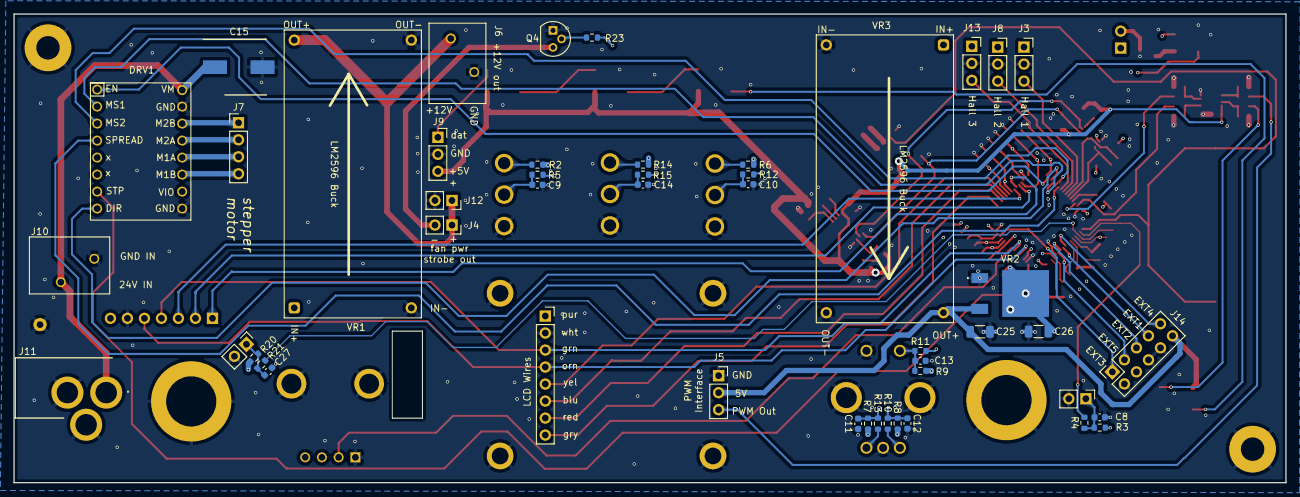
[picture p125: board Animation Platter_V3.kicad_pcb from below]

Board: 6 copper layers, 190.0 x 70.0 mm, 129 parts (45 on the bottom side), 92 nets.

Other parts of the board:
C16: 0.1uF_0603; C_0603_1608Metric
D17: TVS_0603; R_0603_1608Metric
DSP1: Conn_01x08; 240x280 LCD
DSP2: Conn_01x07; Circular LCD Display
J9: pinSocket x3; PinSocket_1x03_P2.54mm_Vertical
TP2: TestPoint; TestPoint_THTPad_D2.0mm_Drill1.0mm

Their connections:
LCD1_BL: DSP1.8; also elsewhere on the board
LCD1_CS: DSP1.5; also elsewhere on the board
LCD1_DC: DSP1.6; also elsewhere on the board
LCD1_RST: DSP1.7; also elsewhere on the board
LCD2_CS: DSP2.2; also elsewhere on the board
LCD2_DC: DSP2.3; also elsewhere on the board
LCD2_RST: DSP2.1; also elsewhere on the board
LCD_MOSI: DSP1.3, DSP2.4; also elsewhere on the board
LCD_SCK: DSP1.4, DSP2.5; also elsewhere on the board
