TickingClocks/Zoetrope-Carousel-V4/Electrical/01a_V4 - Saber - Spot Light/V1/00_Electrical Design/Saber_V1/Saber_V1.kicad_pcb

## KiCad design Electrical/01a_V4 - Saber - Spot Light/V1/00_Electrical Design/Saber_V1/Saber_V1.kicad_pcb (2026-05-01)

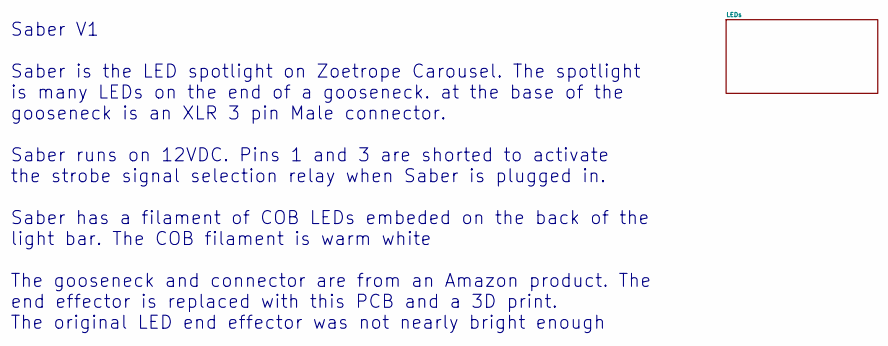
[picture p126: schematic Saber_V1.kicad_sch]

Notes on the sheet:
Saber V1 Saber is the LED spotlight on Zoetrope Carousel. The spotlight is many LEDs on the end of a gooseneck. at the base of the gooseneck is an XLR 3 pin Male connector. Saber runs on 12VDC. Pins 1 and 3 are shorted to activate the strobe signal selection relay when Saber is plugged in. Saber ha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

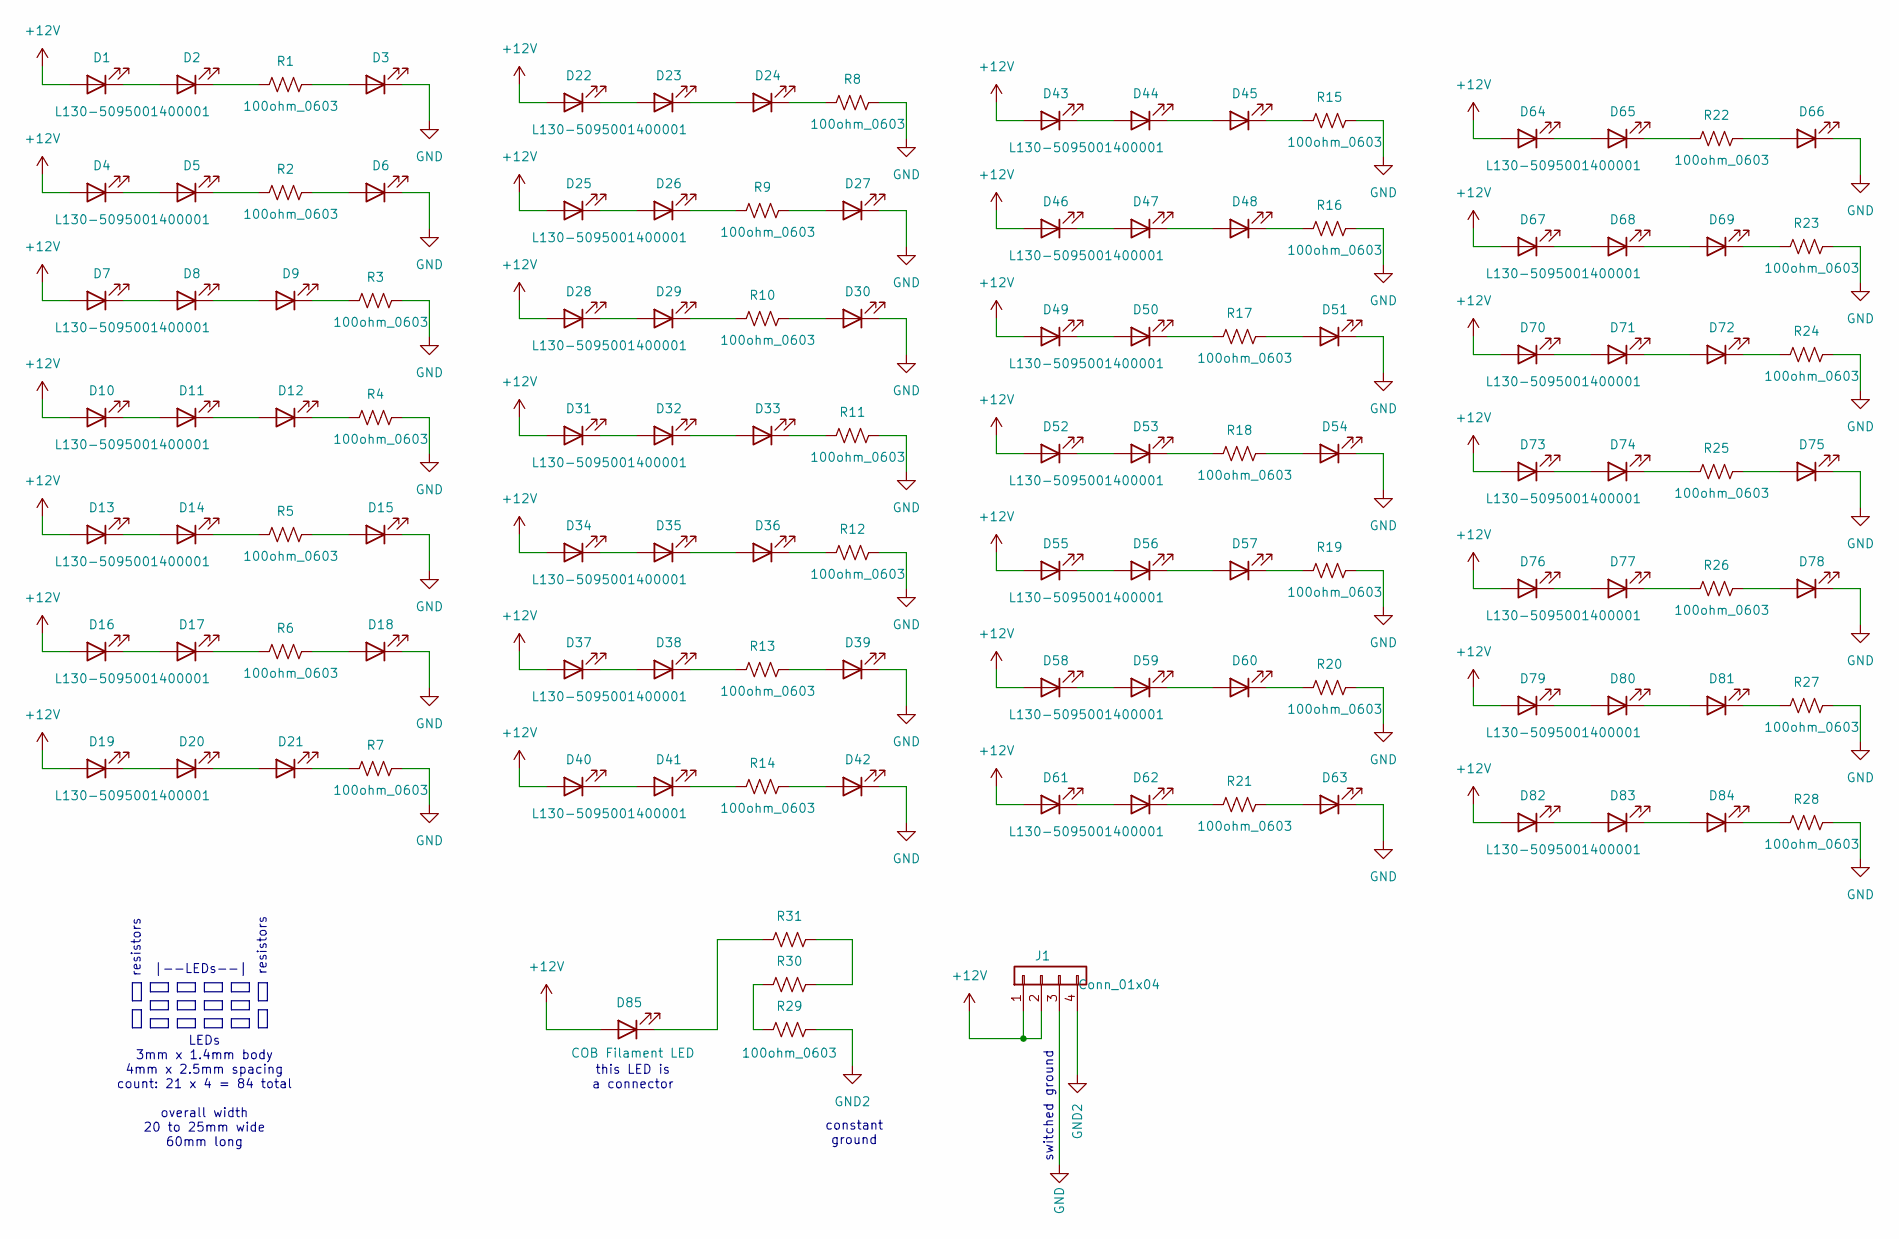
[picture p127: schematic LEDs.kicad_sch]

Parts:
D1, D2, D3, D4, D5, D6, D7, D8, D9, D10, D11, D12, D13, D14, D15, D16, D17, D18, D19, D20, D21, D22, D23, D24, D25, D26, D27, D28, D29, D30, D31, D32, D33, D34, D35, D36, D37, D38, D39, D40, D41, D42, D43, D44, D45, D46, D47, D48, D49, D50, D51, D52, D53, D54, D55, D56, D57, D58, D59, D60, D61, D62, D63, D64, D65, D66, D67, D68, D69, D70, D71, D72, D73, D74, D75, D76, D77, D78, D79, D80, D81, D82, D83, D84: L130-5095001400001; L1305095001400001
D85: COB Filament LED; PinHeader_1x02_P2.54mm_Vertical
J1: Conn_01x04; PinHeader_1x04_P2.54mm_Vertical
R1, R2, R3, R4, R5, R6, R7, R8, R9, R10, R11, R12, R13, R14, R15, R16, R17, R18, R19, R20, R21, R22, R23, R24, R25, R26, R27, R28, R29, R30, R31: 100ohm_0603; R_0603_1608Metric

Connections:
+12V: D1.2 (A), D4.2 (A), D7.2 (A), D10.2 (A), D13.2 (A), D16.2 (A), D19.2 (A), D22.2 (A), D25.2 (A), D28.2 (A), D31.2 (A), D34.2 (A), D37.2 (A), D40.2 (A), D43.2 (A), D46.2 (A), D49.2 (A), D52.2 (A), D55.2 (A), D58.2 (A), D61.2 (A), D64.2 (A), D67.2 (A), D70.2 (A), D73.2 (A), D76.2 (A), D79.2 (A), D82.2 (A), D85.2 (A), J1.1, J1.2
GND: D3.1 (K), D6.1 (K), D15.1 (K), D18.1 (K), D27.1 (K), D30.1 (K), D39.1 (K), D42.1 (K), D51.1 (K), D54.1 (K), D63.1 (K), D66.1 (K), D75.1 (K), D78.1 (K), J1.3, R3.2, R4.2, R7.2, R8.2, R11.2, R12.2, R15.2, R16.2, R19.2, R20.2, R23.2, R24.2, R27.2, R28.2
GND2: J1.4, R29.2
unnamed: D1.1 (K), D2.2 (A)
unnamed: D2.1 (K), R1.1
unnamed: D3.2 (A), R1.2
unnamed: D4.1 (K), D5.2 (A)
unnamed: D5.1 (K), R2.1
unnamed: D6.2 (A), R2.2
unnamed: D7.1 (K), D8.2 (A)
unnamed: D8.1 (K), D9.2 (A)
unnamed: D9.1 (K), R3.1
unnamed: D10.1 (K), D11.2 (A)
unnamed: D11.1 (K), D12.2 (A)
unnamed: D12.1 (K), R4.1
unnamed: D13.1 (K), D14.2 (A)
unnamed: D14.1 (K), R5.1
unnamed: D15.2 (A), R5.2
unnamed: D16.1 (K), D17.2 (A)
unnamed: D17.1 (K), R6.1
unnamed: D18.2 (A), R6.2
unnamed: D19.1 (K), D20.2 (A)
unnamed: D20.1 (K), D21.2 (A)
unnamed: D21.1 (K), R7.1
unnamed: D22.1 (K), D23.2 (A)
unnamed: D23.1 (K), D24.2 (A)
unnamed: D24.1 (K), R8.1
unnamed: D25.1 (K), D26.2 (A)
unnamed: D26.1 (K), R9.1
unnamed: D27.2 (A), R9.2
unnamed: D28.1 (K), D29.2 (A)
unnamed: D29.1 (K), R10.1
unnamed: D30.2 (A), R10.2
unnamed: D31.1 (K), D32.2 (A)
unnamed: D32.1 (K), D33.2 (A)
unnamed: D33.1 (K), R11.1
unnamed: D34.1 (K), D35.2 (A)
unnamed: D35.1 (K), D36.2 (A)
unnamed: D36.1 (K), R12.1
unnamed: D37.1 (K), D38.2 (A)
unnamed: D38.1 (K), R13.1
unnamed: D39.2 (A), R13.2
unnamed: D40.1 (K), D41.2 (A)
unnamed: D41.1 (K), R14.1
unnamed: D42.2 (A), R14.2
unnamed: D43.1 (K), D44.2 (A)
unnamed: D44.1 (K), D45.2 (A)
unnamed: D45.1 (K), R15.1
unnamed: D46.1 (K), D47.2 (A)
unnamed: D47.1 (K), D48.2 (A)
unnamed: D48.1 (K), R16.1
unnamed: D49.1 (K), D50.2 (A)
unnamed: D50.1 (K), R17.1
unnamed: D51.2 (A), R17.2
unnamed: D52.1 (K), D53.2 (A)
unnamed: D53.1 (K), R18.1
unnamed: D54.2 (A), R18.2
unnamed: D55.1 (K), D56.2 (A)
unnamed: D56.1 (K), D57.2 (A)
unnamed: D57.1 (K), R19.1
unnamed: D58.1 (K), D59.2 (A)
unnamed: D59.1 (K), D60.2 (A)
unnamed: D60.1 (K), R20.1
unnamed: D61.1 (K), D62.2 (A)
unnamed: D62.1 (K), R21.1
unnamed: D63.2 (A), R21.2
unnamed: D64.1 (K), D65.2 (A)
unnamed: D65.1 (K), R22.1
unnamed: D66.2 (A), R22.2
unnamed: D67.1 (K), D68.2 (A)
unnamed: D68.1 (K), D69.2 (A)
unnamed: D69.1 (K), R23.1
unnamed: D70.1 (K), D71.2 (A)
unnamed: D71.1 (K), D72.2 (A)
unnamed: D72.1 (K), R24.1
unnamed: D73.1 (K), D74.2 (A)
unnamed: D74.1 (K), R25.1
unnamed: D75.2 (A), R25.2
unnamed: D76.1 (K), D77.2 (A)
unnamed: D77.1 (K), R26.1
unnamed: D78.2 (A), R26.2
unnamed: D79.1 (K), D80.2 (A)
unnamed: D80.1 (K), D81.2 (A)
unnamed: D81.1 (K), R27.1
unnamed: D82.1 (K), D83.2 (A)
unnamed: D83.1 (K), D84.2 (A)
unnamed: D84.1 (K), R28.1
unnamed: D85.1 (K), R31.1
unnamed: R29.1, R30.1
unnamed: R30.2, R31.2

Notes on the sheet:
this LED is a connector
resistors
LEDs 3mm x 1.4mm body 4mm x 2.5mm spacing count: 21 x 4 = 84 total overall width 20 to 25mm wide 60mm long
constant ground
switched ground
|--LEDs--|

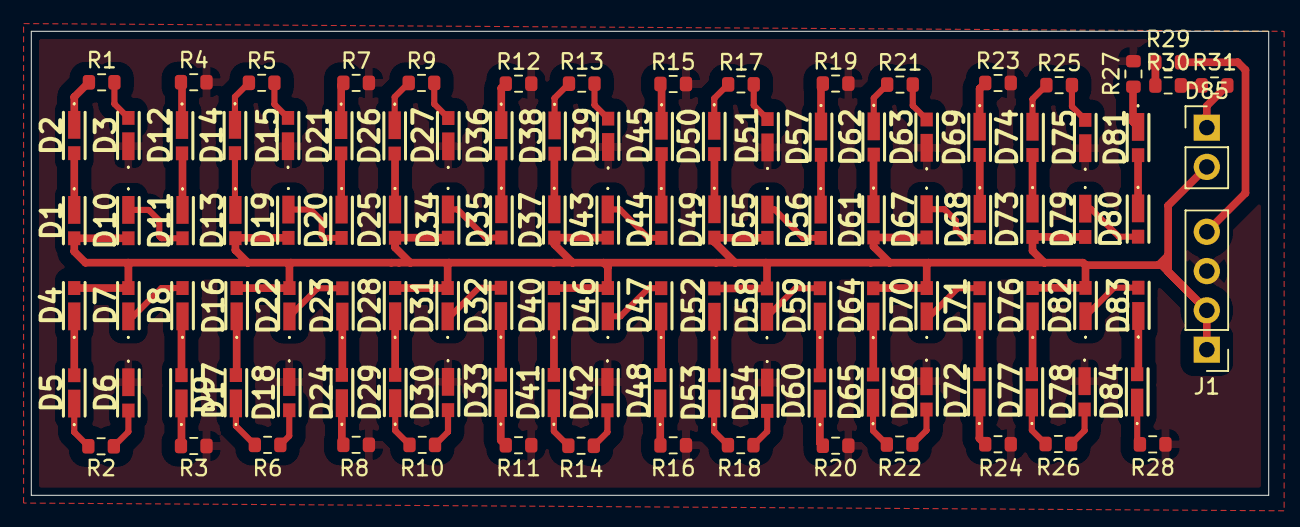
[picture p128: board Saber_V1.kicad_pcb from above]

Board: 2 copper layers, 80.0 x 30.0 mm, 117 parts (0 on the bottom side), 90 nets.
