TickingClocks/Zoetrope-Carousel-V4/Electrical/01b_V4 - Photoeye PCB/V1/00_Electrical/photoOnlyEyePCB_V1/PhotoeyeOnlyEye PCB_V1.kicad_pcb

## KiCad design Electrical/01b_V4 - Photoeye PCB/V1/00_Electrical/photoOnlyEyePCB_V1/PhotoeyeOnlyEye PCB_V1.kicad_pcb (2026-05-01)

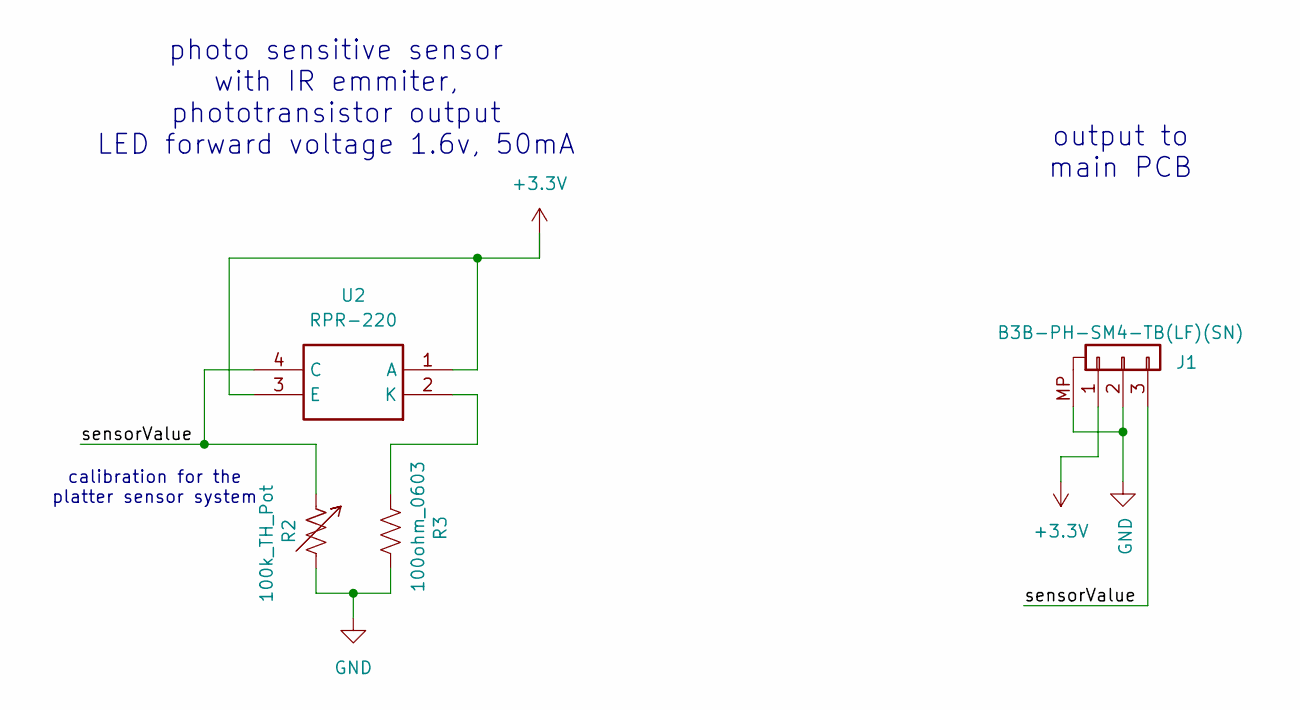
[picture p129: schematic PhotoeyeOnlyEye PCB_V1.kicad_sch]

Parts:
J1: B3B-PH-SM4-TB(LF)(SN); JST_PH_B3B-PH-SM4-TB_1x03-1MP_P2.00mm_Vertical
R2: 100k_TH_Pot; Potentiometer_TH
R3: 100ohm_0603; R_0603_1608Metric
U2: RPR-220; RPR220; Mouser Part Number 755-RPR-220

Connections:
+3.3V: J1.1, U2.1 (A), U2.3 (E)
/sensorValue: J1.3, R2.1, U2.4 (C)
GND: J1.2, J1.MP (Pin_1), R2.2, R2.3, R3.1
unnamed: R3.2, U2.2 (K)

Notes on the sheet:
output to main PCB
photo sensitive sensor with IR emmiter, phototransistor output LED forward voltage 1.6v, 50mA
calibration for the platter sensor system

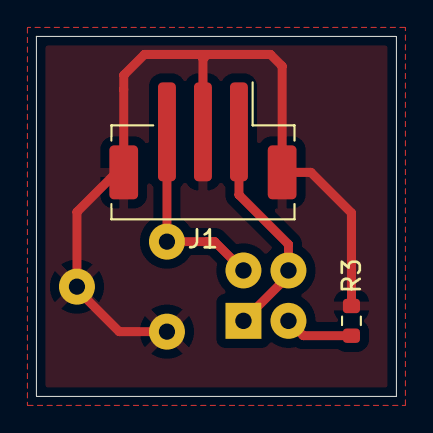
[picture p130: board PhotoeyeOnlyEye PCB_V1.kicad_pcb from above]

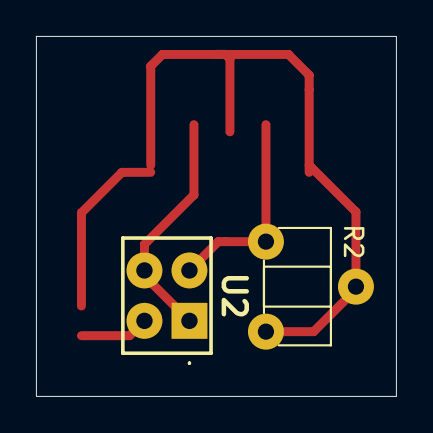
[picture p131: board PhotoeyeOnlyEye PCB_V1.kicad_pcb from below]

Board: 2 copper layers, 20.0 x 20.0 mm, 4 parts (2 on the bottom side), 4 nets.
