TickingClocks/Zoetrope-Carousel-V4/Electrical/Animation Platter_V1/Animation Platter_V1.kicad_pcb

## KiCad design Electrical/Animation Platter_V1/Animation Platter_V1.kicad_pcb (2026-05-01)

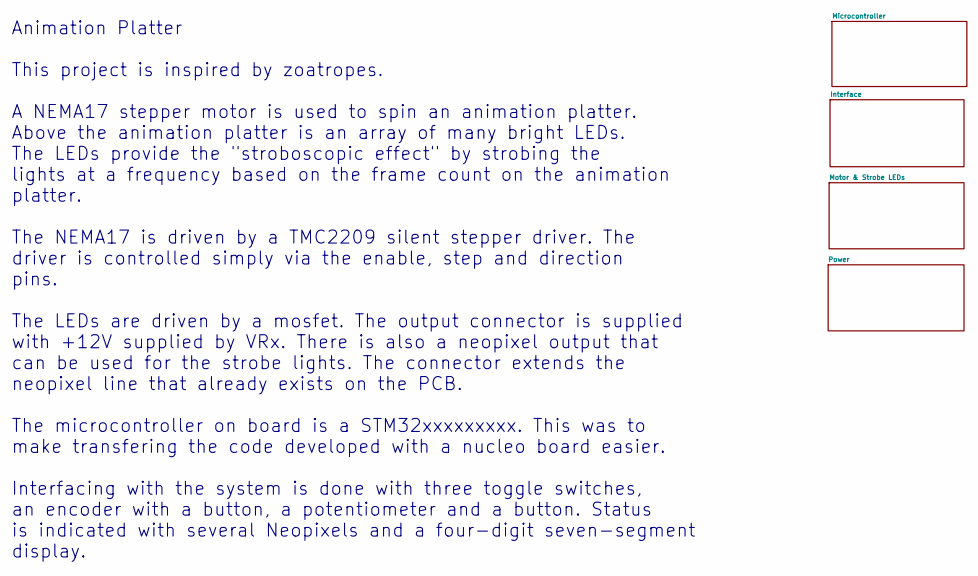
[picture p132: schematic Animation Platter_V1.kicad_sch]

Notes on the sheet:
Animation Platter This project is inspired by zoatropes. A NEMA17 stepper motor is used to spin an animation platter. Above the animation platter is an array of many bright LEDs. The LEDs provide the "stroboscopic effect" by strobing the lights at a frequency based on the frame count on the animati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

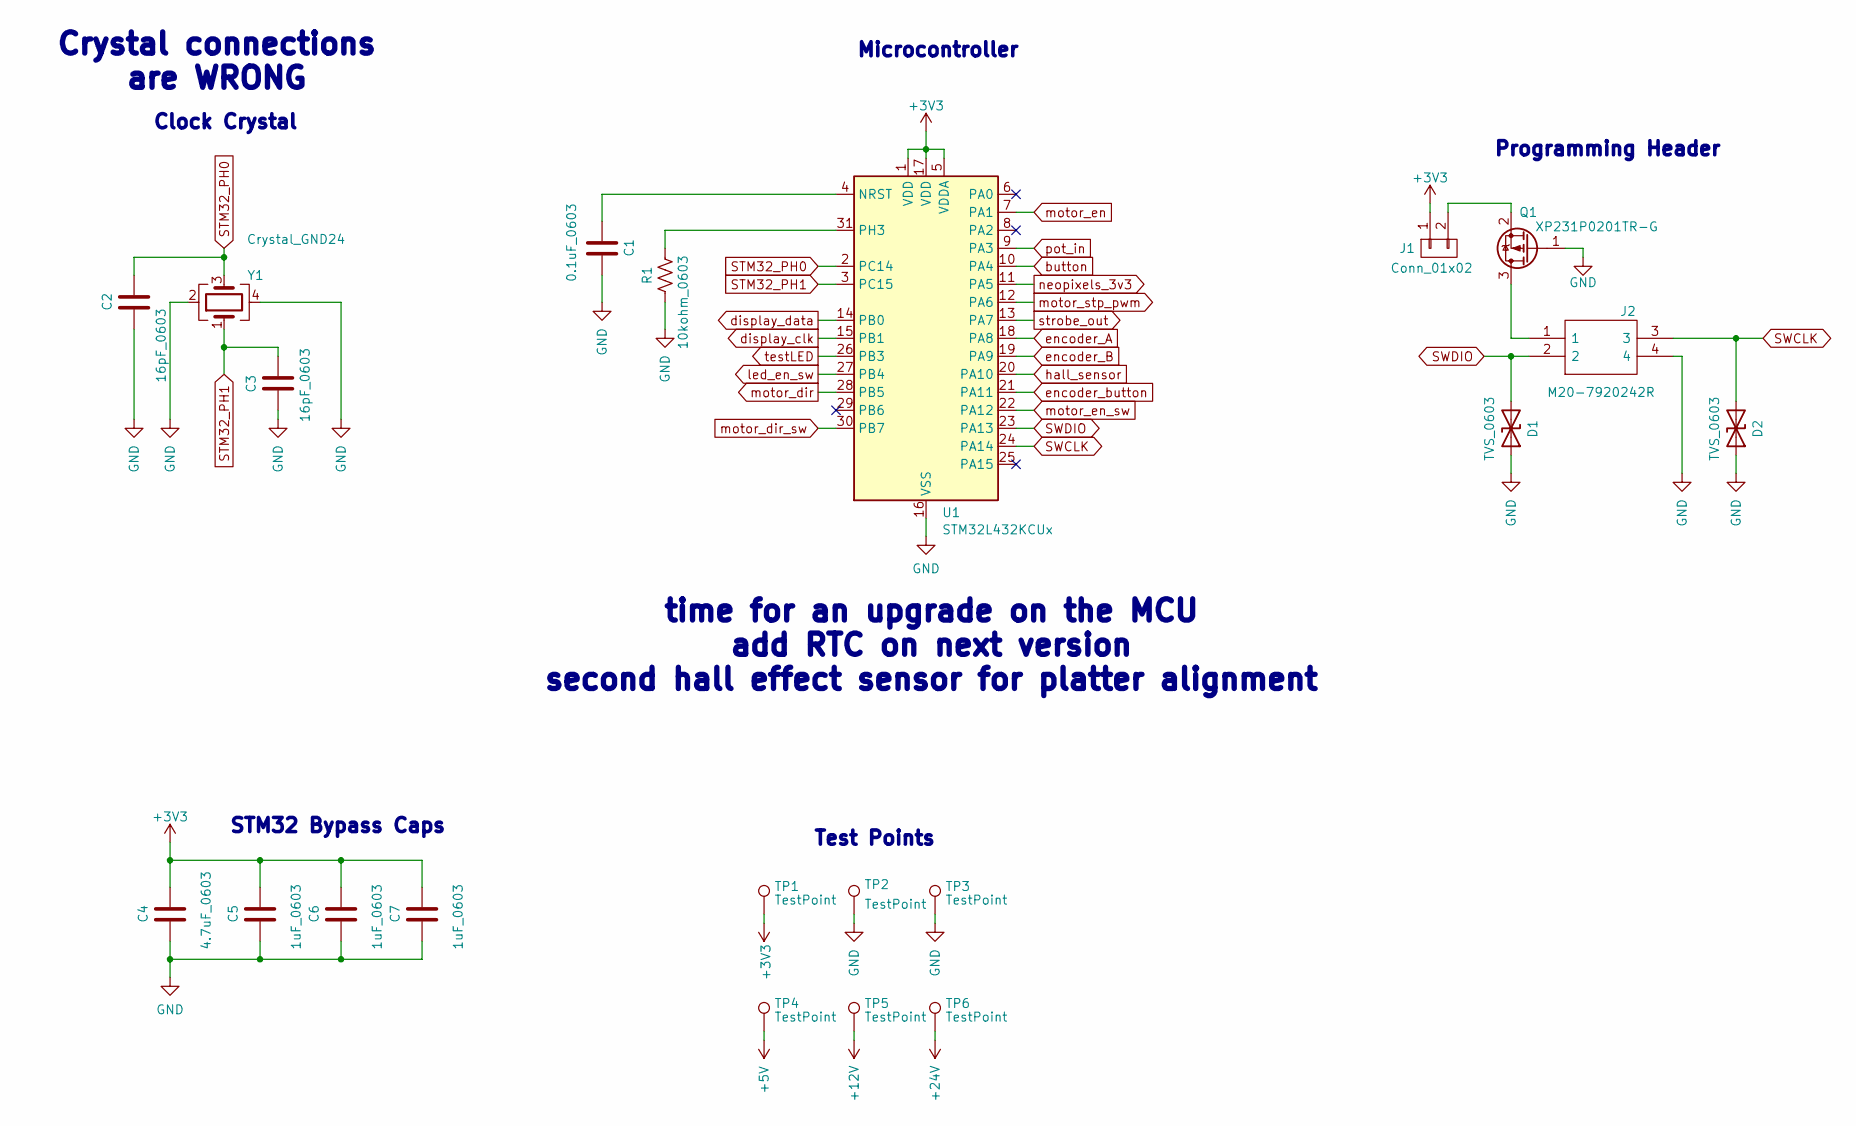
[picture p133: schematic Microcontroller.kicad_sch]

Parts:
C1: 0.1uF_0603; C_0603_1608Metric
C2, C3: 16pF_0603; C_0603_1608Metric
C4: 4.7uF_0603; C_0603_1608Metric
C5, C6, C7: 1uF_0603; C_0603_1608Metric
D1, D2: TVS_0603; D_0603_1608Metric
J1: Conn_01x02; PinHeader_1x02_P2.54mm_Vertical
J2: M20-7920242R; M207920242R; Mouser Part Number 855-M20-7920242R
Q1: XP231P0201TR-G; SOT95P240X115-3N
R1: 10kohm_0603; R_0603_1608Metric
TP1, TP4, TP5, TP6: TestPoint; TestPoint_Pad_D1.0mm
TP2, TP3: TestPoint; TestPoint_THTPad_D2.0mm_Drill1.0mm
U1: STM32L432KCUx; QFN-32-1EP_5x5mm_P0.5mm_EP3.45x3.45mm
Y1: Crystal_GND24; Crystal_SMD_2520-4Pin_2.5x2.0mm

Connections:
+3V3: C4.1, C5.1, C6.1, C7.1, J1.1, TP1.1, U1.1 (VDD), U1.5 (VDDA), U1.17 (VDD); also elsewhere on the board
+5V: TP4.1; also elsewhere on the board
+12V: TP5.1; also elsewhere on the board
+24V: TP6.1; also elsewhere on the board
GND: C1.2, C2.2, C3.1, C4.2, C5.2, C6.2, C7.2, D1.1 (A1), D2.1 (A1), J2.4, Q1.1 (G), R1.1, TP2.1, TP3.1, U1.16 (VSS), U1.32 (VSS), U1.33 (VSS), Y1.2, Y1.4; also elsewhere on the board
unnamed: J1.2, Q1.2 (S)
unnamed: J2.1, Q1.3 (D)
unnamed: C1.1, U1.4 (NRST)
unnamed: R1.2, U1.31 (PH3)
STM32_PH0: C2.1, U1.2 (PC14), Y1.3
STM32_PH1: C3.2, U1.3 (PC15), Y1.1
SWCLK: D2.2 (A2), J2.3, U1.24 (PA14)
SWDIO: D1.2 (A2), J2.2, U1.23 (PA13)
button: U1.10 (PA4); also elsewhere on the board
display_clk: U1.15 (PB1); also elsewhere on the board
display_data: U1.14 (PB0); also elsewhere on the board
encoder_A: U1.18 (PA8); also elsewhere on the board
encoder_B: U1.19 (PA9); also elsewhere on the board
encoder_button: U1.21 (PA11); also elsewhere on the board
hall_sensor: U1.20 (PA10); also elsewhere on the board
led_en_sw: U1.27 (PB4); also elsewhere on the board
motor_dir: U1.28 (PB5); also elsewhere on the board
motor_dir_sw: U1.30 (PB7); also elsewhere on the board
motor_en: U1.7 (PA1); also elsewhere on the board
motor_en_sw: U1.22 (PA12); also elsewhere on the board
motor_stp_pwm: U1.12 (PA6); also elsewhere on the board
neopixels_3v3: U1.11 (PA5); also elsewhere on the board
pot_in: U1.9 (PA3); also elsewhere on the board
strobe_out: U1.13 (PA7); also elsewhere on the board
testLED: U1.26 (PB3); also elsewhere on the board

Notes on the sheet:
time for an upgrade on the MCU add RTC on next version second hall effect sensor for platter alignment
STM32 Bypass Caps
Clock Crystal
Crystal connections are WRONG
Microcontroller
Test Points
Programming Header

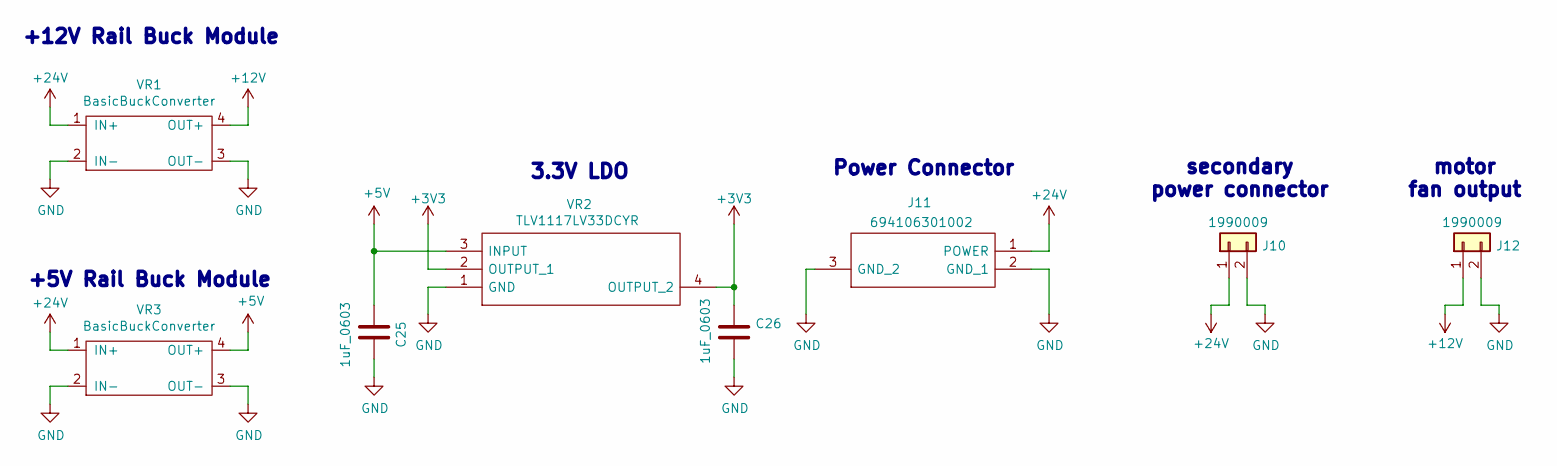
[picture p134: schematic Power.kicad_sch]

Parts:
C25, C26: 1uF_0603; C_0603_1608Metric
J10, J12: 1990009
J11: 694106301002; 694106301002_1; Mouser Part Number 710-694106301002
VR1, VR3: BasicBuckConverter; LM2596_Module(43mmx21mm)
VR2: TLV1117LV33DCYR; SOT230P700X180-4N; Mouser Part Number 595-TLV1117LV33DCYR

Connections:
+3V3: C26.2, VR2.2 (OUTPUT_1), VR2.4 (OUTPUT_2); also elsewhere on the board
+5V: C25.2, VR2.3 (INPUT), VR3.4 (OUT+); also elsewhere on the board
+12V: J12.1, VR1.4 (OUT+); also elsewhere on the board
+24V: J10.1, J11.1 (POWER), VR1.1 (IN+), VR3.1 (IN+); also elsewhere on the board
GND: C25.1, C26.1, J10.2, J11.2 (GND_1), J11.3 (GND_2), J12.2, VR1.2 (IN-), VR1.3 (OUT-), VR2.1 (GND), VR3.2 (IN-), VR3.3 (OUT-); also elsewhere on the board

Notes on the sheet:
+12V Rail Buck Module
+5V Rail Buck Module
secondary power connector
3.3V LDO
motor fan output
Power Connector

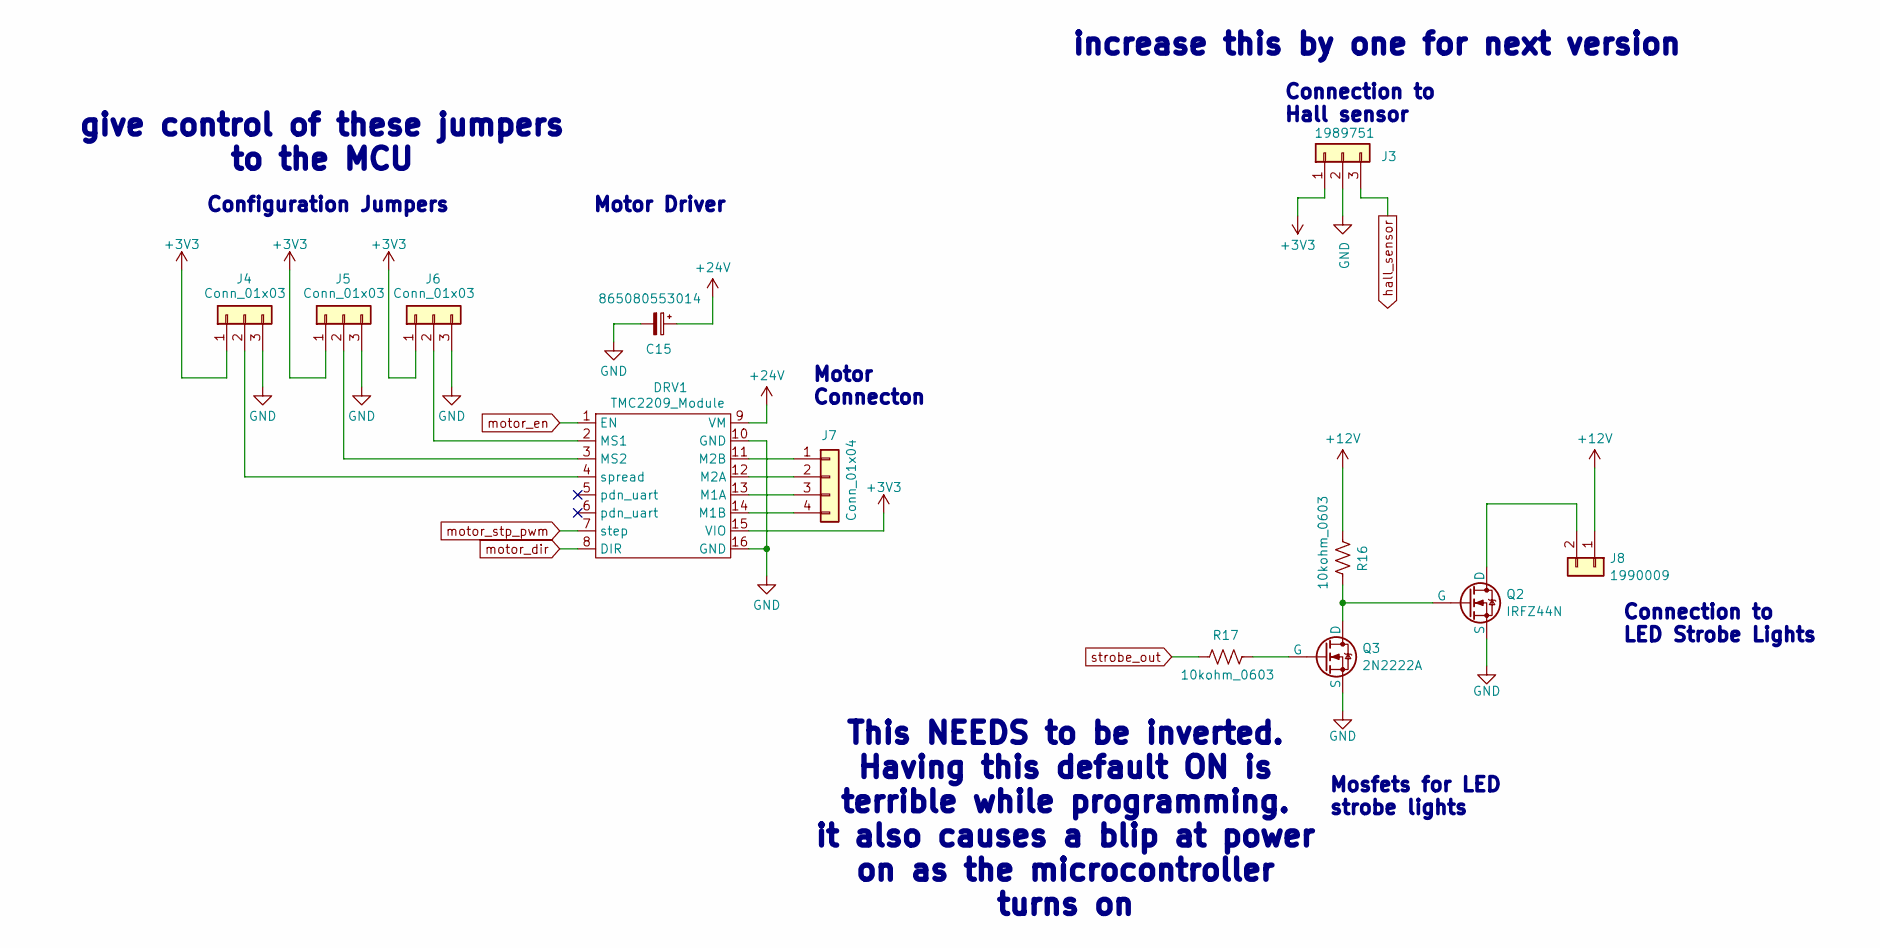
[picture p135: schematic Motor & LEDs_sch.kicad_sch]

Parts:
C15: 865080553014; CAPAE830X1050N
DRV1: TMC2209_Module
J3: 1989751
J4, J5, J6: Conn_01x03; PinHeader_1x03_P2.54mm_Vertical
J7: Conn_01x04; PinHeader_1x04_P2.54mm_Vertical
J8: 1990009
Q2: IRFZ44N; IRFZ44NSTRLPBF
Q3: 2N2222A; TO-92
R16, R17: 10kohm_0603; R_0603_1608Metric

Connections:
+3V3: DRV1.15 (VIO), J3.1, J4.1, J5.1, J6.1; also elsewhere on the board
+12V: J8.1, R16.1; also elsewhere on the board
+24V: C15.1, DRV1.9 (VM); also elsewhere on the board
GND: C15.2, DRV1.10 (GND), DRV1.16 (GND), J3.2, J4.3, J5.3, J6.3, Q2.3 (S), Q3.1 (S); also elsewhere on the board
unnamed: DRV1.13 (M1A), J7.3
unnamed: DRV1.14 (M1B), J7.4
unnamed: DRV1.12 (M2A), J7.2
unnamed: DRV1.11 (M2B), J7.1
unnamed: DRV1.2 (MS1), J6.2
unnamed: DRV1.3 (MS2), J5.2
unnamed: DRV1.4 (spread), J4.2
unnamed: J8.2, Q2.2 (D)
unnamed: Q2.1 (G), Q3.3 (D), R16.2
unnamed: Q3.2 (G), R17.2
hall_sensor: J3.3; also elsewhere on the board
motor_dir: DRV1.8 (DIR); also elsewhere on the board
motor_en: DRV1.1 (EN); also elsewhere on the board
motor_stp_pwm: DRV1.7 (step); also elsewhere on the board
strobe_out: R17.1; also elsewhere on the board

Notes on the sheet:
Motor Driver
Connection to LED Strobe Lights
Connection to Hall sensor
Configuration Jumpers
This NEEDS to be inverted. Having this default ON is terrible while programming. it also causes a blip at power on as the microcontroller turns on
Motor Connecton
Mosfets for LED strobe lights
increase this by one for next version
give control of these jumpers to the MCU

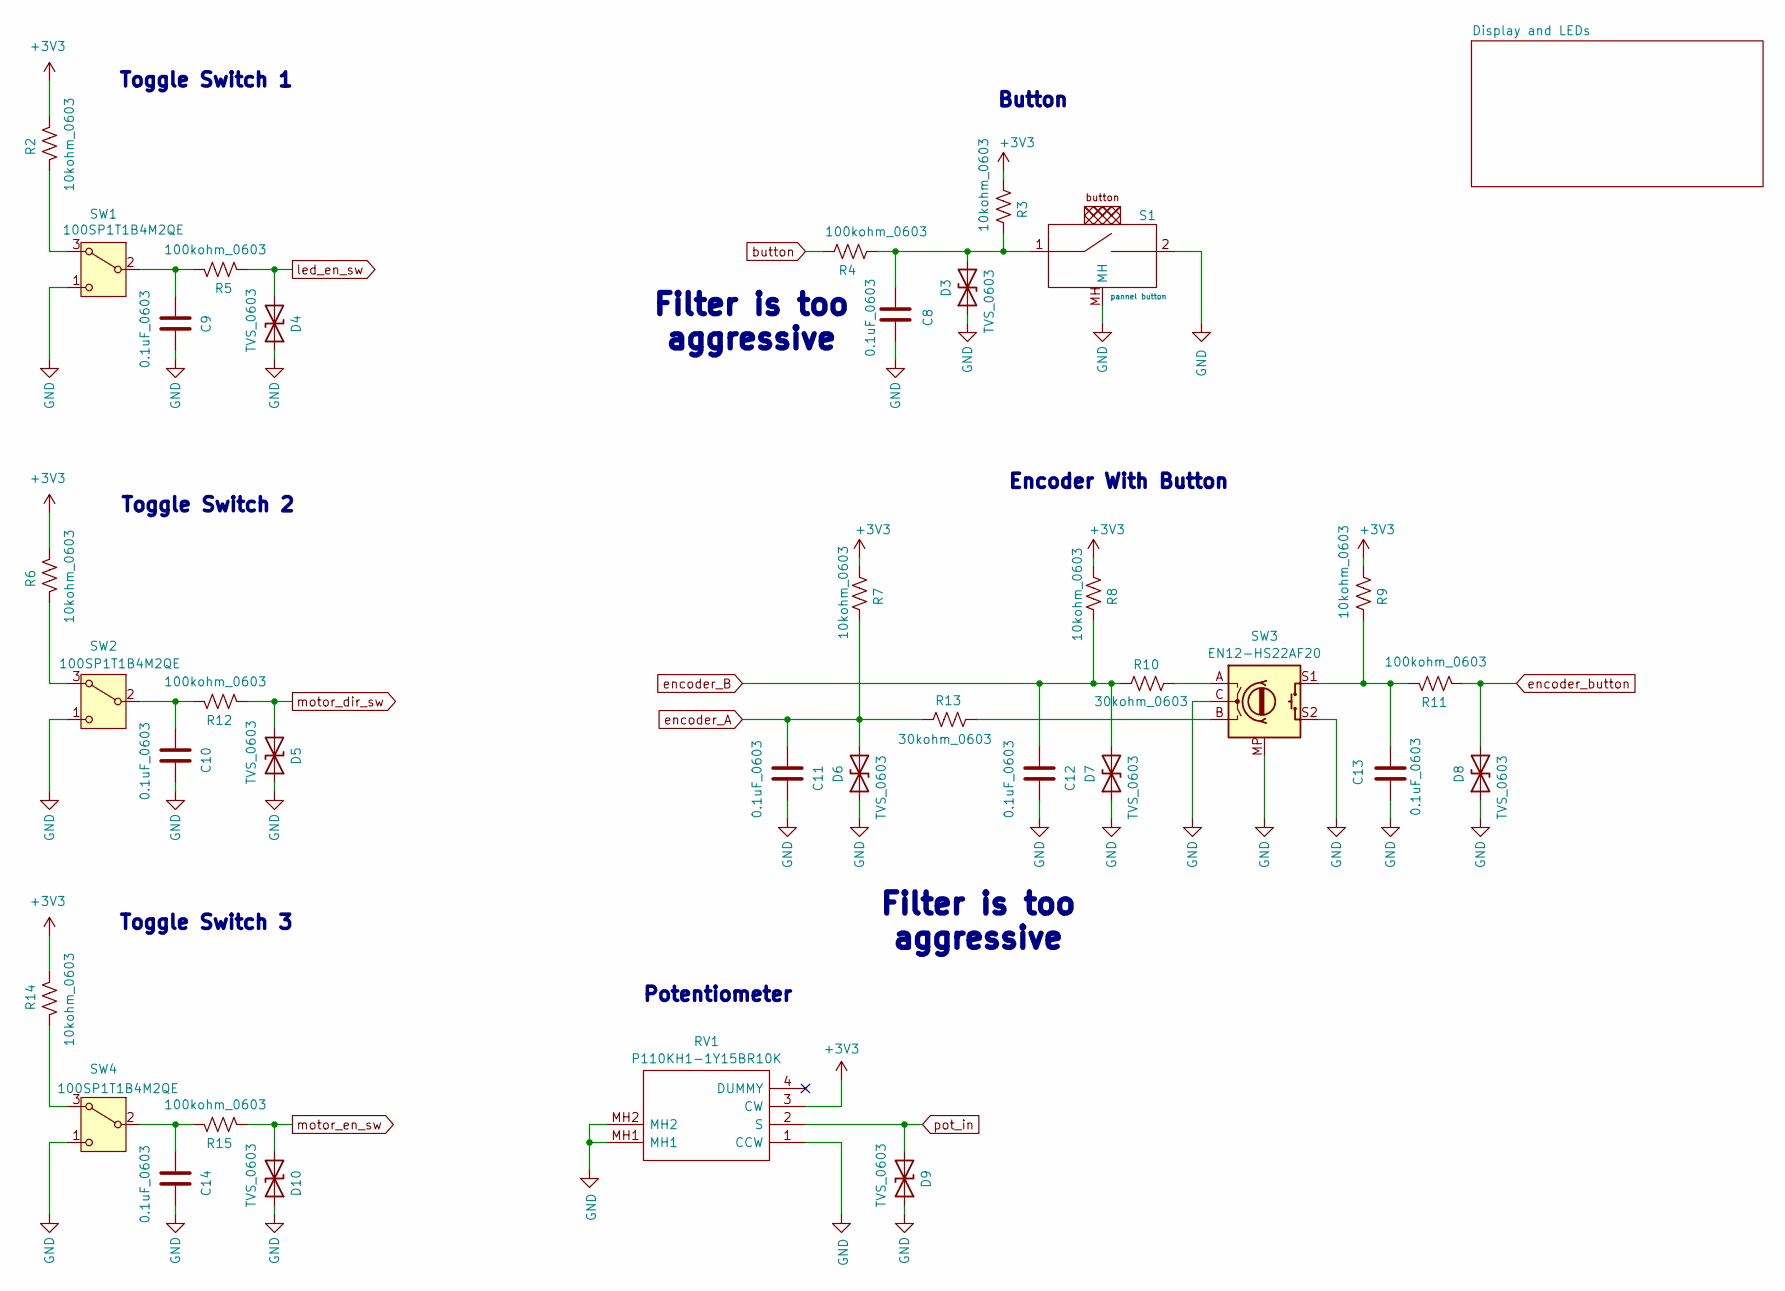
[picture p136: schematic Interface.kicad_sch]

Parts:
C8, C9, C10, C11, C12, C13, C14: 0.1uF_0603; C_0603_1608Metric
D3, D4, D5, D6, D7, D8, D9, D10: TVS_0603; D_0603_1608Metric
R2, R3, R6, R7, R8, R9, R14: 10kohm_0603; R_0603_1608Metric
R4, R5, R11, R12, R15: 100kohm_0603; R_0603_1608Metric
R10, R13: 30kohm_0603; R_0603_1608Metric
RV1: P110KH1-1Y15BR10K; P110KH11Y15BR10K; Mouser Part Number 858-P110KH11Y15BR10K
S1: pannel button; 10mm_pannel_button
SW1, SW2, SW4: 100SP1T1B4M2QE
SW3: EN12-HS22AF20; EN12HS22AF20

Connections:
+3V3: R2.1, R3.1, R6.1, R7.1, R8.1, R9.1, R14.1, RV1.3 (CW); also elsewhere on the board
GND: C8.2, C9.1, C10.1, C11.1, C12.1, C13.2, C14.1, D3.1 (A1), D4.1 (A1), D5.1 (A1), D6.1 (A1), D7.1 (A1), D8.1 (A1), D9.1 (A1), D10.1 (A1), RV1.1 (CCW), RV1.MH1, RV1.MH2, S1.2, S1.MH, SW1.1 (C), SW2.1 (C), SW3.C, SW3.MP, SW3.S2, SW4.1 (C); also elsewhere on the board
unnamed: C13.1, R9.2, R11.1, SW3.S1
unnamed: C8.1, D3.2 (A2), R3.2, R4.1, S1.1
unnamed: R10.2, SW3.A
unnamed: R13.2, SW3.B
unnamed: R2.2, SW1.3 (A)
unnamed: C9.2, R5.1, SW1.2 (B)
unnamed: R6.2, SW2.3 (A)
unnamed: C10.2, R12.1, SW2.2 (B)
unnamed: R14.2, SW4.3 (A)
unnamed: C14.2, R15.1, SW4.2 (B)
button: R4.2; also elsewhere on the board
encoder_A: C11.2, D6.2 (A2), R7.2, R13.1; also elsewhere on the board
encoder_B: C12.2, D7.2 (A2), R8.2, R10.1; also elsewhere on the board
encoder_button: D8.2 (A2), R11.2; also elsewhere on the board
led_en_sw: D4.2 (A2), R5.2; also elsewhere on the board
motor_dir_sw: D5.2 (A2), R12.2; also elsewhere on the board
motor_en_sw: D10.2 (A2), R15.2; also elsewhere on the board
pot_in: D9.2 (A2), RV1.2 (S); also elsewhere on the board

Notes on the sheet:
Encoder With Button
Filter is too aggressive
Button
Toggle Switch 1
Potentiometer
Toggle Switch 2
Toggle Switch 3
