TickingClocks/Zoetrope-Carousel-V4/Electrical/Animation Platter_V1/Animation Platter_V1.kicad_pcb

## KiCad design Electrical/Animation Platter_V1/Animation Platter_V1.kicad_pcb (continued)

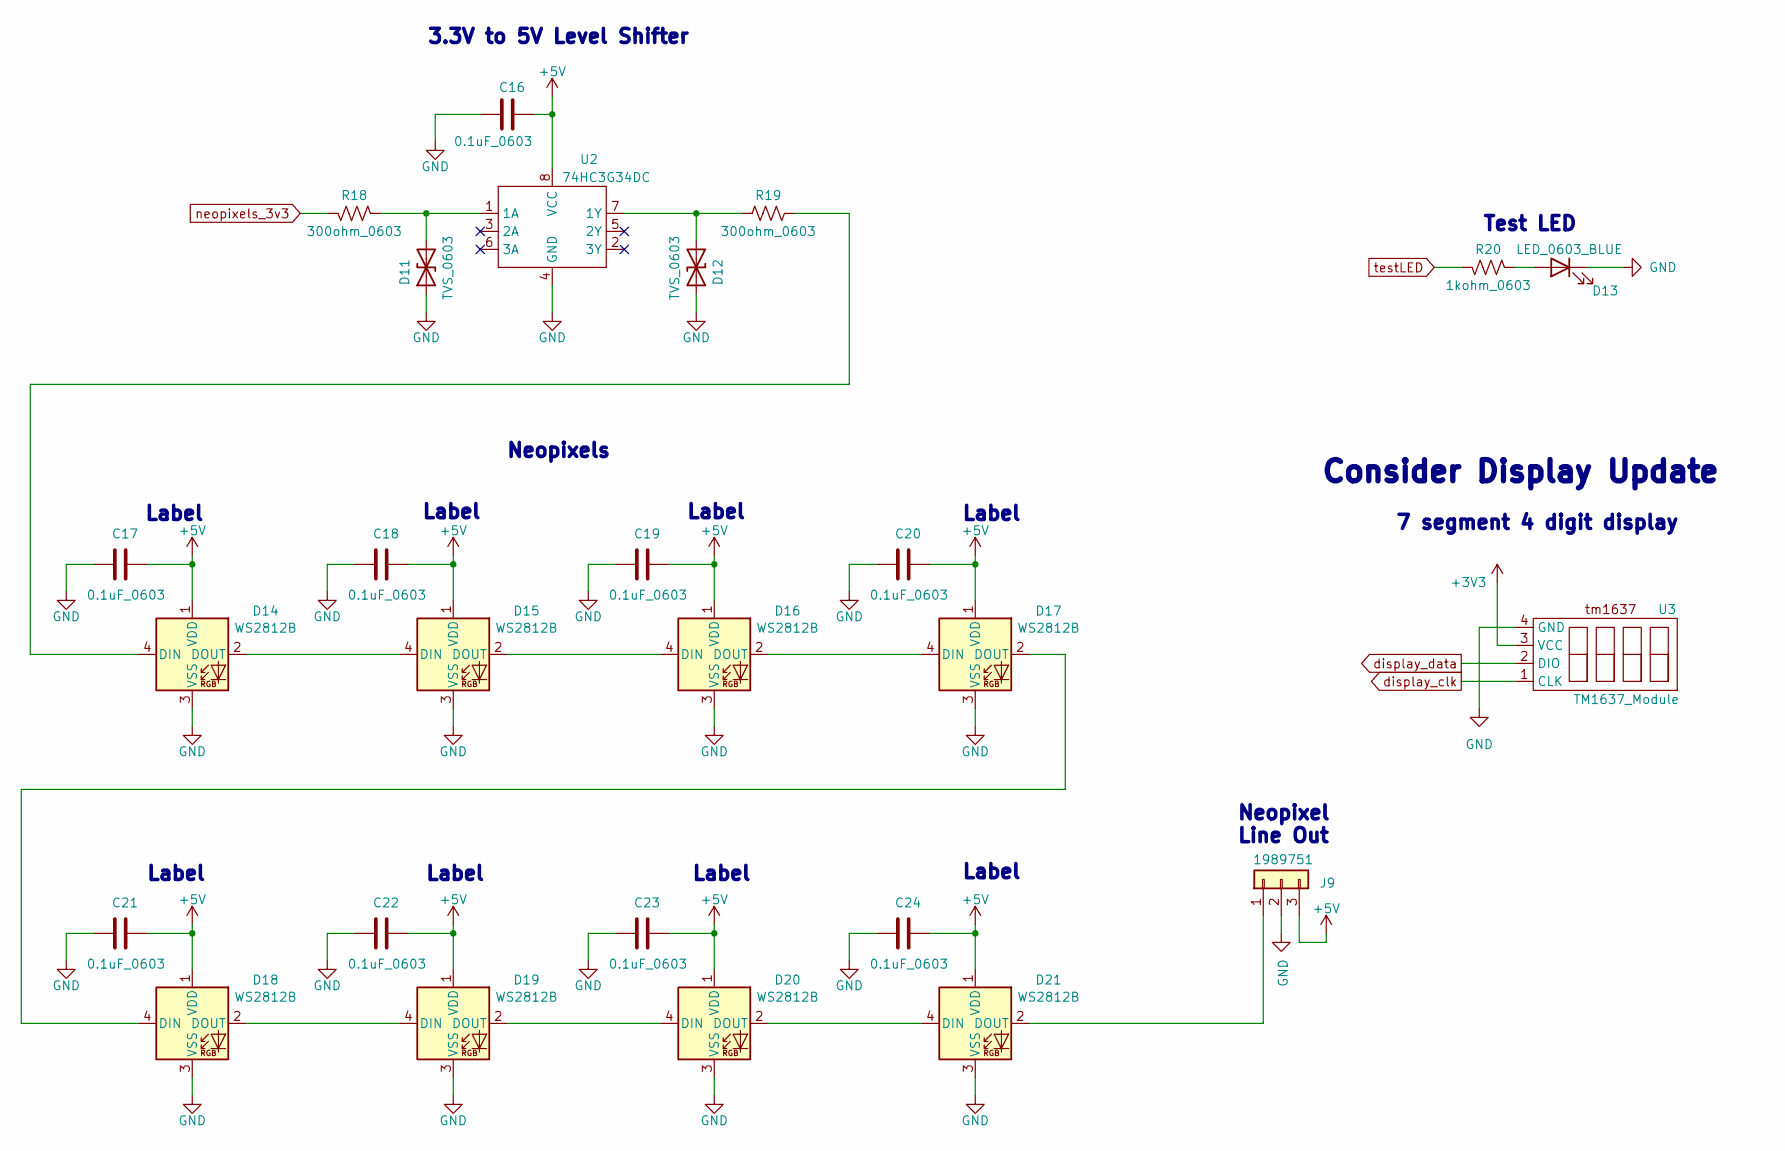
[picture p137: schematic Display and LEDs.kicad_sch]

Parts:
C16, C17, C18, C19, C20, C21, C22, C23, C24: 0.1uF_0603; C_0603_1608Metric
D11, D12: TVS_0603; R_0603_1608Metric
D13: LED_0603_BLUE; LED_0603_1608Metric
D14, D15, D16, D17, D18, D19, D20, D21: WS2812B; LED_WS2812B_PLCC4_5.0x5.0mm_P3.2mm
J9: 1989751
R18, R19: 300ohm_0603; R_0603_1608Metric
R20: 1kohm_0603; R_0603_1608Metric
U2: 74HC3G34DC; 75HC3G34DC
U3: TM1637_Module; TM1637_module

Connections:
+3V3: U3.3 (VCC); also elsewhere on the board
+5V: C16.1, C17.1, C18.1, C19.1, C20.1, C21.1, C22.1, C23.1, C24.1, D14.1 (VDD), D15.1 (VDD), D16.1 (VDD), D17.1 (VDD), D18.1 (VDD), D19.1 (VDD), D20.1 (VDD), D21.1 (VDD), J9.3, U2.8 (VCC); also elsewhere on the board
GND: C16.2, C17.2, C18.2, C19.2, C20.2, C21.2, C22.2, C23.2, C24.2, D11.1 (A1), D12.1 (A1), D13.1 (K), D14.3 (VSS), D15.3 (VSS), D16.3 (VSS), D17.3 (VSS), D18.3 (VSS), D19.3 (VSS), D20.3 (VSS), D21.3 (VSS), J9.2, U2.4 (GND), U3.4 (GND); also elsewhere on the board
unnamed: D11.2 (A2), R18.1, U2.1 (1A)
unnamed: D12.2 (A2), R19.2, U2.7 (1Y)
unnamed: D13.2 (A), R20.1
unnamed: D14.4 (DIN), R19.1
unnamed: D14.2 (DOUT), D15.4 (DIN)
unnamed: D15.2 (DOUT), D16.4 (DIN)
unnamed: D16.2 (DOUT), D17.4 (DIN)
unnamed: D17.2 (DOUT), D18.4 (DIN)
unnamed: D18.2 (DOUT), D19.4 (DIN)
unnamed: D19.2 (DOUT), D20.4 (DIN)
unnamed: D20.2 (DOUT), D21.4 (DIN)
unnamed: D21.2 (DOUT), J9.1
display_clk: U3.1 (CLK); also elsewhere on the board
display_data: U3.2 (DIO); also elsewhere on the board
neopixels_3v3: R18.2; also elsewhere on the board
testLED: R20.2; also elsewhere on the board

Notes on the sheet:
Label
Neopixel Line Out
7 segment 4 digit display
Consider Display Update
Neopixels
Test LED
3.3V to 5V Level Shifter

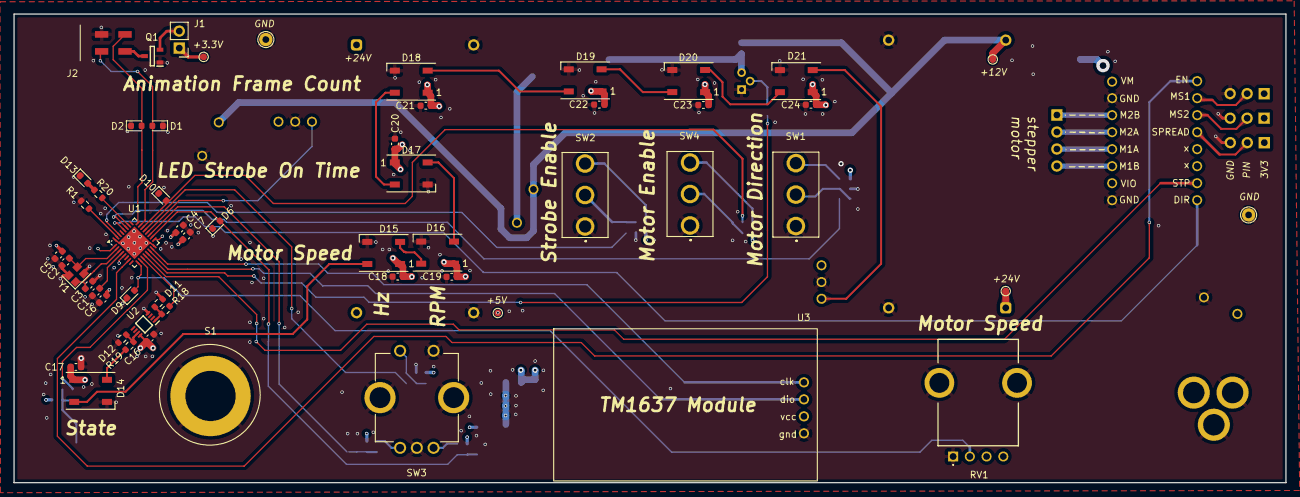
[picture p138: board Animation Platter_V1.kicad_pcb from above]

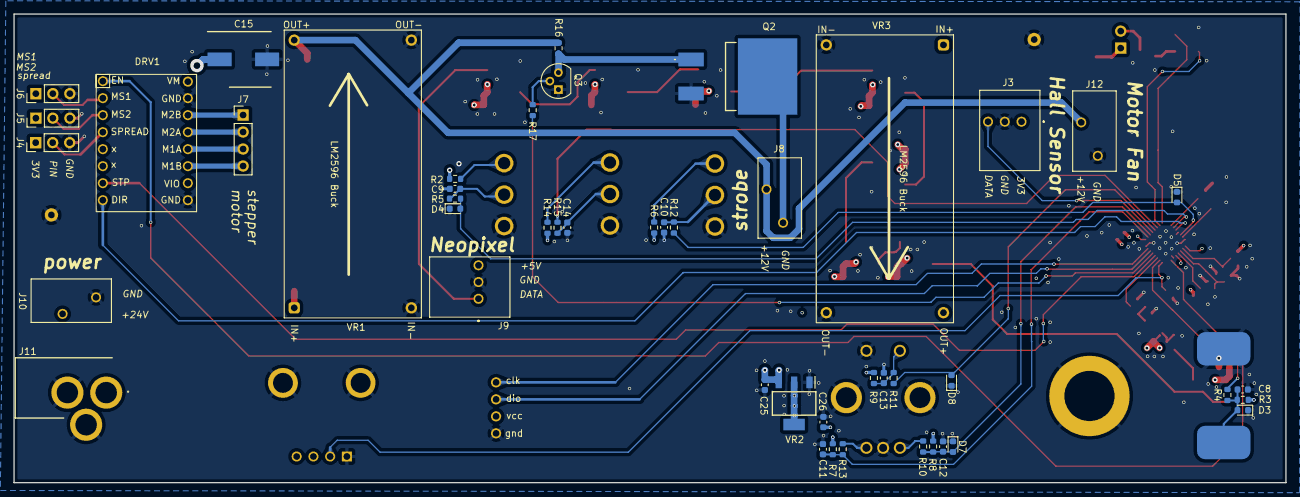
[picture p139: board Animation Platter_V1.kicad_pcb from below]

Board: 4 copper layers, 190.0 x 70.0 mm, 102 parts (47 on the bottom side), 62 nets.
