TickingClocks/Zoetrope-Carousel-V4/Electrical/01a_V4 - Saber - Spot Light/Saber Connector Board/Saber Connector Board_V1/Saber Connector Board_V1.kicad_pcb

## KiCad design Electrical/01a_V4 - Saber - Spot Light/Saber Connector Board/Saber Connector Board_V1/Saber Connector Board_V1.kicad_pcb (2026-05-01)

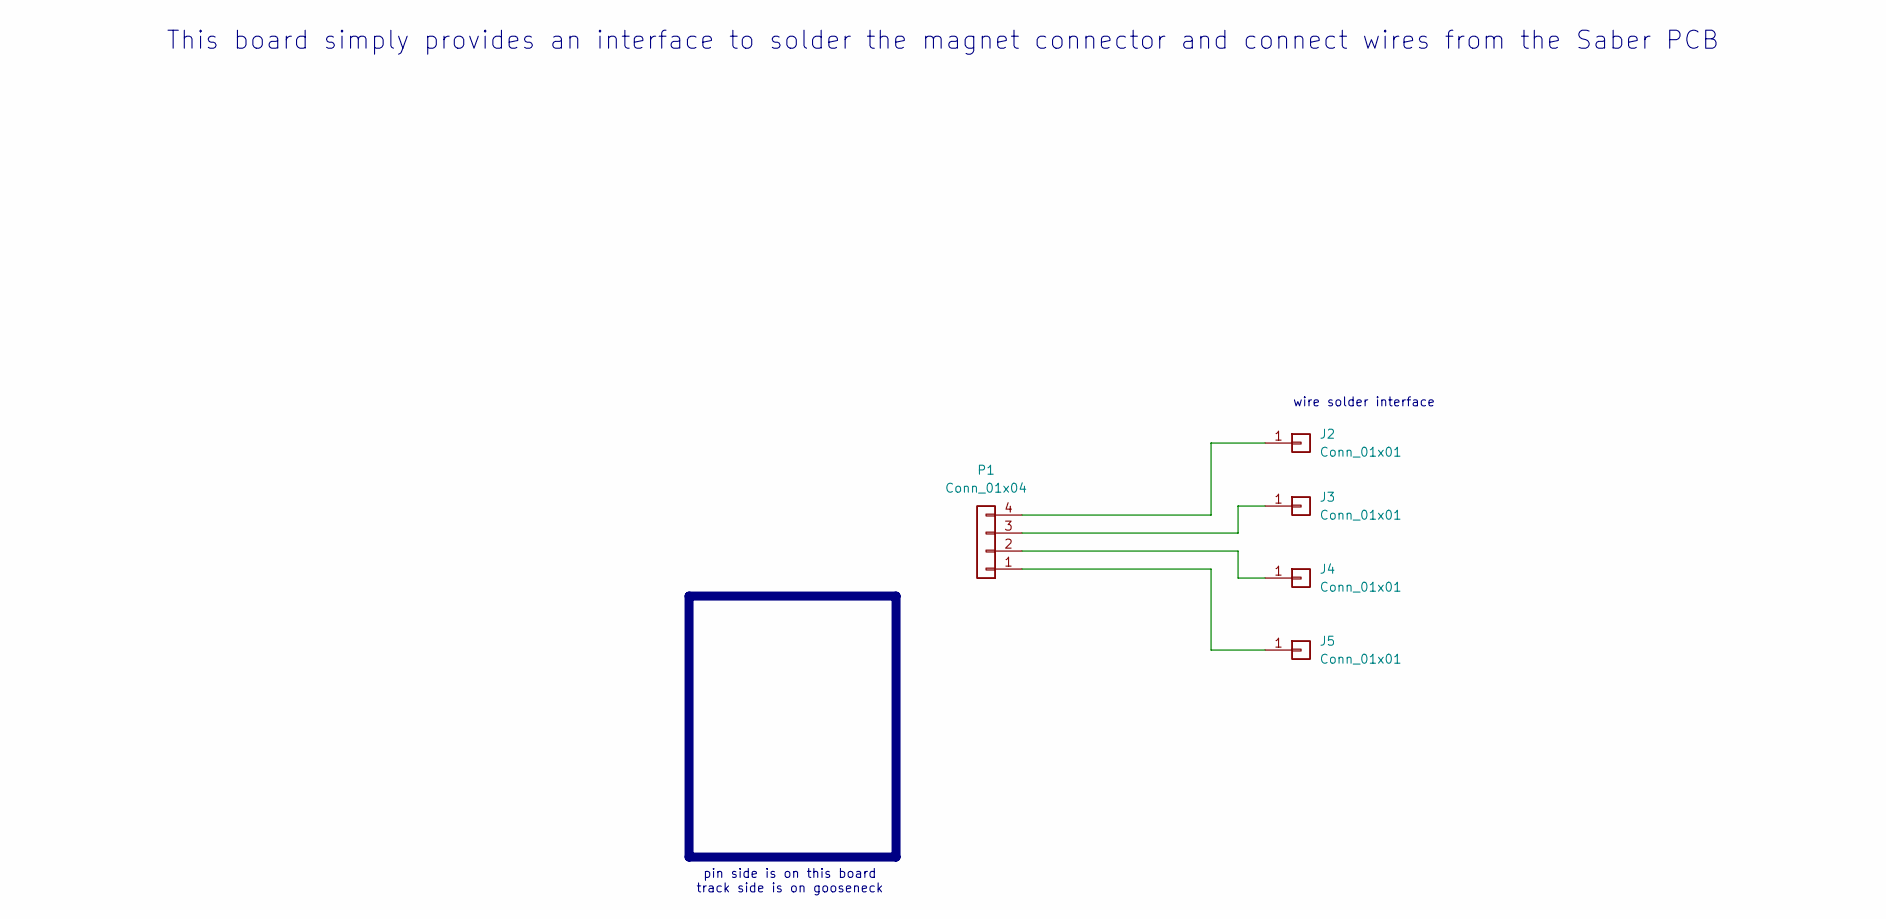
[picture p140: schematic Saber Connector Board_V1.kicad_sch]

Parts:
J2, J3, J4, J5: Conn_01x01; PinHeader_1x01_P2.54mm_Vertical
P1: Conn_01x04; Untitled

Connections:
unnamed: J2.1, P1.4
unnamed: J3.1, P1.3
unnamed: J4.1, P1.2
unnamed: J5.1, P1.1

Notes on the sheet:
pin side is on this board track side is on gooseneck
wire solder interface
This board simply provides an interface to solder the magnet connector and connect wires from the Saber PCB

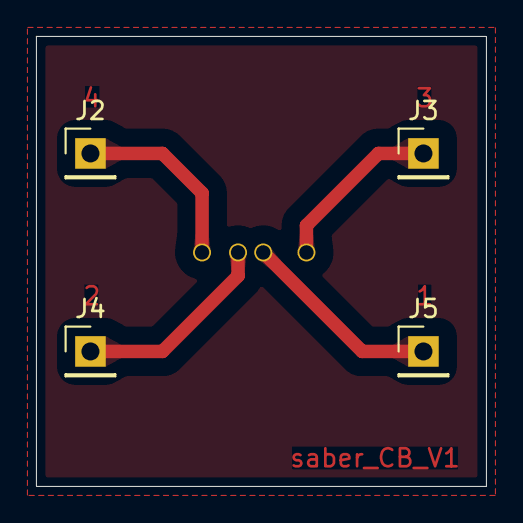
[picture p141: board Saber Connector Board_V1.kicad_pcb from above]

Board: 2 copper layers, 25.0 x 25.0 mm, 5 parts (1 on the bottom side), 4 nets.
