TickingClocks/Zoetrope-Carousel-V4/Electrical/01b_V4 - Photoeye PCB/V1/00_Electrical/Photoeye PCB_V1/Photoeye PCB_V1.kicad_pcb

## KiCad design Electrical/01b_V4 - Photoeye PCB/V1/00_Electrical/Photoeye PCB_V1/Photoeye PCB_V1.kicad_pcb (2026-05-01)

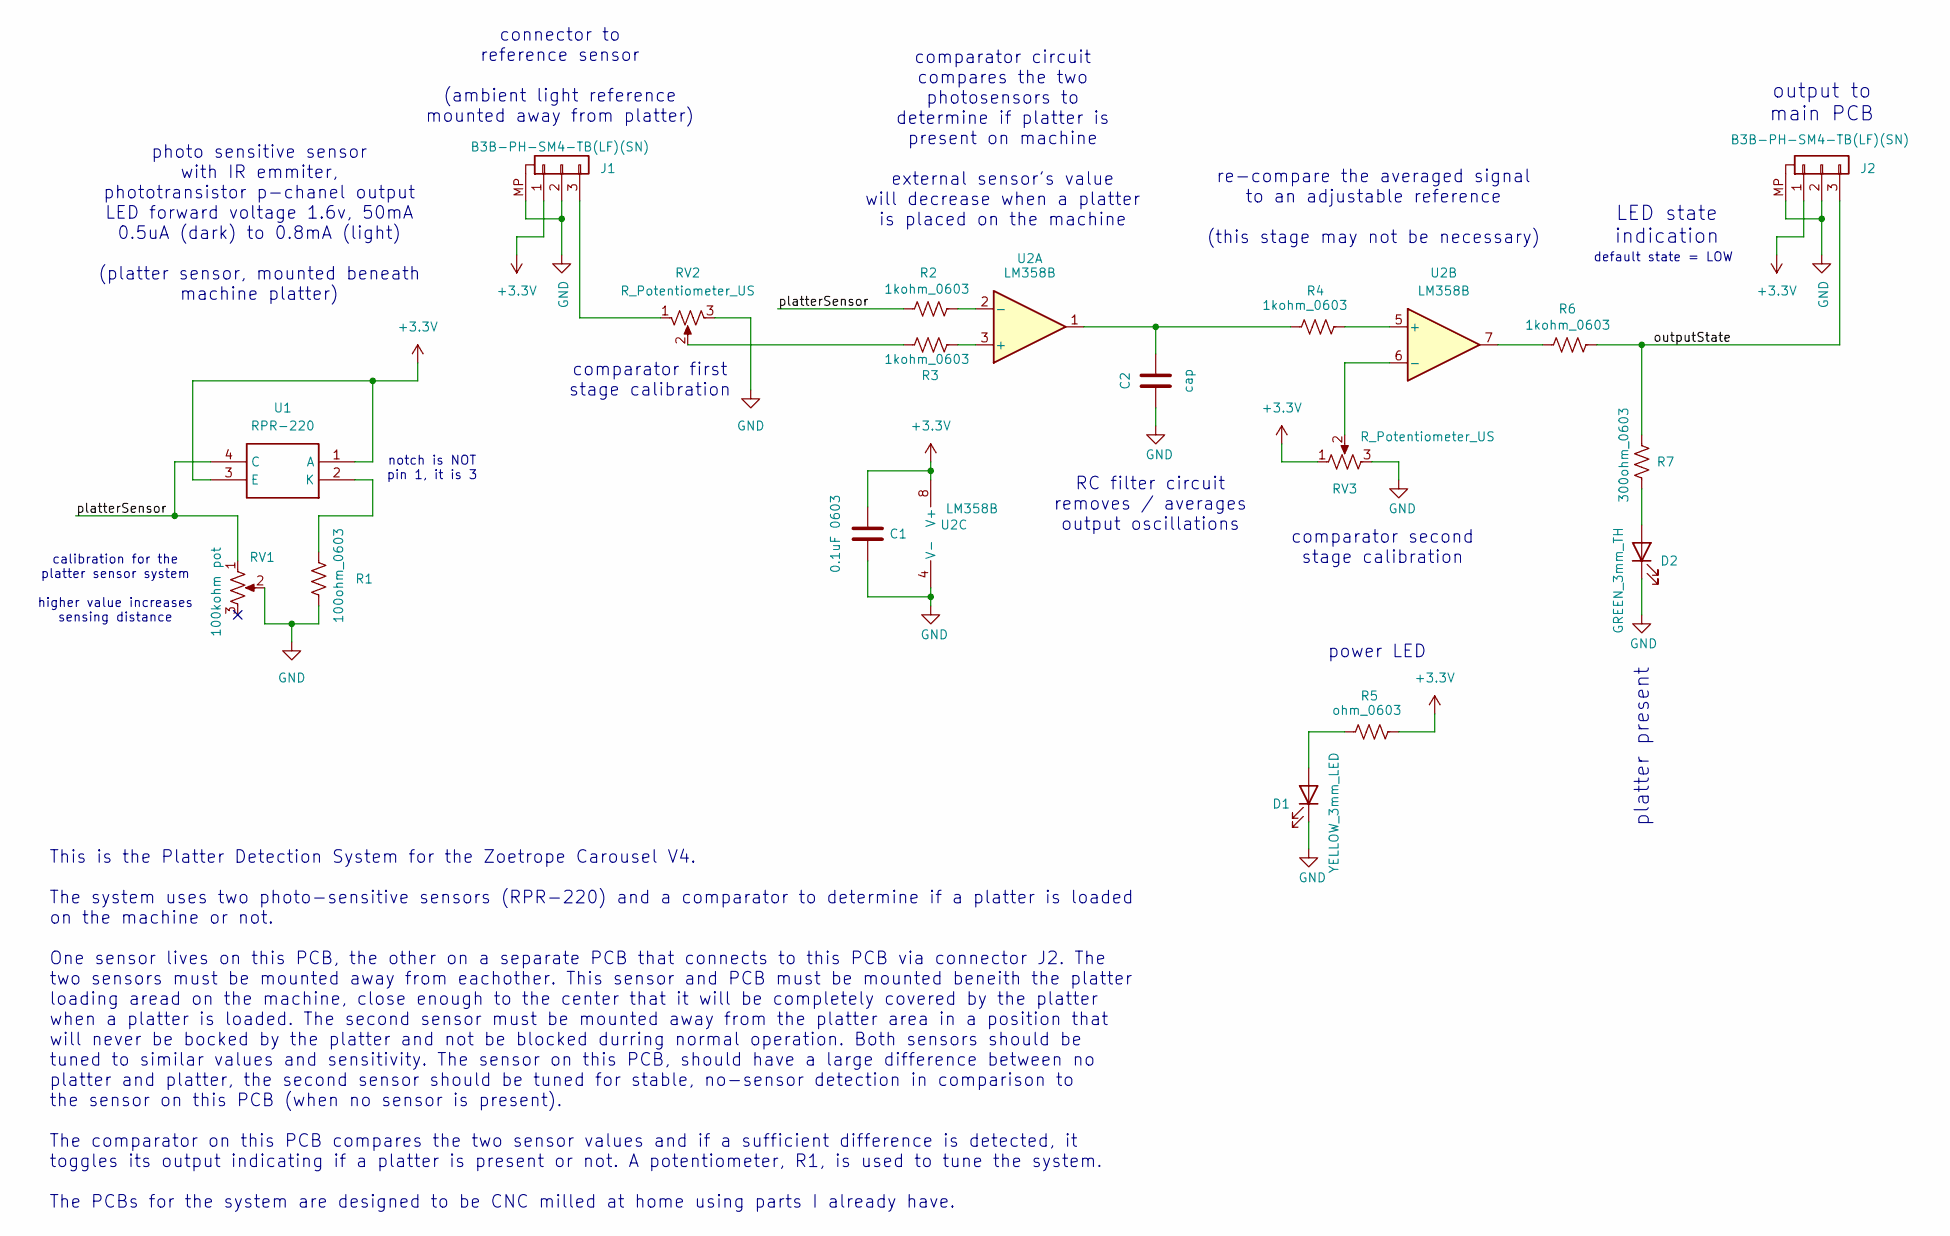
[picture p142: schematic Photoeye PCB_V1.kicad_sch]

Parts:
C1: 0.1uF 0603; C_0603_1608Metric
C2: cap; C_0603_1608Metric
D1: YELLOW_3mm_LED; LED_D3.0mm_Clear
D2: GREEN_3mm_TH; LED_D3.0mm
J1, J2: B3B-PH-SM4-TB(LF)(SN); JST_PH_B3B-PH-SM4-TB_1x03-1MP_P2.00mm_Vertical
R1: 100ohm_0603; R_0603_1608Metric
R2, R3, R4, R6: 1kohm_0603; R_0603_1608Metric
R5: ohm_0603; R_0603_1608Metric
R7: 300ohm_0603; R_0603_1608Metric
RV1: 100kohm pot; Potentiometer_Bourns_3296W_Vertical
RV2, RV3: R_Potentiometer_US; Potentiometer_Bourns_3296W_Vertical
U1: RPR-220; RPR220; Mouser Part Number 755-RPR-220
U2: LM358B; SOT-23-8

Connections:
+3.3V: C1.1, J1.1, J2.1, R5.1, RV3.1, U1.1 (A), U1.3 (E), U2.8 (V+)
/outputState: J2.3, R6.1, R7.2
/platterSensor: R2.2, RV1.1, U1.4 (C)
GND: C1.2, C2.1, D1.1 (K), D2.1 (K), J1.2, J1.MP (Pin_1), J2.2, J2.MP (Pin_1), R1.1, RV1.2, RV2.3, RV3.3, U2.4 (V-)
unnamed: C2.2, R4.2, U2.1
unnamed: D1.2 (A), R5.2
unnamed: D2.2 (A), R7.1
unnamed: J1.3, RV2.1
unnamed: R3.2, RV2.2
unnamed: R6.2, U2.7
unnamed: R1.2, U1.2 (K)
unnamed: R3.1, U2.3 (+)
unnamed: R2.1, U2.2 (-)
unnamed: R4.1, U2.5 (+)
unnamed: RV3.2, U2.6 (-)

Notes on the sheet:
comparator first stage calibration
connector to reference sensor (ambient light reference mounted away from platter)
default state = LOW
power LED
output to main PCB
photo sensitive sensor with IR emmiter, phototransistor p-chanel output LED forward voltage 1.6v, 50mA 0.5uA (dark) to 0.8mA (light) (platter sensor, mounted beneath machine platter)
RC filter circuit removes / averages output oscillations
re-compare the averaged signal to an adjustable reference (this stage may not be necessary)
calibration for the platter sensor system higher value increases sensing distance
LED state indication
platter present
comparator circuit compares the two photosensors to determine if platter is present on machine external sensor's value will decrease when a platter is placed on the machine
comparator second stage calibration
notch is NOT pin 1, it is 3
This is the Platter Detection System for the Zoetrope Carousel V4. The system uses two photo-sensitive sensors (RPR-220) and a comparator to determine if a platter is loaded on the machine or not. One sensor lives on this PCB, the other on a separate PCB that connects to this PCB via connector J2. 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

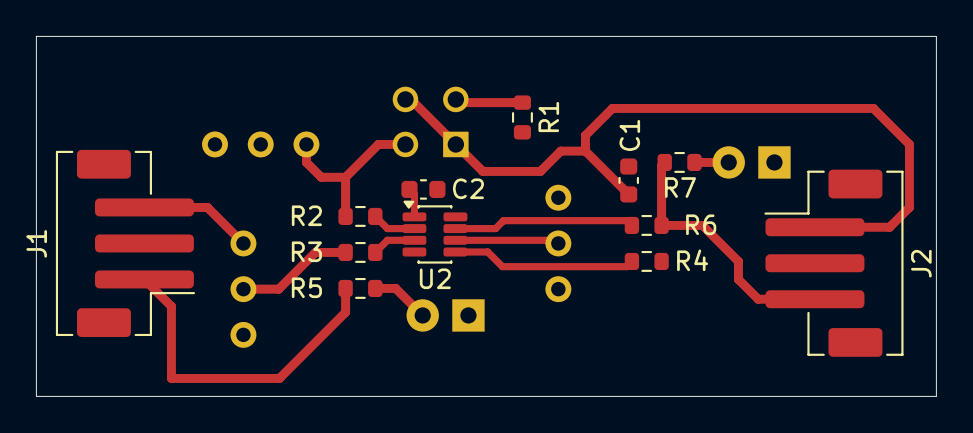
[picture p143: board Photoeye PCB_V1.kicad_pcb from above]

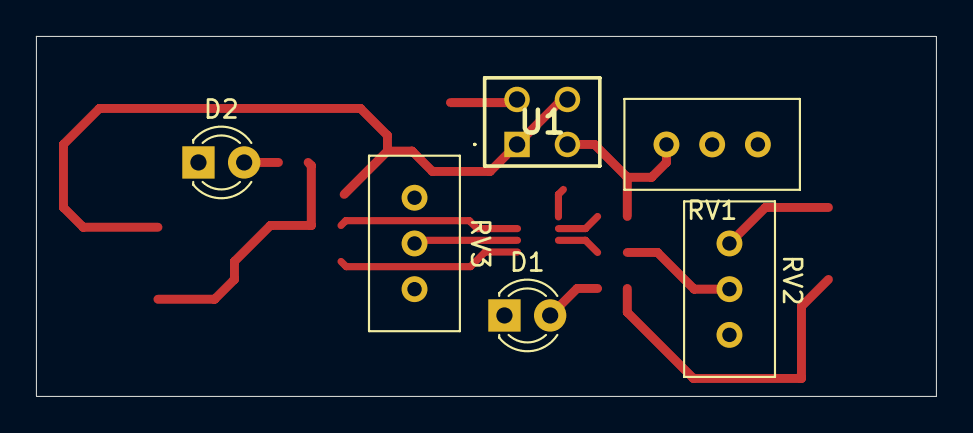
[picture p144: board Photoeye PCB_V1.kicad_pcb from below]

Board: 2 copper layers, 50.0 x 20.0 mm, 18 parts (6 on the bottom side), 15 nets.
