TickingClocks/Zoetrope-Carousel-V4/Electrical/01a_V4 - External Power Switch PCB/V1/00_Electrical Design/External Power Switch_V1/Zoetrope Carusel V4 - External Power Switch_V1.kicad_pcb

## KiCad design Electrical/01a_V4 - External Power Switch PCB/V1/00_Electrical Design/External Power Switch_V1/Zoetrope Carusel V4 - External Power Switch_V1.kicad_pcb (2026-05-01, an earlier design)

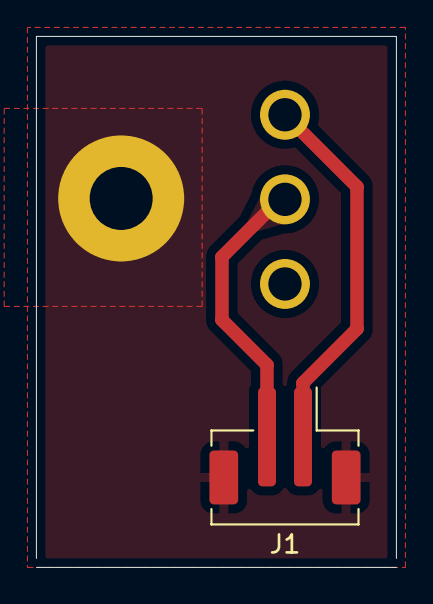
[picture p145: board Zoetrope Carusel V4 - External Power Switch_V1.kicad_pcb from above]

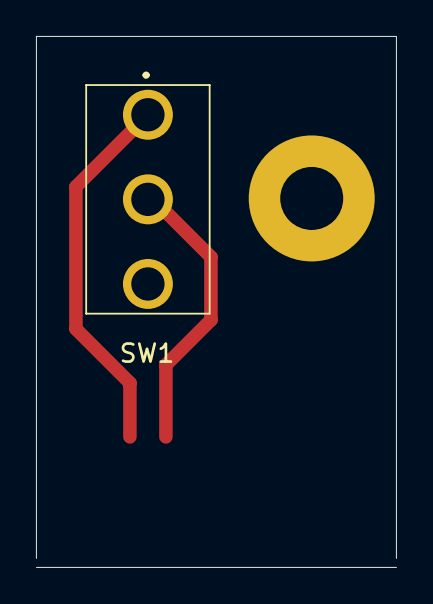
[picture p146: board Zoetrope Carusel V4 - External Power Switch_V1.kicad_pcb from below]

Board: 2 copper layers, 20.0 x 29.5 mm, 3 parts (2 on the bottom side), 3 nets.

Parts:
H2: MountingHole_Pad; 3mm_MH
J1: B2B-PH-SM4-TB(LF)(SN); JST_PH_B2B-PH-SM4-TB_1x02-1MP_P2.00mm_Vertical
SW1: 100SP1T1B4M2QE

Connections:
unnamed: J1.2, SW1.2 (B)
unnamed: J1.1, SW1.1 (C)
float: H2.1, J1.MP (Pin_1)
