TickingClocks/Zoetrope-Carousel-V4/Firmware/STM32/Powered Platter_V2/PoweredPlatter_V2/Core/Src/main.c

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
/* Includes ------------------------------------------------------------------*/
#include "main.h"


TIM_HandleTypeDef htim2;

/* USER CODE BEGIN PV */
uint32_t currentTime = 0; //generic time keeping variable (used everywhere, changes a lot)


uint32_t heartbeatPulseTime = 100; //for pulse timing
uint32_t heartbeatLastTime = 0; //for time tracking

//strobe signal variables - strobe signal is active LOW
uint8_t strobeState = 0; //current value of the strobe state
uint8_t prevStrobeState = 0; //previous reading of the strobe state
uint32_t strobeSignalLastTime = 0; //for signal timing (reading)
uint32_t strobeSignalPeriodTime = 2000; //period between signal pulses, set to large value to default to idle mode
uint32_t strobeSignalRunningCounter = 0; //running timer so we can jump to idle mode if needed

uint32_t rotationRunningModeCuttoff = 750; //how fast does the platter need to spin to go to running mode
uint8_t mode = 0; //0=idle, 1=running, 2=error

//idle mode variables
uint32_t idleModeLastTime = 0; //for time tracking the idle mode animation
uint32_t idleModeAnimationTime = 100; //animation speed control for idle mode
uint8_t idleModeAnimationIndex = 0; //animation current index for idle mode animation
uint8_t prevIdleModeAnimationIndex = 0; //for tracking when the index changes, to prevent unnecessary display updates
uint8_t idleModeAnimationMaxIndex = 7; //max animation index value before triggering rollover

//display variables
uint16_t display[150][7]; //values for each LED in the array X x Y, indexed bottom left corner
uint16_t frameCount = 150; //one frame for each column in the display
uint16_t blade2FrameOffset = 75; //used for second strip of LEDs
uint16_t frameIndex = 0; //what is the frame currently displayed
uint16_t prevFrameIndex = 0; //for tracking when frame index changes - prevent unnecessary updates
uint8_t frameTurnedOff = 0; //ensure the lights are not on too long - controls motion blur (flag to indicate if the lights have been turned off)
uint32_t frameOnTime = 8; //how long should the LEDs be on for - us
uint32_t frameTime = 0; //indexing time for each frame - rotation time / frames, converted from ms to us
uint32_t frameIndexTime = 0; //for timing reasons - control when to turn the LEDs OFF

//variables for display characters
//capital letters
uint8_t dotDisplay_A[7] = { 0b10001000, //A
                            0b10001000,
                            0b10001000,
                            0b11111000,
                            0b10001000,
                            0b10001000,
                            0b01110000};

uint8_t dotDisplay_B[7] = { 0b11110000, //B
                            0b10001000,
                            0b10001000,
                            0b11110000,
                            0b10001000,
                            0b10001000,
                            0b11110000};

uint8_t dotDisplay_C[7] = { 0b01111000, //C
                            0b10000000,
                            0b10000000,
                            0b10000000,
                            0b10000000,
                            0b10000000,
                            0b01111000};

uint8_t dotDisplay_D[7] = { 0b11110000, //D
                            0b10001000,
                            0b10001000,
                            0b10001000,
                            0b10001000,
                            0b10001000,
                            0b11110000};

uint8_t dotDisplay_E[7] = { 0b11111000, //E
                            0b10000000,
                            0b10000000,
                            0b11110000,
                            0b10000000,
                            0b10000000,
                            0b11111000};

uint8_t dotDisplay_F[7] = { 0b10000000, //F
                            0b10000000,
                            0b10000000,
                            0b11110000,
                            0b10000000,
                            0b10000000,
                            0b11111000};

uint8_t dotDisplay_G[7] = { 0b01111000, //G
                            0b10001000,
                            0b10001000,
                            0b10011000,
                            0b10000000,
                            0b10000000,
                            0b01111000};

uint8_t dotDisplay_H[7] = { 0b10001000, //H
                            0b10001000,
                            0b10001000,
                            0b11111000,
                            0b10001000,
                            0b10001000,
                            0b10001000};

uint8_t dotDisplay_I[7] = { 0b11111000, //I
                            0b00100000,
                            0b00100000,
                            0b00100000,
                            0b00100000,
                            0b00100000,
                            0b11111000};


uint8_t dotDisplay_J[7] = { 0b01110000, //J
                            0b10001000,
                            0b10001000,
                            0b10001000,
                            0b00001000,
                            0b00001000,
                            0b11111000};

uint8_t dotDisplay_K[7] = { 0b10001000, //K
                            0b10010000,
                            0b10100000,
                            0b11000000,
                            0b10100000,
                            0b10010000,
                            0b10001000};

uint8_t dotDisplay_L[7] = { 0b11111000, //L
                            0b10000000,
                            0b10000000,
                            0b10000000,
                            0b10000000,
                            0b10000000,
                            0b10000000};

uint8_t dotDisplay_M[7] = { 0b10001000, //M
                            0b10001000,
                            0b10001000,
                            0b10101000,
                            0b10101000,
                            0b11011000,
                            0b10001000};

uint8_t dotDisplay_N[7] = { 0b10001000, //N
                            0b10001000,
                            0b10011000,
                            0b10101000,
                            0b11001000,
                            0b10001000,
                            0b10001000};

uint8_t dotDisplay_O[7] = { 0b01110000, //O
                            0b10001000,
                            0b10001000,
                            0b10001000,
                            0b10001000,
                            0b10001000,
                            0b01110000};

uint8_t dotDisplay_P[7] = { 0b10000000, //P
                            0b10000000,
                            0b10000000,
                            0b11110000,
                            0b10001000,
                            0b10001000,
                            0b11110000};

uint8_t dotDisplay_Q[7] = { 0b01111000, //Q
                            0b10011000,
                            0b10001000,
                            0b10001000,
                            0b10001000,
                            0b10001000,
                            0b01110000};

uint8_t dotDisplay_R[7] = { 0b10001000, //R
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

uint8_t dotDisplay_p[7] = { 0b10000000, //p
                            0b10000000,
                            0b10000000,
                            0b11110000,
                            0b10001000,
                            0b10001000,
                            0b11110000};

uint8_t dotDisplay_q[7] = { 0b01111000, //q
                            0b10011000,
                            0b10001000,
                            0b10001000,
                            0b10001000,
                            0b10001000,
                            0b01110000};

uint8_t dotDisplay_r[7] = { 0b10001000, //r
                            0b10010000,
                            0b10100000,
                            0b11110000,
                            0b10001000,
                            0b10001000,
                            0b11110000};

uint8_t dotDisplay_s[7] = { 0b11110000, //s
                            0b00001000,
                            0b00001000,
                            0b01110000,
                            0b10000000,
                            0b10000000,
                            0b01111000};

uint8_t dotDisplay_t[7] = { 0b00100000, //t
                            0b00100000,
                            0b00100000,
                            0b00100000,
                            0b00100000,
                            0b00100000,
                            0b11111000};

uint8_t dotDisplay_u[7] = { 0b01110000, //u
                            0b10001000,
                            0b10001000,
                            0b10001000,
                            0b10001000,
                            0b10001000,
                            0b10001000};

uint8_t dotDisplay_v[7] = { 0b00100000, //v
                            0b01010000,
                            0b10001000,
                            0b10001000,
                            0b10001000,
                            0b10001000,
                            0b10001000};

uint8_t dotDisplay_w[7] = { 0b01010000, //w
                            0b10101000,
                            0b10101000,
                            0b10101000,
                            0b10001000,
                            0b10001000,
                            0b10001000};

uint8_t dotDisplay_x[7] = { 0b10001000, //x
                            0b10001000,
                            0b01010000,
                            0b00100000,
                            0b01010000,
                            0b10001000,
                            0b10001000};

uint8_t dotDisplay_y[7] = { 0b00100000, //y
                            0b00100000,
                            0b00100000,
                            0b00100000,
                            0b01010000,
                            0b10001000,
                            0b10001000};

uint8_t dotDisplay_z[7] = { 0b11111000, //z
                            0b10000000,
                            0b01000000,
                            0b00100000,
                            0b00010000,
                            0b00001000,
                            0b11111000};


/* USER CODE END PV */

void SystemClock_Config(void);
static void MX_GPIO_Init(void);
static void MX_TIM2_Init(void);
/* USER CODE BEGIN PFP */
void heartbeat(void); //basic heartbeat LED - also indicates if error
void readStrobe(void); //reads the strobe pin, sees if it has changed, records speed timing and sets mode
void readIR(void); //this sets the RED led to match whatever the output of the IR signal is

void resetBlades(void); //sets all the LEDs on the LED blades to OFF

void displayRuntime(uint8_t modeSelection); //display LEDs output and control (stroboscopic display and idle mode)
void idleMode(void); //LED animation for when the platter is not spinning fast enough for stroboscopic display
void idleModeAnimationControl(uint8_t index); //control of the LEDs in idle mode

void displayControl(void); //controls LEDs to create the display
void displayLEDControl(uint8_t frame); // sets appropriate LEDS ON for the current frame

void clearDisplayArray(void);

void displaySet_HelloWorld(void);

void scrappyTesting(void); //to test things without making a mess
/* USER CODE END PFP */

/**
  * @brief  The application entry point.
  * @retval int
  */
int main(void)
{

  /* MCU Configuration--------------------------------------------------------*/

  /* Reset of all peripherals, Initializes the Flash interface and the Systick. */
  HAL_Init();

  /* Configure the system clock */
  SystemClock_Config();

  /* Initialize all configured peripherals */
  MX_GPIO_Init();
  MX_TIM2_Init();
  /* Infinite loop */
  /* USER CODE BEGIN WHILE */

  //start the animation control timer
  HAL_TIM_Base_Start(&htim2);

  //set all blade LEDs to OFF
  resetBlades();

  //set display to "Hello World"
  displaySet_HelloWorld();
  
  /*
  //turning all the pixels ON
  for(uint8_t k=0; k<frameCount; k++){
    for(uint8_t e=0; e<7; e++){
      display[k][e] = 1;
    }
  }
  */


  while (1)
  {
    heartbeat(); //basic heartbeat LED - also indicates if error
    readStrobe(); //reads the strobe pin, sees if it has changed, records speed timing and sets mode
    readIR(); //this sets the RED led to match whatever the output of the IR signal is
    displayRuntime(mode); //display LEDs output and control (stroboscopic display and idle mode)


    /* USER CODE END WHILE */

    /* USER CODE BEGIN 3 */
  }
  /* USER CODE END 3 */
}

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
/* USER CODE BEGIN 4 */
//basic heartbeat function to indicate the system is alive
void heartbeat(void){
  currentTime = HAL_GetTick();
  if(currentTime > heartbeatLastTime + heartbeatPulseTime){
    heartbeatLastTime = currentTime;
    if(mode == 2){
      //error mode - blink the error LED
      HAL_GPIO_TogglePin(ledRED_GPIO_Port, ledRED_Pin);
      HAL_GPIO_TogglePin(ledGREEN_GPIO_Port, ledGREEN_Pin);
      HAL_GPIO_TogglePin(ledBLUE_GPIO_Port, ledBLUE_Pin);
    }else{
      if(mode == 0){
        //idle mode
        //normal heartbeat LED
        HAL_GPIO_TogglePin(ledRED_GPIO_Port, ledRED_Pin);
      }else{
        if(mode == 1){
          //running mode
          HAL_GPIO_TogglePin(ledGREEN_GPIO_Port, ledGREEN_Pin); //blink green LED to ensure we are in the right mode
        }
      }
    }
  }
}

//reads the strobe signal and tracks timing between signal pulses
void readStrobe(void){

  //temp test with the LED
  HAL_GPIO_WritePin(ledBLUE_GPIO_Port, ledBLUE_Pin, !HAL_GPIO_ReadPin(strobe_GPIO_Port, strobe_Pin));

  currentTime = HAL_GetTick(); //note the time

  strobeState = HAL_GPIO_ReadPin(strobe_GPIO_Port, strobe_Pin);
  if((strobeState != prevStrobeState) && (strobeState == 0)){
    //new pulse, strobe state is different than last time and it is also LOW
    TIM2->CNT = 0; //reset the timer used for animation (us timer)
    strobeSignalPeriodTime = currentTime - strobeSignalLastTime;
    strobeSignalLastTime = currentTime;
    strobeSignalRunningCounter = 0;
    frameTime = (strobeSignalPeriodTime * 1000) / frameCount; //frame time converted into us
    frameIndex = 0; //starting at frame 0, first column of the display

    if(strobeSignalPeriodTime < rotationRunningModeCuttoff){
      //rotating fast enough to turn on display
      mode = 1; //running mode
    }else{
      //not spinning fast enough - go to idle mode
      mode = 0; //idle mode
    }
  }else{
    //increment the frame index as necessary based on speed and frame time calculations
    if(mode == 1){
      //keep track of what index we are on
      currentTime = TIM2->CNT;
      if(currentTime > frameTime){
        frameIndex = currentTime / frameTime;
        frameIndexTime = TIM2->CNT; //note when we turn the LEDs ON, so we turn them OFF at the right time
      }else{
        frameIndex = 0;
      }
    }
  }
  prevStrobeState = strobeState; //update the prev state flag now that we have used its value

  //set a catch here for a running counter of the strobe signal so we can jump to idle if platter slows
  currentTime = HAL_GetTick();
  strobeSignalRunningCounter = currentTime - strobeSignalLastTime; //timer tracking how long since last pulse
  if(strobeSignalRunningCounter > rotationRunningModeCuttoff){
    //too long since seeing a strobe pulse - turn off the display and return to IDLE
    mode = 0; //idle mode
  }

}

void readIR(void){
  //really fast testing here to see how this works
  //mirror IR signl to the RED LED
  HAL_GPIO_WritePin(ledBLUE_GPIO_Port, ledBLUE_Pin, !HAL_GPIO_ReadPin(IR_input_GPIO_Port, IR_input_Pin));
}

//display LEDs output and control (stroboscopic display and idle mode)
void displayRuntime(uint8_t modeSelection){

  //we pass in the global variable because its easier to tell what is happening from main loop
  switch(modeSelection){
    case 0: //idle mode
      idleMode();
    break;
    case 1: //spinning, stroboscopic display mode
      //so something
      //resetBlades(); //turn off LEDs - for now
      displayControl(); //control LEDs for the display
    break;
    case 2: //error mode
      //do something
      resetBlades(); //turn off LEDs - for now
    break;
  }
}

void displayControl(void){
  //this will control the LEDs for the display
  if(frameIndex != prevFrameIndex){
    prevFrameIndex = frameIndex;
    //top of new frame
    frameTurnedOff = 0; //about to turn the LEDs ON, they have not yet been turned OFF

    //turn on the correct LEDs for this frame
    displayLEDControl(frameIndex);

  }else{
    //still the same frame as last time
    if(!frameTurnedOff){
      //the LEDs are still ON, check for when to turn them OFF
      currentTime = TIM2->CNT;
      if(currentTime > frameIndexTime + frameOnTime){
        //time to turn the LEDs OFF
        frameTurnedOff = 1; //set LEDs OFF flag
        resetBlades(); //turn OFF the display LEDs
      }
    }
  }
}

void displayLEDControl(uint8_t frame){

  uint16_t blade2Frame = 0;

  if(frame >= blade2FrameOffset){ //this is setting the second strip of LEDs - need to handle rollover
    //handle rollover
    blade2Frame = (frame + blade2FrameOffset) - frameCount;
  }else{
    //simple offset
    blade2Frame = frame + blade2FrameOffset;
  }

  //we set the LEDs that need to be on for the current frame - there is one frame for each column of the display
  
  if(frame < frameCount){
    
    //blade 1
    HAL_GPIO_WritePin(led1_GPIO_Port, led1_Pin, display[frame][0]); //led 1, bottom row
    HAL_GPIO_WritePin(led2_GPIO_Port, led2_Pin, display[frame][1]); //led 2
    HAL_GPIO_WritePin(led3_GPIO_Port, led3_Pin, display[frame][2]); //led 3
    HAL_GPIO_WritePin(led4_GPIO_Port, led4_Pin, display[frame][3]); //led 4
    HAL_GPIO_WritePin(led5_GPIO_Port, led5_Pin, display[frame][4]); //led 5
    HAL_GPIO_WritePin(led6_GPIO_Port, led6_Pin, display[frame][5]); //led 6
    HAL_GPIO_WritePin(led7_GPIO_Port, led7_Pin, display[frame][6]); //led 7

  }
  
  if(blade2Frame < frameCount){

    //blade 2 - 180 offset from blade 1, offset on display by 1/2 of display - 75 pixels. Need to also handle wrap around
    HAL_GPIO_WritePin(led14_GPIO_Port, led14_Pin, display[blade2Frame][0]); //led 14, bottom row, 180 out from blade 1, 75 pixels offset from blade 1
    HAL_GPIO_WritePin( led13_GPIO_Port, led13_Pin, display[blade2Frame][1]); //led 13
    HAL_GPIO_WritePin( led12_GPIO_Port, led12_Pin, display[blade2Frame][2]); //led 12
    HAL_GPIO_WritePin( led11_GPIO_Port, led11_Pin, display[blade2Frame][3]); //led 11
    HAL_GPIO_WritePin( led10_GPIO_Port, led10_Pin, display[blade2Frame][4]); //led 10
    HAL_GPIO_WritePin( led9_GPIO_Port, led9_Pin, display[blade2Frame][5]); //led 9
    HAL_GPIO_WritePin( led8_GPIO_Port, led8_Pin, display[blade2Frame][6]); //led 8

  }
    
}

void idleMode(void){

  currentTime = HAL_GetTick();
  if(currentTime > idleModeLastTime + idleModeAnimationTime){
    idleModeLastTime = currentTime;
    
    if(idleModeAnimationIndex > 0){
      idleModeAnimationIndex--;
    }else{
      idleModeAnimationIndex = idleModeAnimationMaxIndex - 1;
    }
    
    if(idleModeAnimationIndex != prevIdleModeAnimationIndex){ //this check is redundant
      idleModeAnimationControl(idleModeAnimationIndex);
    }
    prevIdleModeAnimationIndex = idleModeAnimationIndex; 
    
  }
}

void idleModeAnimationControl(uint8_t index){

  if(index > idleModeAnimationMaxIndex){
    //invalid entry
  }

  //reset the LEDs before setting the LEDs
  resetBlades();


  switch(index){
    case 0:
      //do something
      HAL_GPIO_WritePin(led1_GPIO_Port, led1_Pin, 1); //blade 1
      HAL_GPIO_WritePin(led14_GPIO_Port, led14_Pin, 1); //blade 2
    break;

    case 1:
      //do something
      HAL_GPIO_WritePin(led2_GPIO_Port, led2_Pin, 1); //blade 1
      HAL_GPIO_WritePin(led13_GPIO_Port, led13_Pin, 1); //blade 2
    break;

    case 2:
      //do something
      HAL_GPIO_WritePin(led3_GPIO_Port, led3_Pin, 1); //blade 1
      HAL_GPIO_WritePin(led12_GPIO_Port, led12_Pin, 1); //blade 2
    break;

    case 3:
      //do something
      HAL_GPIO_WritePin(led4_GPIO_Port, led4_Pin, 1); //blade 1
      HAL_GPIO_WritePin(led11_GPIO_Port, led11_Pin, 1); //blade 2
    break;

    case 4:
      //do something
      HAL_GPIO_WritePin(led5_GPIO_Port, led5_Pin, 1); //blade 1
      HAL_GPIO_WritePin(led10_GPIO_Port, led10_Pin, 1); //blade 2
    break;

    case 5:
      //do something
      HAL_GPIO_WritePin(led6_GPIO_Port, led6_Pin, 1); //blade 1
      HAL_GPIO_WritePin(led9_GPIO_Port, led9_Pin, 1); //blade 2
    break;

    case 6:
      //do something
      HAL_GPIO_WritePin(led7_GPIO_Port, led7_Pin, 1); //blade 1
      HAL_GPIO_WritePin(led8_GPIO_Port, led8_Pin, 1); //blade 2
    break;

    case 7:
      //do something
    break;
  }

}

void resetBlades(void){
  //blade 1
  HAL_GPIO_WritePin(led1_GPIO_Port, led1_Pin, 0);
  HAL_GPIO_WritePin(led2_GPIO_Port, led2_Pin, 0);
  HAL_GPIO_WritePin(led3_GPIO_Port, led3_Pin, 0);
  HAL_GPIO_WritePin(led4_GPIO_Port, led4_Pin, 0);
  HAL_GPIO_WritePin(led5_GPIO_Port, led5_Pin, 0);
  HAL_GPIO_WritePin(led6_GPIO_Port, led6_Pin, 0);
  HAL_GPIO_WritePin(led7_GPIO_Port, led7_Pin, 0);

  //blade 2
  HAL_GPIO_WritePin(led8_GPIO_Port, led8_Pin, 0);
  HAL_GPIO_WritePin(led9_GPIO_Port, led9_Pin, 0);
  HAL_GPIO_WritePin(led10_GPIO_Port, led10_Pin, 0);
  HAL_GPIO_WritePin(led11_GPIO_Port, led11_Pin, 0);
  HAL_GPIO_WritePin(led12_GPIO_Port, led12_Pin, 0);
  HAL_GPIO_WritePin(led13_GPIO_Port, led13_Pin, 0);
  HAL_GPIO_WritePin(led14_GPIO_Port, led14_Pin, 0);
}

void displaySet_HelloWorld(void){

  uint8_t startIndex = 10; //where does Hello World start on the display

  //set the display array to say "Hello World"
  //first clear the display
  clearDisplayArray();

  //resetBlades();

  //H
  for(uint8_t k=0; k<7; k++){
    display[startIndex][k] = 1; //turn on one pixel to test the system
  }
  startIndex++;
  display[startIndex][3] = 1;
  startIndex++;
  display[startIndex][3] = 1;
  startIndex++;
  display[startIndex][3] = 1;
  startIndex++;
  for(uint8_t k=0; k<7; k++){
    display[startIndex][k] = 1; //turn on one pixel to test the system
  }
  startIndex+=2; //add extra space after character

  //e
  for(uint8_t k=1; k<4; k++){
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
  HAL_Delay(250);
  HAL_GPIO_TogglePin(led13_GPIO_Port, led13_Pin);
  HAL_Delay(250);
  //led 14 (blade 2 pixel 1)
  HAL_GPIO_TogglePin(led14_GPIO_Port, led14_Pin);
  HAL_Delay(250);
  HAL_GPIO_TogglePin(led14_GPIO_Port, led14_Pin);
  HAL_Delay(250);
}

/* USER CODE END 4 */
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
