TickingClocks/Zoetrope-Carousel-V4/Firmware/STM32/Powered Platter_V2/PoweredPlatter_V2/Core/Inc/main.h

#define IR_input_Pin GPIO_PIN_9
#define IR_input_GPIO_Port GPIOB
#define neopixel_Pin GPIO_PIN_2
#define neopixel_GPIO_Port GPIOA
#define led1_Pin GPIO_PIN_4
#define led1_GPIO_Port GPIOA
#define led2_Pin GPIO_PIN_5
#define led2_GPIO_Port GPIOA
#define led3_Pin GPIO_PIN_6
#define led3_GPIO_Port GPIOA
#define led4_Pin GPIO_PIN_7
#define led4_GPIO_Port GPIOA
#define led5_Pin GPIO_PIN_0
#define led5_GPIO_Port GPIOB
#define led6_Pin GPIO_PIN_1
#define led6_GPIO_Port GPIOB
#define led7_Pin GPIO_PIN_2
#define led7_GPIO_Port GPIOB
#define ledRED_Pin GPIO_PIN_9
#define ledRED_GPIO_Port GPIOA
#define ledBLUE_Pin GPIO_PIN_10
#define ledBLUE_GPIO_Port GPIOA
#define ledGREEN_Pin GPIO_PIN_11
#define ledGREEN_GPIO_Port GPIOA
#define strobe_Pin GPIO_PIN_12
#define strobe_GPIO_Port GPIOA
#define led8_Pin GPIO_PIN_15
#define led8_GPIO_Port GPIOA
#define led9_Pin GPIO_PIN_3
#define led9_GPIO_Port GPIOB
#define led10_Pin GPIO_PIN_4
#define led10_GPIO_Port GPIOB
#define led11_Pin GPIO_PIN_5
#define led11_GPIO_Port GPIOB
#define led12_Pin GPIO_PIN_6
#define led12_GPIO_Port GPIOB
#define led13_Pin GPIO_PIN_7
#define led13_GPIO_Port GPIOB
#define led14_Pin GPIO_PIN_8
#define led14_GPIO_Port GPIOB
