TickingClocks/Zoetrope-Carousel-V4/Firmware/ESP32/1.43 ESP32-S3/reference exmples/Getting Started/FactoryProgram/main/heartbeat.h

#pragma once

#include "driver/gpio.h"

#ifdef __cplusplus
extern "C" {
#endif

/* Change this to your LED pin */
#define HEARTBEAT_GPIO GPIO_NUM_45

/* Public API */
void heartbeat_init(void);
void heartbeat_start(void);
void heartbeat_stop(void);

#ifdef __cplusplus
}
#endif
