TickingClocks/Zoetrope-Carousel-V4/Firmware/ESP32/1.43 ESP32-S3/reference exmples/Getting Started/FactoryProgram/main/example_qspi_with_ram.c

#include <stdio.h>

#include "freertos/FreeRTOS.h"
#include "freertos/task.h"
#include "driver/gpio.h"
#include "driver/i2c.h"
#include "driver/spi_master.h"
#include "esp_timer.h"
#include "esp_lcd_panel_io.h"
#include "esp_lcd_panel_vendor.h"
#include "esp_lcd_panel_ops.h"
#include "esp_err.h"
#include "esp_log.h"

#include "lvgl.h"
#include "lv_demos.h"
#include "esp_lcd_sh8601.h"
#include "touch_bsp.h"
#include "gui_guider.h"
#include "events_init.h"
#include "user_app.h"
#include "read_lcd_id_bsp.h"

#include "ui.h" //squareline ui
#include "heartbeat.h" //heartbeat library

lv_ui guider_ui;
static const char *TAG = "example";
static SemaphoreHandle_t lvgl_mux = NULL;
esp_lcd_panel_io_handle_t BrigPanelHandle;
void setBrightnes(uint8_t brig); 
#define LCD_HOST    SPI2_HOST

#define EXAMPLE_Rotate_90
#define SH8601_ID 0x86
#define CO5300_ID 0xff
static uint8_t READ_LCD_ID = 0x00; 

#if CONFIG_LV_COLOR_DEPTH == 32
#define LCD_BIT_PER_PIXEL       (24)
#elif CONFIG_LV_COLOR_DEPTH == 16
#define LCD_BIT_PER_PIXEL       (16)
#endif

#define EXAMPLE_Rotate_90

#define EXAMPLE_LCD_BK_LIGHT_ON_LEVEL  1
#define EXAMPLE_LCD_BK_LIGHT_OFF_LEVEL !EXAMPLE_LCD_BK_LIGHT_ON_LEVEL
#define EXAMPLE_PIN_NUM_LCD_CS            (GPIO_NUM_9)
#define EXAMPLE_PIN_NUM_LCD_PCLK          (GPIO_NUM_10) 
#define EXAMPLE_PIN_NUM_LCD_DATA0         (GPIO_NUM_11)
#define EXAMPLE_PIN_NUM_LCD_DATA1         (GPIO_NUM_12)
#define EXAMPLE_PIN_NUM_LCD_DATA2         (GPIO_NUM_13)
#define EXAMPLE_PIN_NUM_LCD_DATA3         (GPIO_NUM_14)
#define EXAMPLE_PIN_NUM_LCD_RST           (GPIO_NUM_21)
#define EXAMPLE_PIN_NUM_LCD_PWREN         (GPIO_NUM_42)
#define EXAMPLE_PIN_NUM_BK_LIGHT          (-1)

// The pixel number in horizontal and vertical
#define EXAMPLE_LCD_H_RES              466
#define EXAMPLE_LCD_V_RES              466


#define EXAMPLE_LVGL_BUF_HEIGHT        (EXAMPLE_LCD_V_RES / 4)
#define EXAMPLE_LVGL_TICK_PERIOD_MS    2
#define EXAMPLE_LVGL_TASK_MAX_DELAY_MS 500
#define EXAMPLE_LVGL_TASK_MIN_DELAY_MS 1
#define EXAMPLE_LVGL_TASK_STACK_SIZE   (4 * 1024)
#define EXAMPLE_LVGL_TASK_PRIORITY     2

static const sh8601_lcd_init_cmd_t sh8601_lcd_init_cmds[] = 
{
    {0x11, (uint8_t []){0x00}, 0, 120},
    {0x44, (uint8_t []){0x01, 0xD1}, 2, 0},
    {0x35, (uint8_t []){0x00}, 1, 0},
    {0x53, (uint8_t []){0x20}, 1, 10},
    {0x51, (uint8_t []){0x00}, 1, 10},
    {0x29, (uint8_t []){0x00}, 0, 10},
    {0x51, (uint8_t []){0xFF}, 1, 0},
    //{0x36, (uint8_t []){0x80}, 1, 0},
};
static const sh8601_lcd_init_cmd_t co5300_lcd_init_cmds[] = 
{
    {0x11, (uint8_t []){0x00}, 0, 80},   
    {0xC4, (uint8_t []){0x80}, 1, 0},
    //{0x44, (uint8_t []){0x01, 0xD1}, 2, 0},
    //{0x35, (uint8_t []){0x00}, 1, 0},//TE ON
    {0x53, (uint8_t []){0x20}, 1, 1},
    {0x63, (uint8_t []){0xFF}, 1, 1},
    {0x51, (uint8_t []){0x00}, 1, 1},
    {0x29, (uint8_t []){0x00}, 0, 10},
    {0x51, (uint8_t []){0xFF}, 1, 0},
    //{0x36, (uint8_t []){0x60}, 1, 0},
};

static bool example_notify_lvgl_flush_ready(esp_lcd_panel_io_handle_t panel_io, esp_lcd_panel_io_event_data_t *edata, void *user_ctx)
{
    lv_disp_drv_t *disp_driver = (lv_disp_drv_t *)user_ctx;
    lv_disp_flush_ready(disp_driver);
    return false;
}

static void example_lvgl_flush_cb(lv_disp_drv_t *drv, const lv_area_t *area, lv_color_t *color_map)
{
    esp_lcd_panel_handle_t panel_handle = (esp_lcd_panel_handle_t) drv->user_data;
    const int offsetx1 = (READ_LCD_ID == SH8601_ID) ? area->x1 : area->x1 + 0x06;
    const int offsetx2 = (READ_LCD_ID == SH8601_ID) ? area->x2 : area->x2 + 0x06;
    const int offsety1 = area->y1;
    const int offsety2 = area->y2;

#if LCD_BIT_PER_PIXEL == 24
    uint8_t *to = (uint8_t *)color_map;
    uint8_t temp = 0;
    uint16_t pixel_num = (offsetx2 - offsetx1 + 1) * (offsety2 - offsety1 + 1);

    // Special dealing for first pixel
    temp = color_map[0].ch.blue;
    *to++ = color_map[0].ch.red;
    *to++ = color_map[0].ch.green;
    *to++ = temp;
    // Normal dealing for other pixels
    for (int i = 1; i < pixel_num; i++) {
        *to++ = color_map[i].ch.red;
        *to++ = color_map[i].ch.green;
        *to++ = color_map[i].ch.blue;
    }
#endif

    // copy a buffer's content to a specific area of the display
    esp_lcd_panel_draw_bitmap(panel_handle, offsetx1, offsety1, offsetx2 + 1, offsety2 + 1, color_map);
}

void example_lvgl_rounder_cb(struct _lv_disp_drv_t *disp_drv, lv_area_t *area)
{
    uint16_t x1 = area->x1;
    uint16_t x2 = area->x2;

    uint16_t y1 = area->y1;
    uint16_t y2 = area->y2;

    // round the start of coordinate down to the nearest 2M number
    area->x1 = (x1 >> 1) << 1;
    area->y1 = (y1 >> 1) << 1;
    // round the end of coordinate up to the nearest 2N+1 number
    area->x2 = ((x2 >> 1) << 1) + 1;
    area->y2 = ((y2 >> 1) << 1) + 1;
}

static void example_lvgl_touch_cb(lv_indev_drv_t *drv, lv_indev_data_t *data)
{
    uint16_t tp_x;
    uint16_t tp_y;
    uint8_t win = getTouch(&tp_x,&tp_y);
    if (win)
    {
        data->point.x = tp_x;
        data->point.y = tp_y;
        data->state = LV_INDEV_STATE_PRESSED;
    }
    else 
    {
        data->state = LV_INDEV_STATE_RELEASED;
    }
}

static void example_increase_lvgl_tick(void *arg)
{
    /* Tell LVGL how many milliseconds has elapsed */
    lv_tick_inc(EXAMPLE_LVGL_TICK_PERIOD_MS);
}

static bool example_lvgl_lock(int timeout_ms)
{
    assert(lvgl_mux && "bsp_display_start must be called first");

    const TickType_t timeout_ticks = (timeout_ms == -1) ? portMAX_DELAY : pdMS_TO_TICKS(timeout_ms);
    return xSemaphoreTake(lvgl_mux, timeout_ticks) == pdTRUE;
}

static void example_lvgl_unlock(void)
{
    assert(lvgl_mux && "bsp_display_start must be called first");
    xSemaphoreGive(lvgl_mux);
}

static void example_lvgl_port_task(void *arg)
{
    ESP_LOGI(TAG, "Starting LVGL task");
    uint32_t task_delay_ms = EXAMPLE_LVGL_TASK_MAX_DELAY_MS;
    while (1) {
        // Lock the mutex due to the LVGL APIs are not thread-safe
        if (example_lvgl_lock(-1)) {
            task_delay_ms = lv_timer_handler();
            // Release the mutex
            example_lvgl_unlock();
        }
        if (task_delay_ms > EXAMPLE_LVGL_TASK_MAX_DELAY_MS) {
            task_delay_ms = EXAMPLE_LVGL_TASK_MAX_DELAY_MS;
        } else if (task_delay_ms < EXAMPLE_LVGL_TASK_MIN_DELAY_MS) {
            task_delay_ms = EXAMPLE_LVGL_TASK_MIN_DELAY_MS;
        }
        vTaskDelay(pdMS_TO_TICKS(task_delay_ms));
    }
}

void app_main(void)
{
    READ_LCD_ID = read_lcd_id();
    static lv_disp_draw_buf_t disp_buf; // contains internal graphic buffer(s) called draw buffer(s)
    static lv_disp_drv_t disp_drv;      // contains callback functions

    gpio_config_t gpio_conf = {};
    gpio_conf.intr_type = GPIO_INTR_DISABLE;
    gpio_conf.mode = GPIO_MODE_OUTPUT;
    gpio_conf.pin_bit_mask = (uint64_t)0x01 << EXAMPLE_PIN_NUM_LCD_PWREN;
    gpio_conf.pull_down_en = GPIO_PULLDOWN_DISABLE;
    gpio_conf.pull_up_en = GPIO_PULLUP_ENABLE;

    ESP_ERROR_CHECK_WITHOUT_ABORT(gpio_config(&gpio_conf));
    gpio_set_level(EXAMPLE_PIN_NUM_LCD_PWREN,1);
#if EXAMPLE_PIN_NUM_BK_LIGHT >= 0
    ESP_LOGI(TAG, "Turn off LCD backlight");
    gpio_config_t bk_gpio_config = {
        .mode = GPIO_MODE_OUTPUT,
        .pin_bit_mask = 1ULL << EXAMPLE_PIN_NUM_BK_LIGHT
    };
    ESP_ERROR_CHECK(gpio_config(&bk_gpio_config));
#endif

    ESP_LOGI(TAG, "Initialize SPI bus");
    const spi_bus_config_t buscfg = SH8601_PANEL_BUS_QSPI_CONFIG(EXAMPLE_PIN_NUM_LCD_PCLK,
                                                                 EXAMPLE_PIN_NUM_LCD_DATA0,
                                                                 EXAMPLE_PIN_NUM_LCD_DATA1,
                                                                 EXAMPLE_PIN_NUM_LCD_DATA2,
                                                                 EXAMPLE_PIN_NUM_LCD_DATA3,
                                                                 EXAMPLE_LCD_H_RES * EXAMPLE_LCD_V_RES * LCD_BIT_PER_PIXEL / 8);
    ESP_ERROR_CHECK(spi_bus_initialize(LCD_HOST, &buscfg, SPI_DMA_CH_AUTO));

    ESP_LOGI(TAG, "Install panel IO");
    esp_lcd_panel_io_handle_t io_handle = NULL;
    const esp_lcd_panel_io_spi_config_t io_config = SH8601_PANEL_IO_QSPI_CONFIG(EXAMPLE_PIN_NUM_LCD_CS,
                                                                                example_notify_lvgl_flush_ready,
                                                                                &disp_drv);
    sh8601_vendor_config_t vendor_config = {
        .flags = {
            .use_qspi_interface = 1,
        },
    };
    // Attach the LCD to the SPI bus
    ESP_ERROR_CHECK(esp_lcd_new_panel_io_spi((esp_lcd_spi_bus_handle_t)LCD_HOST, &io_config, &io_handle));
    BrigPanelHandle = io_handle;
    esp_lcd_panel_handle_t panel_handle = NULL;
    const esp_lcd_panel_dev_config_t panel_config = {
        .reset_gpio_num = EXAMPLE_PIN_NUM_LCD_RST,
        .rgb_ele_order = LCD_RGB_ELEMENT_ORDER_RGB,
        .bits_per_pixel = LCD_BIT_PER_PIXEL,
        .vendor_config = &vendor_config,
    };
    vendor_config.init_cmds = (READ_LCD_ID == SH8601_ID) ? sh8601_lcd_init_cmds : co5300_lcd_init_cmds;
    vendor_config.init_cmds_size = (READ_LCD_ID == SH8601_ID) ? sizeof(sh8601_lcd_init_cmds) / sizeof(sh8601_lcd_init_cmds[0]) : sizeof(co5300_lcd_init_cmds) / sizeof(co5300_lcd_init_cmds[0]);
    ESP_LOGI(TAG, "Install SH8601 panel driver");
    ESP_ERROR_CHECK(esp_lcd_new_panel_sh8601(io_handle, &panel_config, &panel_handle));
    ESP_ERROR_CHECK(esp_lcd_panel_reset(panel_handle));
    ESP_ERROR_CHECK(esp_lcd_panel_init(panel_handle));
    // user can flush pre-defined pattern to the screen before we turn on the screen or backlight
    ESP_ERROR_CHECK(esp_lcd_panel_disp_on_off(panel_handle, true));

    Touch_Init(); 

#if EXAMPLE_PIN_NUM_BK_LIGHT >= 0
    ESP_LOGI(TAG, "Turn on LCD backlight");
    gpio_set_level(EXAMPLE_PIN_NUM_BK_LIGHT, EXAMPLE_LCD_BK_LIGHT_ON_LEVEL);
#endif

    ESP_LOGI(TAG, "Initialize LVGL library");
    lv_init();
    // alloc draw buffers used by LVGL
    // it's recommended to choose the size of the draw buffer(s) to be at least 1/10 screen sized
    lv_color_t *buf1 = heap_caps_malloc(EXAMPLE_LCD_H_RES * EXAMPLE_LVGL_BUF_HEIGHT * sizeof(lv_color_t), MALLOC_CAP_DMA);
    assert(buf1);
    //lv_color_t *buf2 = heap_caps_malloc(EXAMPLE_LCD_H_RES * EXAMPLE_LVGL_BUF_HEIGHT * sizeof(lv_color_t), MALLOC_CAP_DMA);
    //assert(buf2);
    // initialize LVGL draw buffers
    lv_disp_draw_buf_init(&disp_buf, buf1, NULL, EXAMPLE_LCD_H_RES * EXAMPLE_LVGL_BUF_HEIGHT);

    ESP_LOGI(TAG, "Register display driver to LVGL");
    lv_disp_drv_init(&disp_drv);
    disp_drv.hor_res = EXAMPLE_LCD_H_RES;
    disp_drv.ver_res = EXAMPLE_LCD_V_RES;
    disp_drv.flush_cb = example_lvgl_flush_cb;
    disp_drv.rounder_cb = example_lvgl_rounder_cb;  
    disp_drv.draw_buf = &disp_buf;
    disp_drv.user_data = panel_handle;
#ifdef EXAMPLE_Rotate_90
    disp_drv.sw_rotate = 1;
    disp_drv.rotated = LV_DISP_ROT_270;
#endif
    lv_disp_t *disp = lv_disp_drv_register(&disp_drv);

    ESP_LOGI(TAG, "Install LVGL tick timer");
    // Tick interface for LVGL (using esp_timer to generate 2ms periodic event)
    const esp_timer_create_args_t lvgl_tick_timer_args = {
        .callback = &example_increase_lvgl_tick,
        .name = "lvgl_tick"
    };
    esp_timer_handle_t lvgl_tick_timer = NULL;
    ESP_ERROR_CHECK(esp_timer_create(&lvgl_tick_timer_args, &lvgl_tick_timer));
    ESP_ERROR_CHECK(esp_timer_start_periodic(lvgl_tick_timer, EXAMPLE_LVGL_TICK_PERIOD_MS * 1000));

    static lv_indev_drv_t indev_drv;    // Input device driver (Touch)
    lv_indev_drv_init(&indev_drv);
    indev_drv.type = LV_INDEV_TYPE_POINTER;
    indev_drv.disp = disp;
    indev_drv.read_cb = example_lvgl_touch_cb;
    lv_indev_drv_register(&indev_drv);


    lvgl_mux = xSemaphoreCreateMutex();
    assert(lvgl_mux);
    xTaskCreate(example_lvgl_port_task, "LVGL", EXAMPLE_LVGL_TASK_STACK_SIZE, NULL, EXAMPLE_LVGL_TASK_PRIORITY, NULL);

    ESP_LOGI(TAG, "Display LVGL demos");
    // Lock the mutex due to the LVGL APIs are not thread-safe
    if (example_lvgl_lock(-1)) {
        
        //my code 
        heartbeat_init();
        heartbeat_start();
        ui_init(); //squareline ui

        //lv_demo_widgets();      /* A widgets example */
        //lv_demo_music();        /* A modern, smartphone-like music player demo. */
        //lv_demo_stress();       /* A stress test for LVGL. */
        //lv_demo_benchmark();    /* A demo to measure the performance of LVGL or to compare different settings. */
        
        //clock demo
        //setup_ui(&guider_ui);
        //user_Init(&guider_ui);

        //Release the mutex
        example_lvgl_unlock();
    }
}

void setBrightnes(uint8_t brig)
{
    uint32_t lcd_cmd = 0x51;
    lcd_cmd &= 0xff;
    lcd_cmd <<= 8;
    lcd_cmd |= 0x02 << 24;
    uint8_t param = brig;
    esp_lcd_panel_io_tx_param(BrigPanelHandle, lcd_cmd, &param,1);
}
