TickingClocks/Zoetrope-Carousel-V4/Firmware/ESP32/1.91 ESP32-S3/reference examples/Fixing Figuring Things Out/main/auto_scroll.h

#ifndef AUTO_SCROLL_H
#define AUTO_SCROLL_H

#include "lvgl.h"

/**
 * @brief Starts an automatic one-time scroll past the splash image
 *
 * Call this once after ui_init()
 */
void auto_scroll_start(void);

#endif // AUTO_SCROLL_H
