TickingClocks/Zoetrope-Carousel-V4/Firmware/ESP32/1.91 ESP32-S3/reference examples/Fixing Figuring Things Out/main/platter_ui.h

#pragma once

void platter_ui_init(void);
void ui_sys_init_update(void);
void ui_pot_value_update(void);
void ui_system_state_update(void);
void ui_update_platter_speed_values(void);
void ui_update_frame_count(void);
void ui_frame_on_time_update(void);
void ui_update_motor_enabled(void);
