TickingClocks/Zoetrope-Carousel-V4/Firmware/ESP32/1.91 ESP32-S3/reference examples/Fixing Figuring Things Out/main/ui_highlight.h

#ifndef UI_HIGHLIGHT_H
#define UI_HIGHLIGHT_H

#include "lvgl.h"

/* Initialize highlight system
 * scroll_container = the vertical scrollable container
 */
void ui_highlight_init(lv_obj_t *scroll_container);

/* Call periodically to update highlight state */
void ui_highlight_update(void);

#endif /* UI_HIGHLIGHT_H */
