TickingClocks/Zoetrope-Carousel-V4/(commit log)

2026-05-01 fresh repo
    [10x15x4 bearing_V1.SLDPRT, 1985195.stp, 20 slice 200mm pattern.DXF, 20T 2GT 5mm Pully_V1.SLDPRT, 20slices200mm.SLDPRT, 2GT 200mm Belt_V1.SLDPRT, 3 digit 7 segment display mount_V1.SLDPRT, 60T 2GT 5mm Pully_V1.SLDPRT]
2026-05-01 ignore kicad .history folders -messes with git of overall project
    [PoweredPlatter2_MainBoard_V1.kicad_pcb, PoweredPlatter2_MainBoard_V1.kicad_sch]
2026-05-02 second powered platter main PCB designed and ready for CNC milling
    [Connectors.kicad_sch, MCU.kicad_sch, PoweredPlatter2_MainBoard_V1.kicad_pcb, PoweredPlatter2_MainBoard_V1.kicad_sch, level shifting.kicad_sch]
2026-05-02 adding LED Blade for Powered Platter 2. PCBs are being milled, 3D print needs to still be designed
    [Motor & LEDs_sch.kicad_sch, PoweredPlatter2_LED Blade_V1.kicad_pcb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]
2026-05-04 adding HTML BOMs for Powered Platter V2 - building hardware now
    [PoweredPlatter2_LED Blade_V1.kicad_pcb, PoweredPlatter2_MainBoard_V1.kicad_pcb]
2026-05-05 small updates - pushing to move to other computer
    [MCU.kicad_sch, level shifting.kicad_sch]
2026-05-07 adding updated 3D print frame for powered platter v2
    [Pixel Platter 3D Print_V2.SLDPRT, Pixel Platter 3D Print_V2.STEP, Pixel Platter 3D Print_V3.STEP]
2026-05-07 adding base project and cubeMX for powered platter v2
2026-05-08 built and validated powered platter_V2 design. this update includes the first program for this hardware. this program will makes a display 150x7 pixels wrapped around the entire platter. It can tell 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
2026-05-12 fixed bug where extra LEDs were turned ON
    [main.c]
2026-05-14 maxed out timer5 to calculate time at the finest resolution possible (1us / 45). *45 additions have been added throughout to fix other calculations. Would be worth updating or adding a few more varia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
    [Animation_Platter_V4_Playground.ioc, ESP_UART.c, machine interface.c, main.c]
2026-05-17 incremental updates to powered platter program, creating a font to be able to be used. Capitol fonts done, not tested. Lower case fonts started. Numbers to be added. Saving prior to my work trip
