TickingClocks/Zoetrope-Carousel-V4/(notices)

Notices in the files:
Firmware/STM32/Animation_Platter_V4_Playground/Core/Src/main.c:
Copyright (c) 2025 STMicroelectronics.
All rights reserved.
This software is licensed under terms that can be found in the LICENSE file
Firmware/STM32/Powered Platter_V2/PoweredPlatter_V2/Core/Inc/main.h:
Copyright (c) 2026 STMicroelectronics.
